LuZening/6x2-Antenna-Switch/manual/relay_cable.jpg

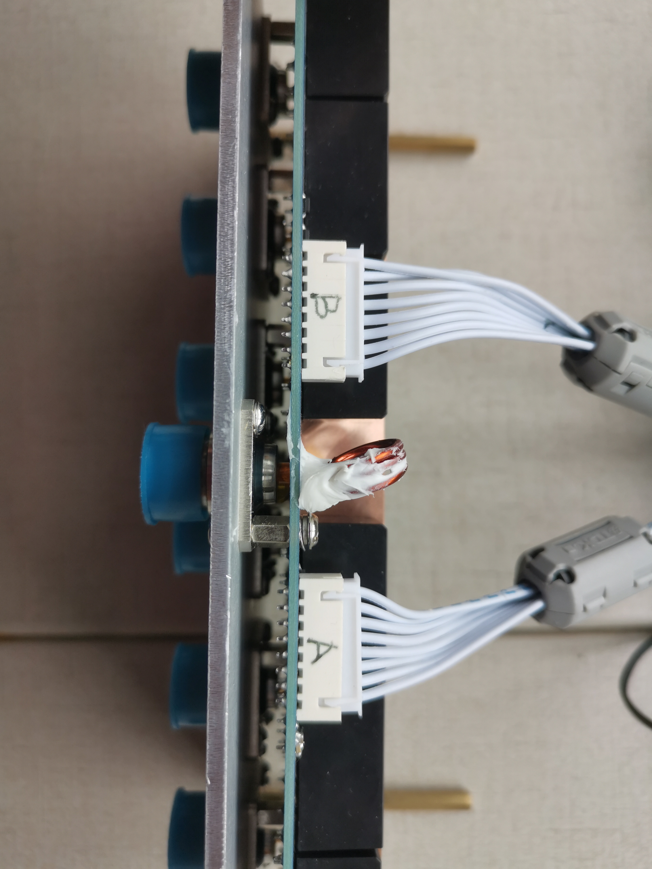
manual/relay_cable.jpg
