LuZening/6x2-Antenna-Switch/manual/changeA.jpg

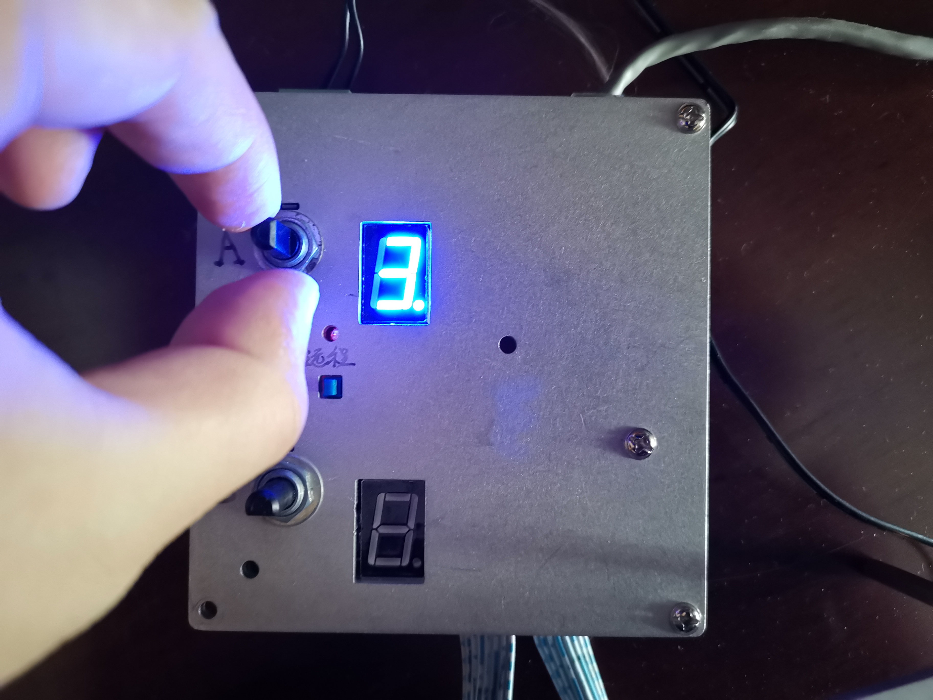
manual/changeA.jpg
