LuZening/6x2-Antenna-Switch/pictures/QUARTUS.PNG

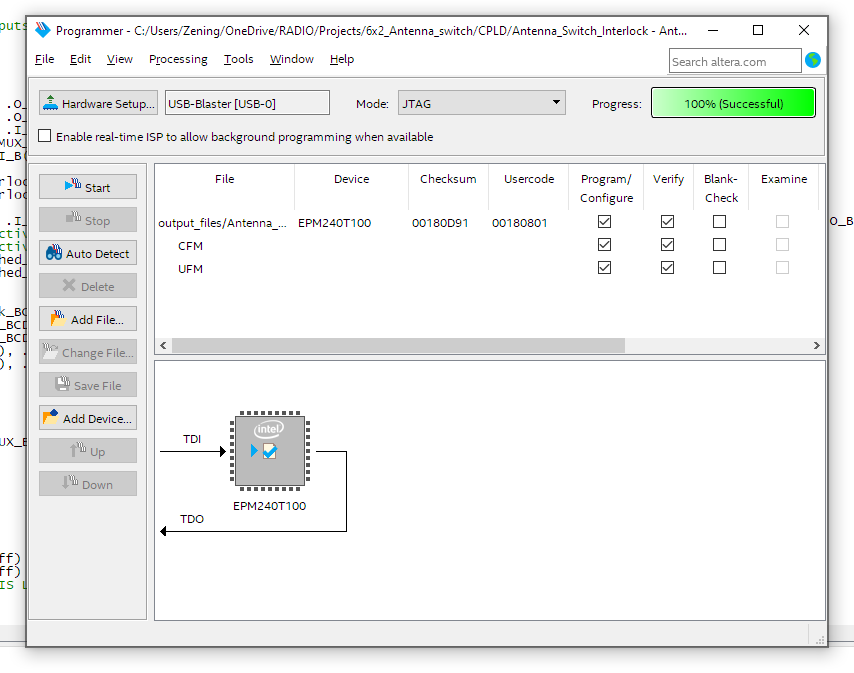
pictures/QUARTUS.PNG
