LuZening/6x2-Antenna-Switch/PCB/history_versions/ControlBoard-2/BOM_190349A_Y10.xls

客户BOM清单 |  |  |  |  |  |  |  |  | 嘉立创用料信息
Comment | Description | Designator | Footprint | LibRef | Pins | Quantity | PartNumber | url | 匹配类型 | 匹配方式 | 匹配来源 | 顶层位号 | 顶层数 | 顶层贴装 | 底层位号 | 底层数 | 底层贴装 | 元件编号 | X-ray检查 | 贴装总数量 | 焊点总数量 | 焊点费小计 | 库类型 | 组装方式 | 元件名称 | 封装规格 | 最小起订数量 | 损耗数量 | 元器件来源 | 使用预订数量 | 工厂提供数量 | 工厂元件单价 | 工厂元件小计 | 收费原因
300 | desc | R57, | 0603_R | libref | 2 | 1 |  |  | 系统识别 | 自动匹配 | 规则匹配 | R57 | 1 | 已贴装 |  | 0 | 未贴装 | C23025 | 不需要 | 2 | 4 | 0.0400 | 基础库 | 贴装 | 300Ω (3000) ±1% | 0603WAF3000T5E | 0603 | 0 | 0 | 嘉立创 | 0 | 2 | 0.0344 | 0.0688 | null
33 | desc | R17,R16,R15,R8,R6,R4,R2,R1,R14,R13,R12,R11,R9,R7,R5,R3, | 0603_R | libref | 2 | 16 |  |  | 系统识别 | 手动匹配 |  | R17, R16, R15, R8, R6, R4, R2, R1, R14, R13, R12, R11, R9, R7, R5, R3 | 16 | 已贴装 |  | 0 | 未贴装 | C23140 | 不需要 | 32 | 64 | 0.6400 | 基础库 | 贴装 | 33Ω (33R0) ±1% | 0603WAF330JT5E | 0603 | 0 | 0 | 嘉立创 | 0 | 32 | 0.0104 | 0.3328 | null
8050 | desc | Q14,Q13,Q12,Q11,Q10,Q9,Q8,Q7,Q6,Q5,Q4,Q3, | SOT-23(SOT-23-3) | libref | 3 | 12 |  |  | 手动调整 | 手动匹配 |  | Q14, Q13, Q12, Q11, Q10, Q9, Q8, Q7, Q6, Q5, Q4, Q3 | 12 | 已贴装 |  | 0 | 未贴装 | C2145 | 不需要 | 24 | 72 | 0.7200 | 基础库 | 贴装 | MMBT5551 | MMBT5551 | SOT-23 | 0 | 0 | 嘉立创 | 0 | 24 | 0.1376 | 3.3024 | null
47pF | desc | C38, | 0603_C | libref | 2 | 1 |  |  | 系统识别 | 手动匹配 |  | C38 | 1 | 已贴装 |  | 0 | 未贴装 | C1671 | 不需要 | 2 | 4 | 0.0400 | 基础库 | 贴装 | 47pF (470) ±5% 50V C0G | CL10C470JB8NNNC | 0603 | 0 | 0 | 嘉立创 | 0 | 2 | 0.1265 | 0.2530 | null
12K | desc | R51, | 0603_R | libref | 2 | 1 |  |  | 系统识别 | 自动匹配 | 规则匹配 | R51 | 1 | 已贴装 |  | 0 | 未贴装 | C22790 | 不需要 | 2 | 4 | 0.0400 | 基础库 | 贴装 | 12KΩ (1202) ±1% | 0603WAF1202T5E | 0603 | 0 | 0 | 嘉立创 | 0 | 2 | 0.0131 | 0.0262 | null
49.9 | desc | R49,R48,R45,R44, | 0603_R | libref | 2 | 4 |  |  | 系统识别 | 手动匹配 |  | R49, R48, R45, R44 | 4 | 已贴装 |  | 0 | 未贴装 | C23185 | 不需要 | 8 | 16 | 0.1600 | 基础库 | 贴装 | 49.9Ω (49R9) ±1% | 0603WAF499JT5E | 0603 | 0 | 0 | 嘉立创 | 0 | 8 | 0.0122 | 0.0976 | null
8550 | desc | Q26,Q25,Q24,Q23,Q22,Q21,Q20,Q19,Q18,Q17,Q16,Q15,Q2,Q1, | SOT-23(SOT-23-3) | libref | 3 | 14 |  |  | 手动调整 | 手动匹配 |  | Q26, Q25, Q24, Q23, Q22, Q21, Q20, Q19, Q18, Q17, Q16, Q15, Q2, Q1 | 14 | 已贴装 |  | 0 | 未贴装 | C8326 | 不需要 | 28 | 84 | 0.8400 | 基础库 | 贴装 | MMBT5401 | MMBT5401 | SOT-23 | 0 | 0 | 嘉立创 | 0 | 28 | 0.1414 | 3.9592 | null
MAX485E | desc | U6, | SOIC-8_W3.9mm | libref | 8 | 1 |  |  | 系统识别 | 手动匹配 |  | U6 | 1 | 已贴装 |  | 0 | 未贴装 | C8963 | 不需要 | 2 | 16 | 0.1600 | 基础库 | 贴装 | SP3485EN-L/TR | SP3485EN-L/TR | SOIC-8 | 0 | 0 | 嘉立创 | 0 | 2 | 2.7328 | 5.4656 | null
0 | desc | R20, | 1206_R | libref | 2 | 1 |  |  | 系统识别 | 自动匹配 | 规则匹配 | R20 | 1 | 已贴装 |  | 0 | 未贴装 | C17888 | 不需要 | 2 | 4 | 0.0400 | 基础库 | 贴装 | 0Ω (0R0) ±1% | 1206W4F0000T5E | 1206 | 0 | 0 | 嘉立创 | 0 | 2 | 0.0282 | 0.0564 | null
10pF | desc | C34,C35, | 0603_C | libref | 2 | 2 |  |  | 系统识别 | 手动匹配 |  | C34, C35 | 2 | 已贴装 |  | 0 | 未贴装 | C1634 | 不需要 | 4 | 8 | 0.0800 | 基础库 | 贴装 | 10pF (100) ±5% 50V C0G | CL10C100JB8NNNC | 0603 | 0 | 0 | 嘉立创 | 0 | 4 | 0.0464 | 0.1856 | null
104 | desc | C43,C8,C6,C39,C36,C33,C32,C31,C30,C29,C28,C26,C25,C24,C23,C22,C21,C20,C19,C18,C17,C16,C15,C14,C13,C12,C9,C7,C5,C4,C3,C2,C1, | 0603_C | libref | 2 | 33 |  |  | 系统识别 | 手动匹配 |  | C43, C8, C6, C39, C36, C33, C32, C31, C30, C29, C28, C26, C25, C24, C23, C22, C21, C20, C19, C18, C17, C16, C15, C14, C13, C12, C9, C7, C5, C4, C3, C2, C1 | 33 | 已贴装 |  | 0 | 未贴装 | C14663 | 不需要 | 66 | 132 | 1.3200 | 基础库 | 贴装 | 100nF (104) ±10% 50V X7R | CC0603KRX7R9BB104 | 0603 | 0 | 0 | 嘉立创 | 0 | 66 | 0.0349 | 2.3034 | null
10nF | desc | C37, | 0603_C | libref | 2 | 1 |  |  | 系统识别 | 手动匹配 |  | C37 | 1 | 已贴装 |  | 0 | 未贴装 | C57112 | 不需要 | 2 | 4 | 0.0400 | 基础库 | 贴装 | 10nF (103) ±10% 50V X7R | 0603B103K500NT | 0603 | 0 | 0 | 嘉立创 | 0 | 2 | 0.0266 | 0.0532 | null
10K | desc | R50, | 0603_R | libref | 2 | 1 |  |  | 系统识别 | 自动匹配 | 规则匹配 | R50 | 1 | 已贴装 |  | 0 | 未贴装 | C25804 | 不需要 | 2 | 4 | 0.0400 | 基础库 | 贴装 | 10KΩ (1002) ±1% | 0603WAF1002T5E | 0603 | 0 | 0 | 嘉立创 | 0 | 2 | 0.0104 | 0.0208 | null
STM32F030C8Tx | desc | U5, | LQFP-48_7X7X05P | libref | 48 | 1 |  |  | 手动调整 | 手动匹配 |  | U5 | 1 | 已贴装 |  | 0 | 未贴装 | C23922 | 不需要 | 2 | 96 | 0.9600 | 基础库 | 贴装 | STM32F030C8T6 | STM32F030C8T6 | LQFP-48(7x7) | 0 | 0 | 嘉立创 | 0 | 2 | 5.7543 | 11.5086 | null
100K | desc | R59*1,R56,R55, | 0603_R | libref | 2 | 3 |  |  | 系统识别 | 手动匹配 |  | R59*1, R56, R55 | 3 | 已贴装 |  | 0 | 未贴装 | C25803 | 不需要 | 6 | 12 | 0.1200 | 基础库 | 贴装 | 100KΩ (1003) ±1% | 0603WAF1003T5E | 0603 | 0 | 0 | 嘉立创 | 0 | 6 | 0.0104 | 0.0624 | null
2.2uF | desc | C11, | 0805_C | libref | 2 | 1 |  |  | 系统识别 | 手动匹配 |  | C11 | 1 | 已贴装 |  | 0 | 未贴装 | C49217 | 不需要 | 4 | 8 | 0.0800 | 基础库 | 贴装 | 2.2uF (225) ±20% 50V Y5V | 0805F225M500NT | 0805 | 0 | 0 | 嘉立创 | 0 | 4 | 0.1624 | 0.6496 | null
4.7uF25V | desc | C40, | 0805_C | libref | 2 | 1 |  |  | 手动调整 | 手动匹配 |  | C40 | 1 | 已贴装 |  | 0 | 未贴装 | C49217 | 不需要
100 | desc | R52, | 0603_R | libref | 2 | 1 |  |  | 系统识别 | 自动匹配 | 规则匹配 | R52 | 1 | 已贴装 |  | 0 | 未贴装 | C22775 | 不需要 | 2 | 4 | 0.0400 | 基础库 | 贴装 | 100Ω (1000) ±1% | 0603WAF1000T5E | 0603 | 0 | 0 | 嘉立创 | 0 | 2 | 0.0104 | 0.0208 | null
4.7K | desc | R37,R36,R35,R34,R33,R32,R31,R30,R29,R28,R27,R26,R25, | 0603_R | libref | 2 | 13 |  |  | 手动调整 | 手动匹配 |  | R37, R36, R35, R34, R33, R32, R31, R30, R29, R28, R27, R26, R25 | 13 | 已贴装 |  | 0 | 未贴装 | C4190 | 不需要 | 26 | 52 | 0.5200 | 基础库 | 贴装 | 2.2KΩ (2201) ±1% | 0603WAF2201T5E | 0603 | 0 | 0 | 嘉立创 | 0 | 26 | 0.0106 | 0.2756 | null
22uF | desc | C42,C10, | 0805_C | libref | 2 | 2 |  |  | 系统识别 | 手动匹配 |  | C42, C10 | 2 | 已贴装 |  | 0 | 未贴装 | C45783 | 不需要 | 4 | 8 | 0.0800 | 基础库 | 贴装 | 22uF (226) ±20% 25V X5R | CL21A226MAQNNNE | 0805 | 0 | 0 | 嘉立创 | 0 | 4 | 0.2299 | 0.9196 | null
51K | desc | R59, | 0603_R | libref | 2 | 1 |  |  | 系统识别 | 自动匹配 | 规则匹配 | R59 | 1 | 已贴装 |  | 0 | 未贴装 | C23196 | 不需要 | 2 | 4 | 0.0400 | 基础库 | 贴装 | 51KΩ (5102) ±1% | 0603WAF5102T5E | 0603 | 0 | 0 | 嘉立创 | 0 | 2 | 0.0142 | 0.0284 | null
1K | desc | R19,R54,R10,R53,R18, | 0603_R | libref | 2 | 5 |  |  | 系统识别 | 手动匹配 |  | R19, R54, R10, R53, R18 | 5 | 已贴装 |  | 0 | 未贴装 | C21190 | 不需要 | 10 | 20 | 0.2000 | 基础库 | 贴装 | 1KΩ (1001) ±1% | 0603WAF1001T5E | 0603 | 0 | 0 | 嘉立创 | 0 | 10 | 0.0104 | 0.1040 | null
10uF | desc | C41, | 0805_C | libref | 2 | 1 |  |  | 系统识别 | 手动匹配 |  | C41 | 1 | 已贴装 |  | 0 | 未贴装 | C15850 | 不需要 | 2 | 4 | 0.0400 | 基础库 | 贴装 | 10uF (106) ±10% 25V X5R | CL21A106KAYNNNE | 0805 | 0 | 0 | 嘉立创 | 0 | 2 | 0.1408 | 0.2816 | null
15K | desc | R58, | 0603_R | libref | 2 | 1 |  |  | 系统识别 | 自动匹配 | 规则匹配 | R58 | 1 | 已贴装 |  | 0 | 未贴装 | C22809 | 不需要 | 2 | 4 | 0.0400 | 基础库 | 贴装 | 15KΩ (1502) ±1% | 0603WAF1502T5E | 0603 | 0 | 0 | 嘉立创 | 0 | 2 | 0.0109 | 0.0218 | null
47K | desc | R61,R60,R43,R42,R41,R40,R39,R38,R24,R23,R22,R21, | 0603_R | libref | 2 | 12 |  |  | 系统识别 | 手动匹配 |  | R61, R60, R43, R42, R41, R40, R39, R38, R24, R23, R22, R21 | 12 | 已贴装 |  | 0 | 未贴装 | C25819 | 不需要 | 24 | 48 | 0.4800 | 基础库 | 贴装 | 47KΩ (4702) ±1% | 0603WAF4702T5E | 0603 | 0 | 0 | 嘉立创 | 0 | 24 | 0.0256 | 0.6144 | null
SS34 | desc | D3, | SMA(DO-214AC)_S3 | libref | 2 | 1 |  |  | 手动调整 | 手动匹配 |  | D3 | 1 | 已贴装 |  | 0 | 未贴装 | C2480 | 不需要 | 2 | 4 | 0.0400 | 基础库 | 贴装 | SS14 | SS14 | SMA(DO-214AC) | 0 | 0 | 嘉立创 | 0 | 2 | 0.1041 | 0.2082 | null
330 | desc | R47,R46, | 0603_R | libref | 2 | 2 |  |  | 系统识别 | 手动匹配 |  | R47, R46 | 2 | 已贴装 |  | 0 | 未贴装 | C23138 | 不需要 | 4 | 8 | 0.0800 | 基础库 | 贴装 | 330Ω (3300) ±1% | 0603WAF3300T5E | 0603 | 0 | 0 | 嘉立创 | 0 | 4 | 0.0122 | 0.0488 | null
<-以下为不贴装的元件->
CH395Q | desc | U4 | LQFP-64_10X10X05P | libref | 64 | 1
ThroughHoleItems
1A | desc | F1 | R_1812_HandSoldering | libref | 2 | 1
BlasterJTAG | desc | J1 | JTAG_10 | libref | 10 | 1
Remote | desc | D1 | LED_D3.0mm | libref | 2 | 1
AZ1117-3.3 | desc | U8 | SOT-223 | libref | 4 | 1
SWD | desc | J6 | Pin_Header_Straight_1x04_Pitch2.54mm | libref | 4 | 1
Conn_01x01 | desc | J2 | PINTST | libref | 1 | 1
RST | desc | J9 | PINTST | libref | 1 | 1
30MHz | desc | Y1 | Crystal_SMD_3225-4pin_3.2x2.5mm | libref | 4 | 1
SY8303 | desc | U7 | TSOT-23-8_HandSoldering | libref | 8 | 1
HR913550A | desc | J5 | HR913550A | libref | 16 | 1
100K | desc | RV1 | 3362P | libref | 3 | 1
REMOTE | desc | SW4 | K8-7071 | libref | 6 | 1
22uH1A | desc | L1 | L_SMD4030_hand | libref | 2 | 1
74HC04 | desc | U9,U2 | TSSOP-14 | libref | 14 | 2
Conn_01x08 | desc | J4,J3 | JST_XH_B08B-XH-A_08x2.50mm_Straight | libref | 8 | 2
AZ1117-1.8 | desc | U3 | SOT-223 | libref | 4 | 1
12VDC | desc | J8 | PhoenixContact_MSTBA-G_02x5.08mm_Angled | libref | 2 | 1
EPM240T100 | desc | U1 | LQFP-100_14X14X05P | libref | 100 | 1
Red | desc | D4 | LED_D3.0mm | libref | 2 | 1
Conn_01x01 | desc | SC4,SC3,SC2,SC1 | M3_Screwhole | libref | 7 | 4
SRBV170501 | desc | SW2,SW1 | SRBV170501 | libref | 12 | 2
0.56''BLUECA | desc | SEG1,SEG2 | 7SegmentLED_LTS6760_LTS6780 | libref | 10 | 2
485 | desc | J7 | PhoenixContact_MSTBA-G_03x5.08mm_Angled | libref | 3 | 1
LOAD | desc | SW3 | K8-7071 | libref | 6 | 1
16V | desc | D2 | LL-34 | libref | 2 | 1
