LuZening/6x2-Antenna-Switch/chasis/N母法兰小.step

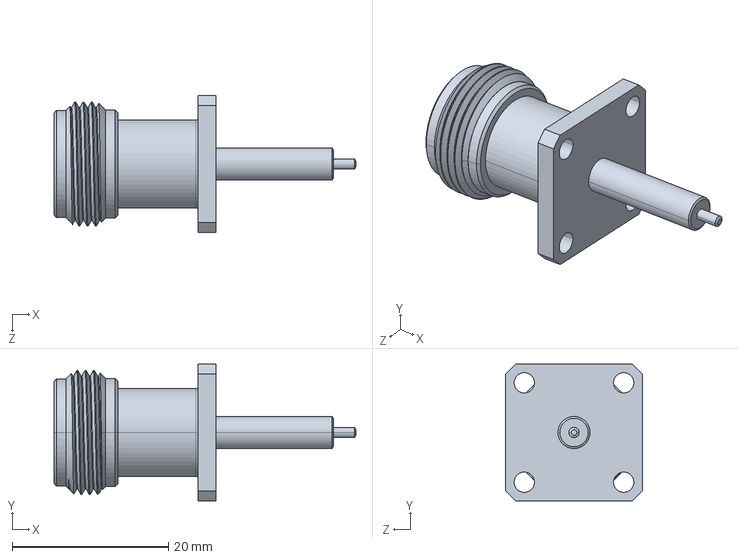
[picture p6: CAD file, 2024-03-04]
chasis/N母法兰小.step
38.6 x 17.5 x 17.5 mm
