LuZening/6x2-Antenna-Switch/chasis/AntennaSwitch_6x2_RelayBoard.step

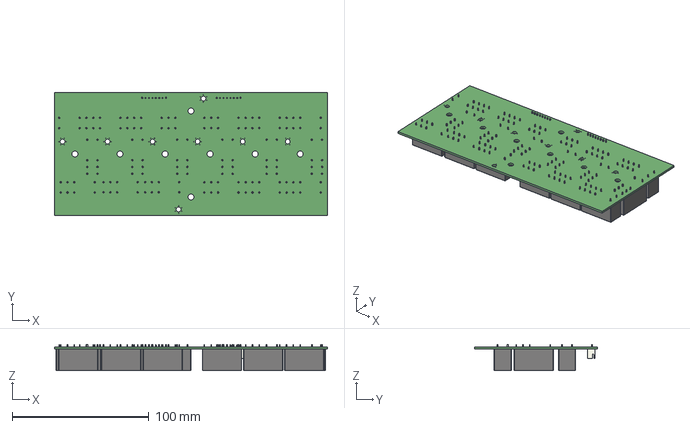
[picture p7: CAD file, 2024-03-04]
chasis/AntennaSwitch_6x2_RelayBoard.step
200.0 x 90.0 x 19.2 mm
