LuZening/6x2-Antenna-Switch/chasis/N母法兰大.step

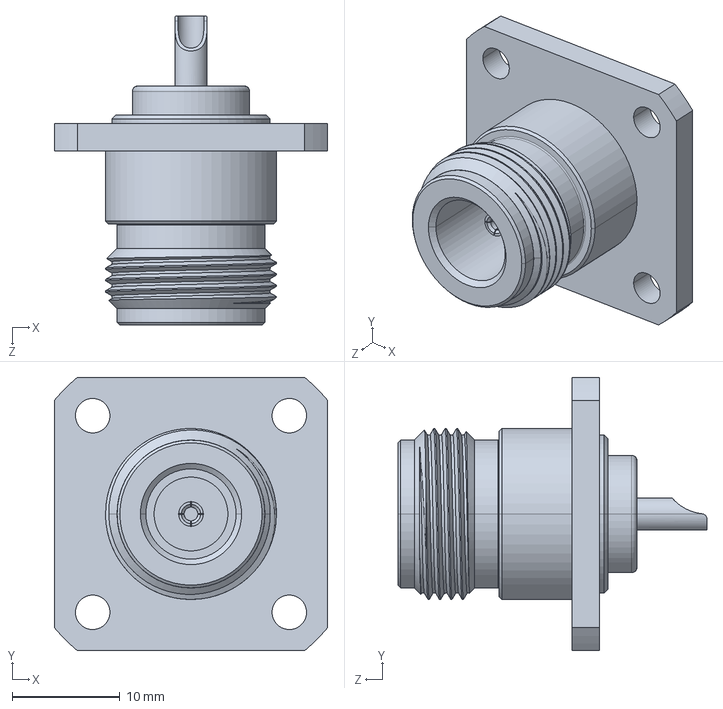
[picture p8: CAD file, 2024-03-04]
chasis/N母法兰大.step
25.4 x 25.4 x 28.7 mm
