LuZening/6x2-Antenna-Switch/chasis/防水盒320_120.SLDPRT

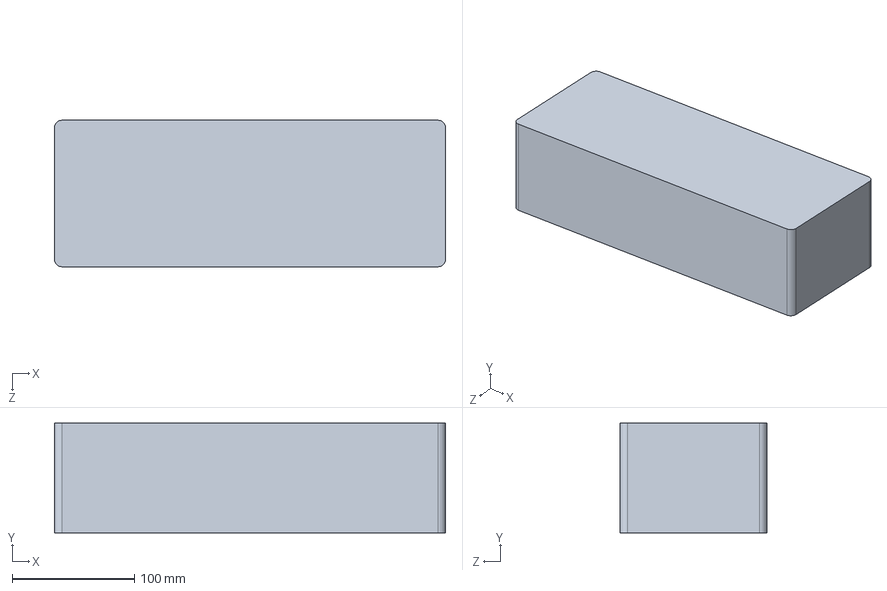
[picture p9: CAD file, 2024-03-04]
chasis/防水盒320_120.SLDPRT
320.0 x 90.0 x 120.0 mm
