LuZening/6x2-Antenna-Switch/(list of files, cad)

Other CAD files:
PCB/history_versions/RelayBoard/RelayBoard_Drill/RelayBoard_Drill.dwg
控制面板.dwg
接口板.dwg
chasis/VT38防水盒_antsw62_示意图.DWG
chasis/aseembled.DWG
chasis/VT38防水盒.dwg
chasis/AntennaSwitch_6x2_RelayBoard.SLDASM
chasis/N母法兰大.SLDPRT
chasis/aseembled.SLDDRW
