LuZening/6x2-Antenna-Switch/manual/all_back.jpg

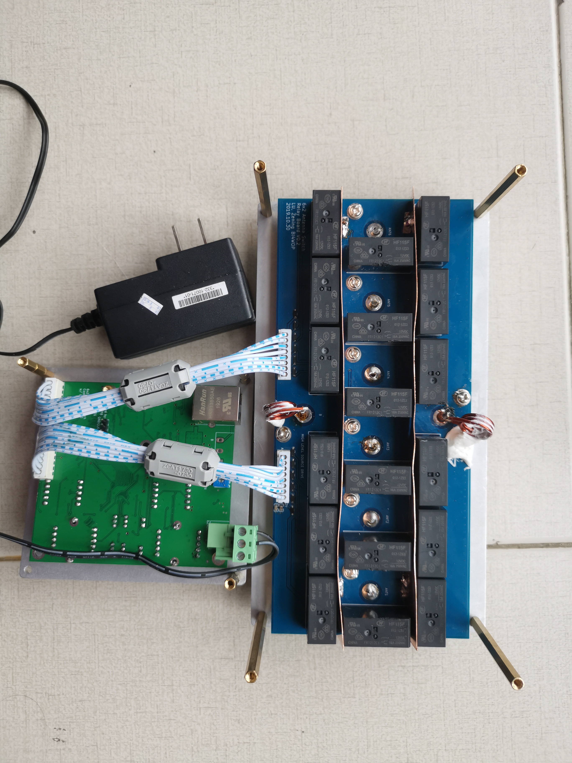
manual/all_back.jpg
