LuZening/6x2-Antenna-Switch/manual/control_cable.jpg

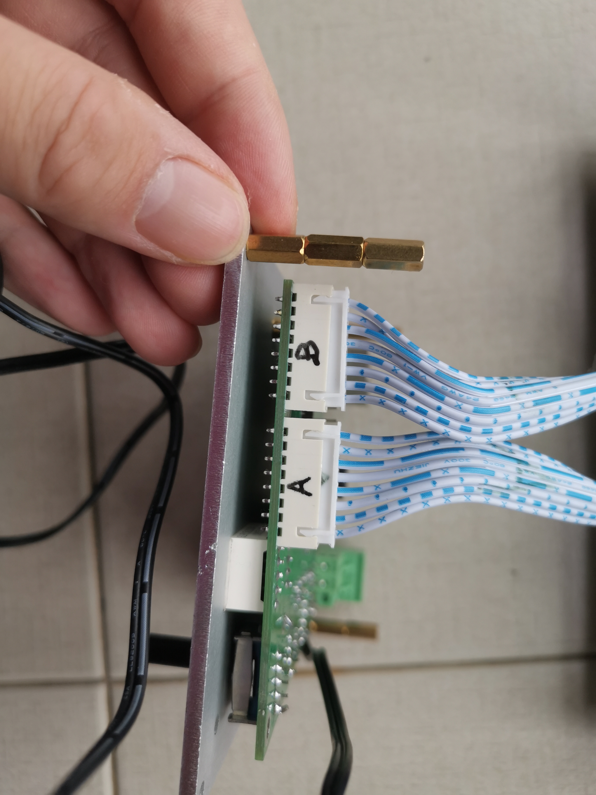
manual/control_cable.jpg
