LuZening/6x2-Antenna-Switch/manual/power.jpg

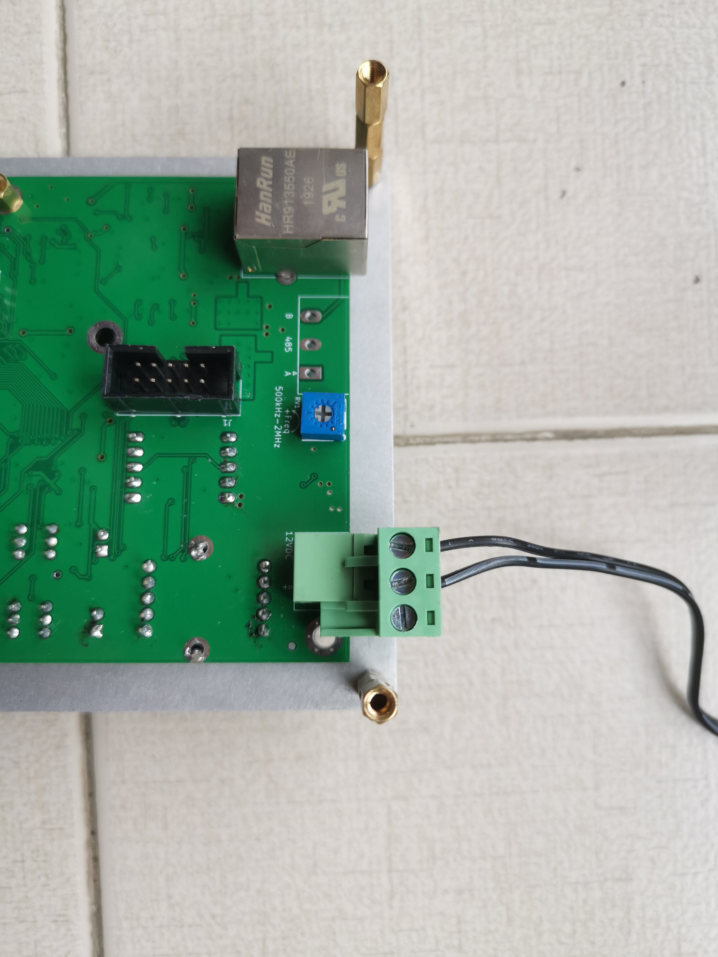
manual/power.jpg
