LuZening/6x2-Antenna-Switch/manual/start.jpg

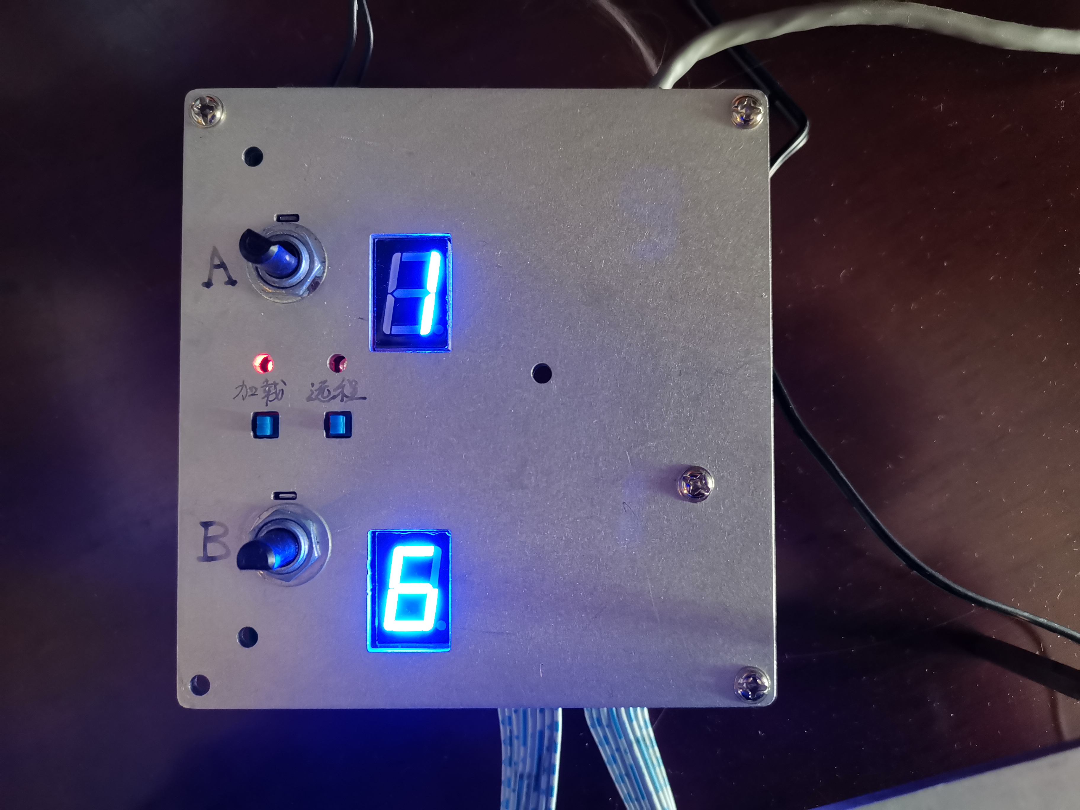
manual/start.jpg
