LuZening/6x2-Antenna-Switch/manual/switch.jpg

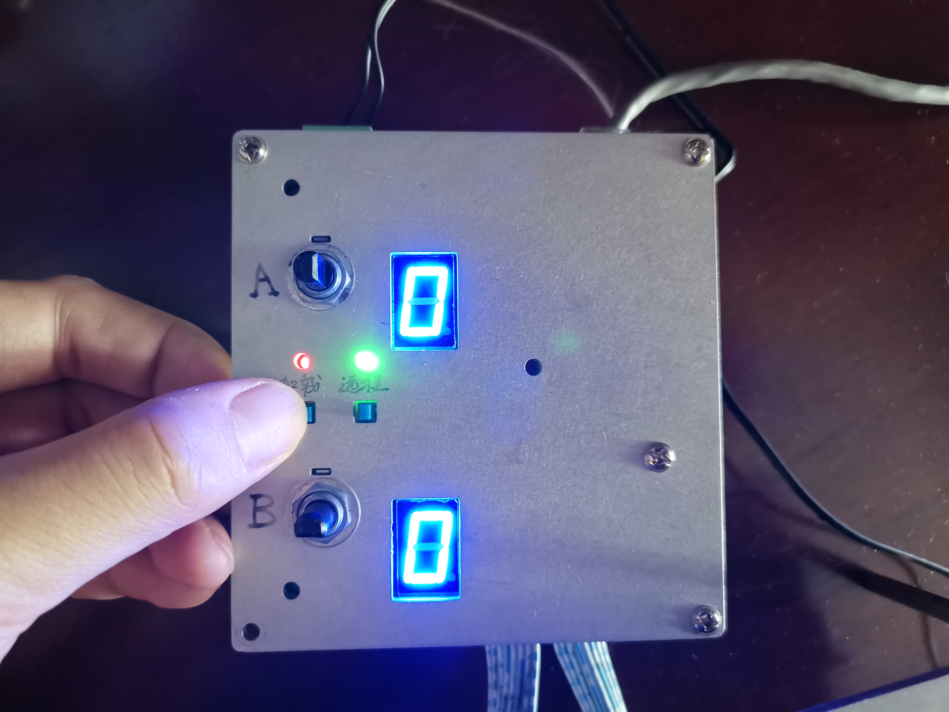
manual/switch.jpg
