LuZening/6x2-Antenna-Switch/manual/switched.jpg

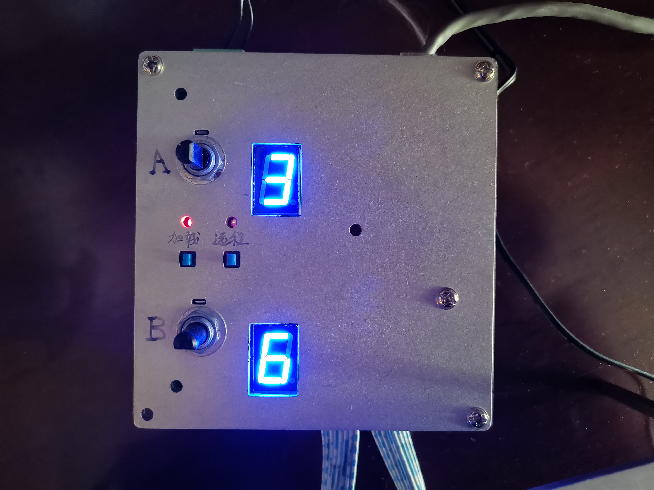
manual/switched.jpg
