LuZening/6x2-Antenna-Switch/PCB/history_versions/AntennaSwitch_6x2/gerber/AntennaSwitch_6x2-B.Cu.pdf

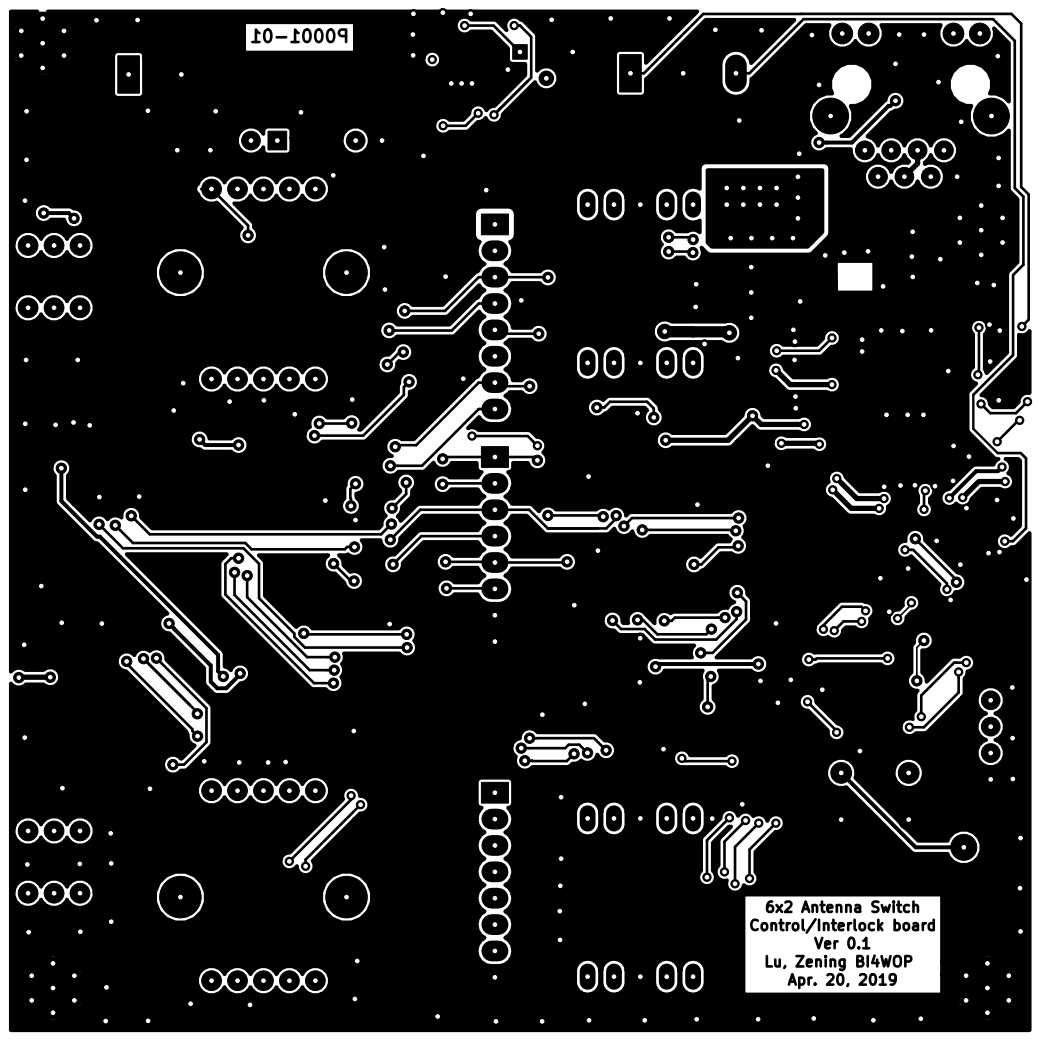
[picture p28: page 1]

6x2 Antenna Switch Control/Interlock board Ver 0.1 Lu, Zening BI4WOP Apr. 20, 2019
