LuZening/6x2-Antenna-Switch/PCB/history_versions/AntennaSwitch_6x2/gerber/AntennaSwitch_6x2-B.SilkS.pdf

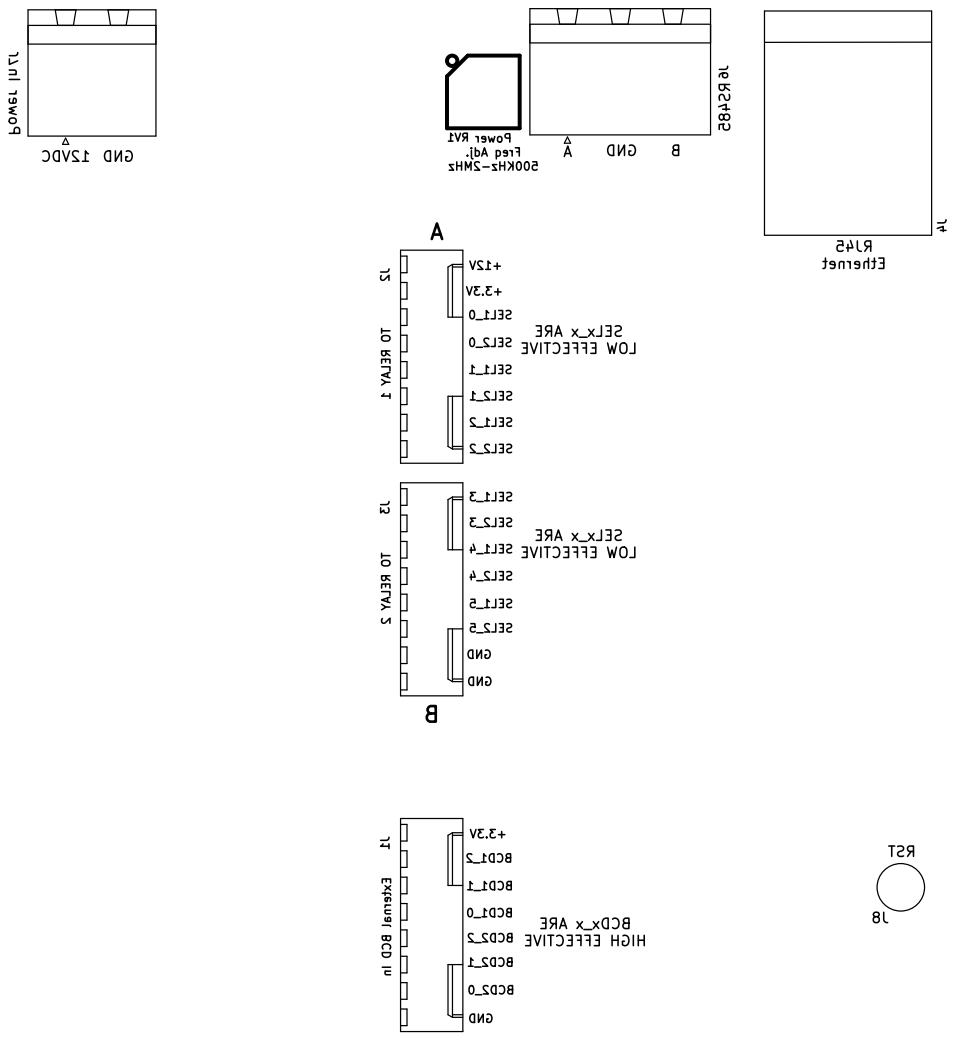
[picture p29: page 1]

+12V External BCD In TO RELAY 2 TO RELAY 1 J8 J4 J6 RV1 J7 J3 J2 J1

Power Freq Adj. 500KHz-2MHz 12VDC GND Power In SELx_x ARE

LOW EFFECTIVE BCDx_x ARE HIGH EFFECTIVE
