LuZening/6x2-Antenna-Switch/PCB/history_versions/AntennaSwitch_6x2/gerber/AntennaSwitch_6x2-B.Mask.pdf

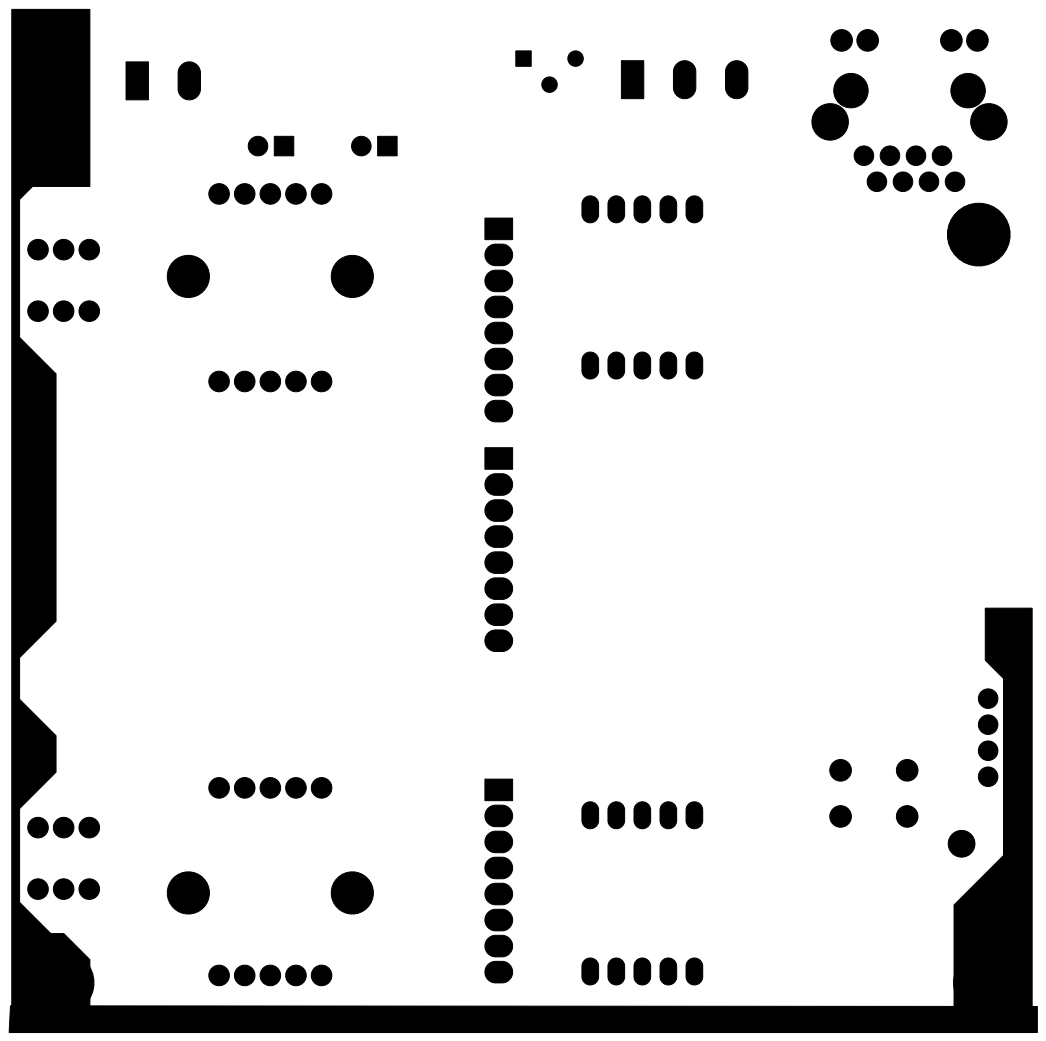
[picture p30: page 1]
