LuZening/6x2-Antenna-Switch/PCB/history_versions/AntennaSwitch_6x2/gerber/AntennaSwitch_6x2-F.Cu.pdf

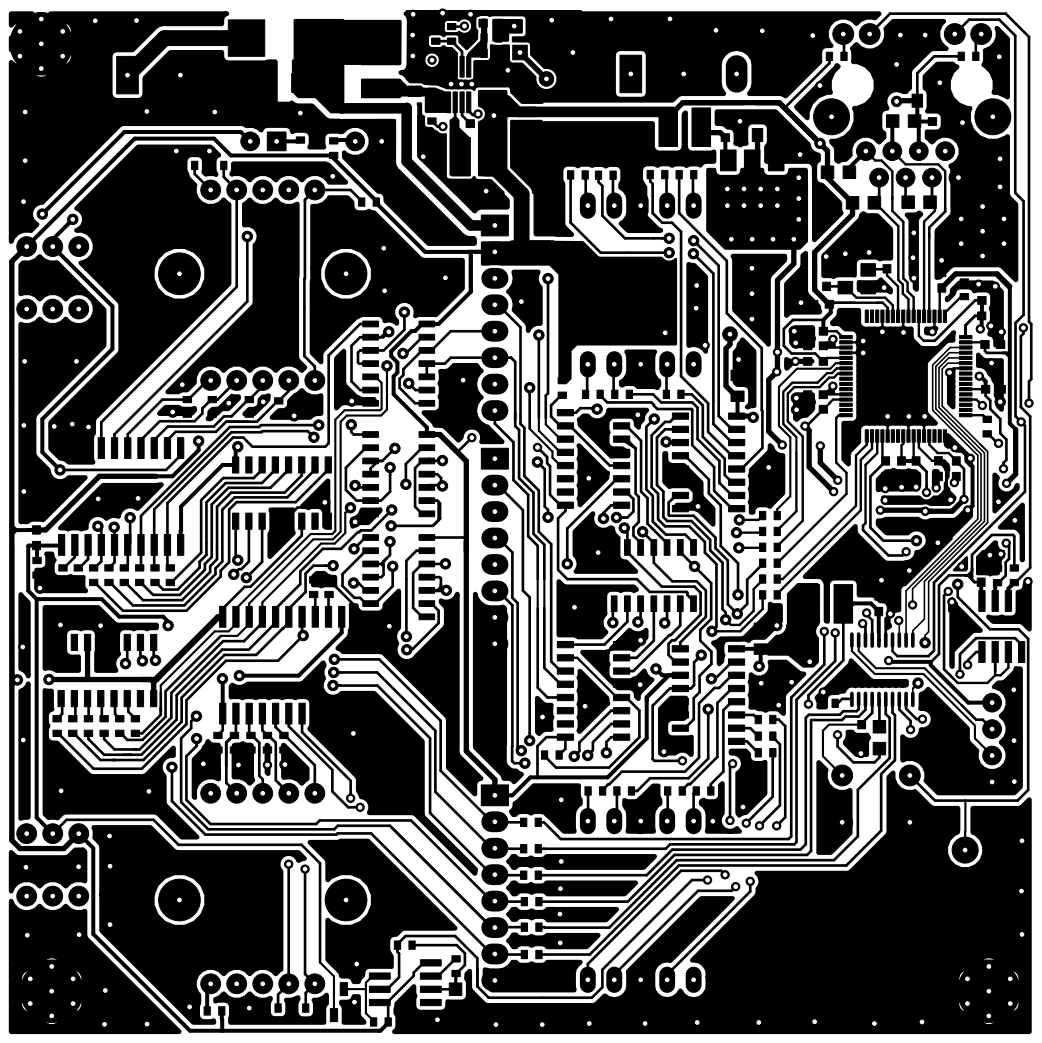
[picture p31: page 1]
