LuZening/6x2-Antenna-Switch/PCB/history_versions/AntennaSwitch_6x2/gerber/AntennaSwitch_6x2-F.Mask.pdf

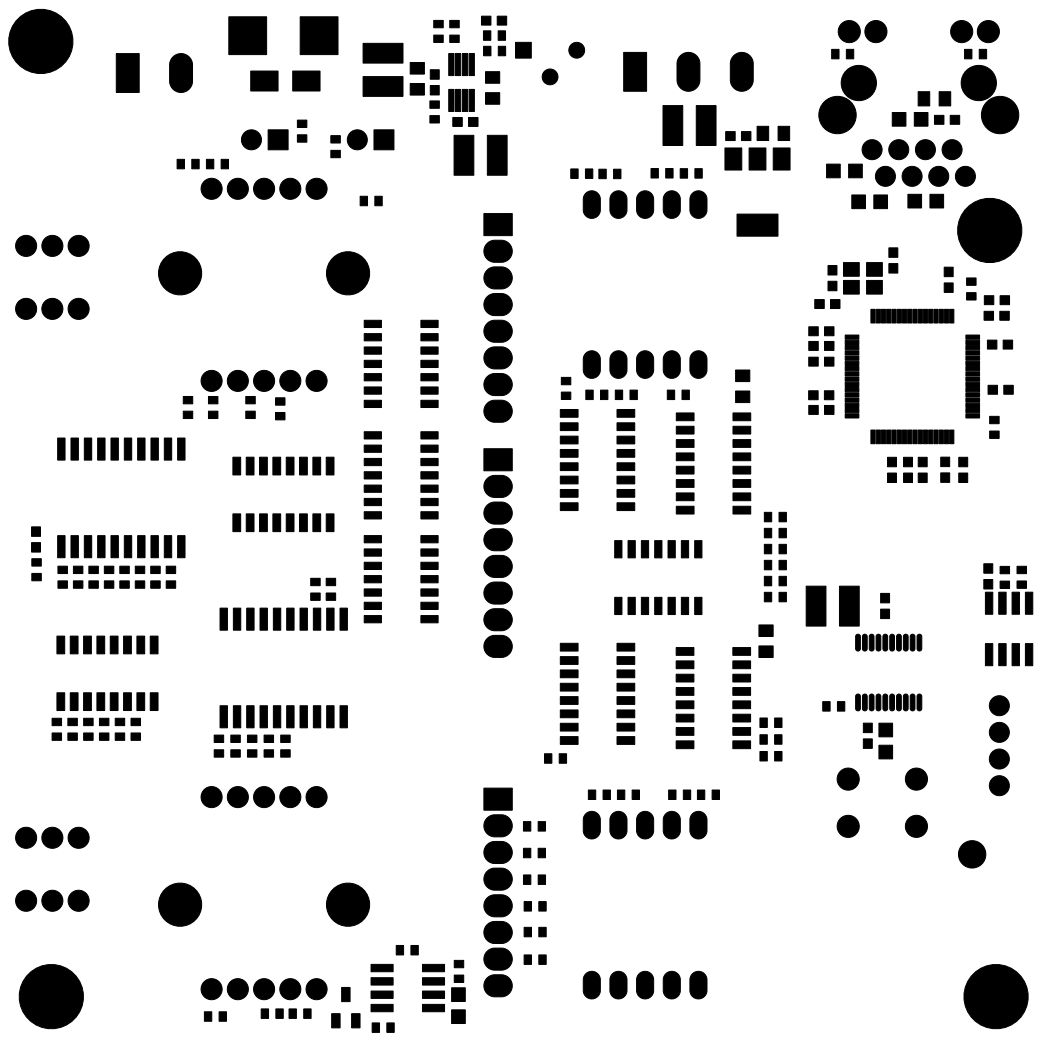
[picture p32: page 1]
