LuZening/6x2-Antenna-Switch/PCB/history_versions/AntennaSwitch_6x2/gerber/AntennaSwitch_6x2-F.SilkS.pdf

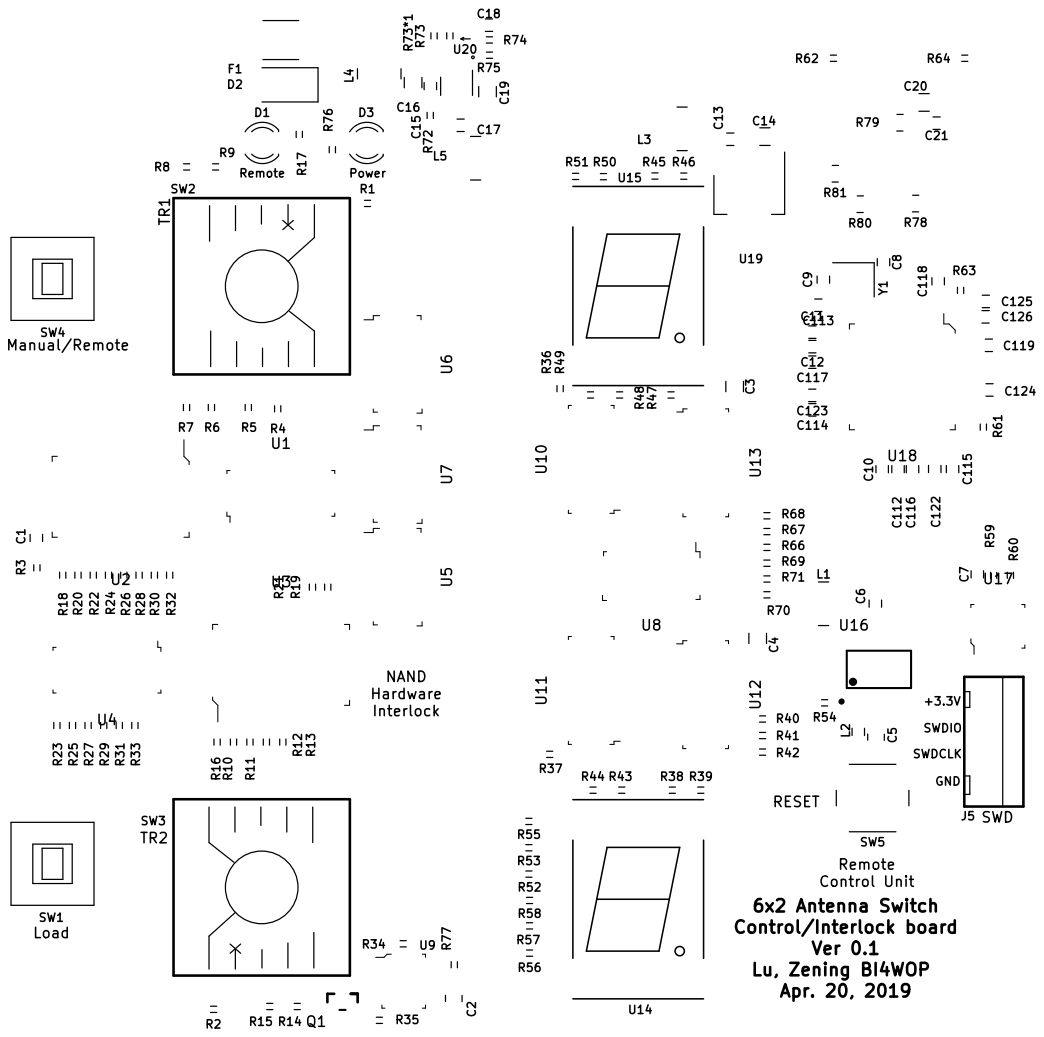
[picture p34: page 1]

Remote Control Unit NAND
Hardware
