LuZening/6x2-Antenna-Switch/PCB/history_versions/RelayBoard/RelayBoard_Drill/board_drill.pdf

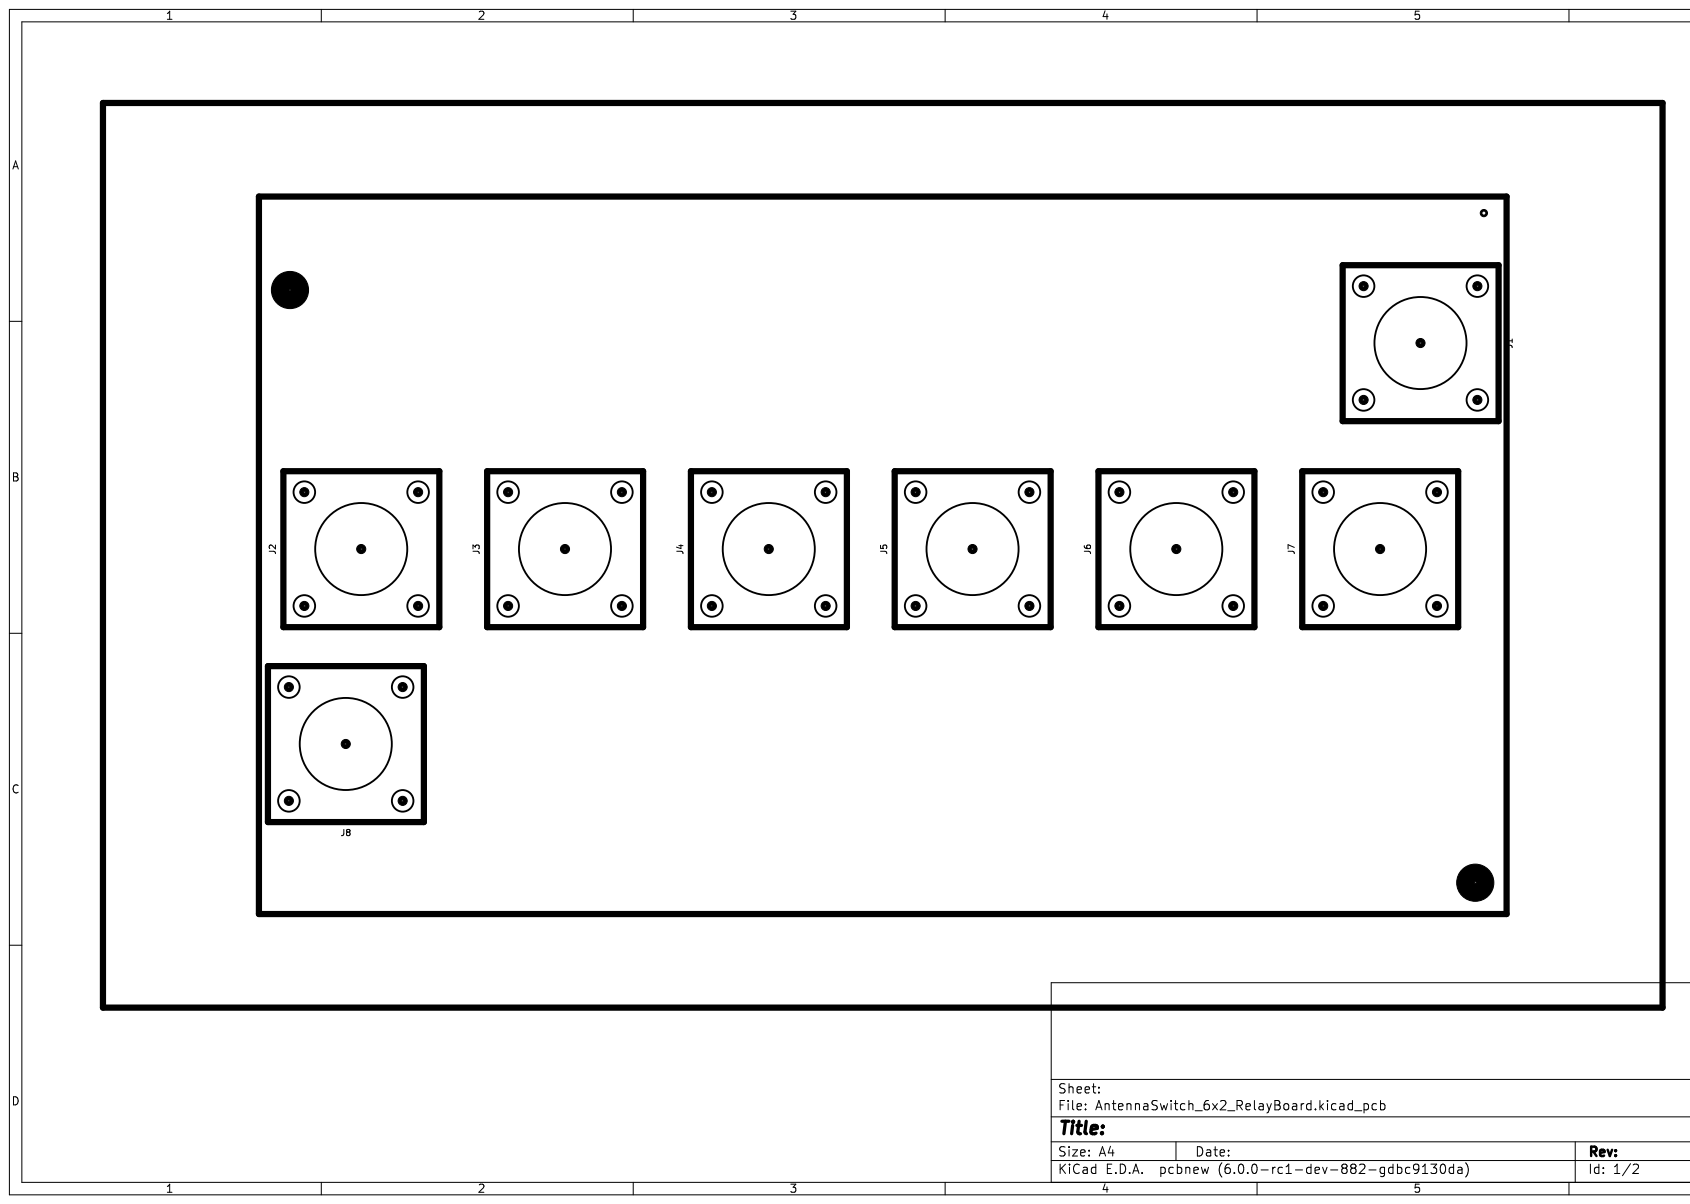
[picture p35: page 1]
