LuZening/6x2-Antenna-Switch/(list of files, drawings)

Other design files:
PCB/ControlBoard-3/AntennaSwitch_6x2.dsn
PCB/history_versions/ControlBoard-2/AntennaSwitch_6x2.dsn
