LuZening/6x2-Antenna-Switch/PCB/history_versions/ControlBoard-2/AntennaSwitch_6x2.kicad_pcb

## KiCad design PCB/history_versions/ControlBoard-2/AntennaSwitch_6x2.kicad_pcb (2024-03-04)

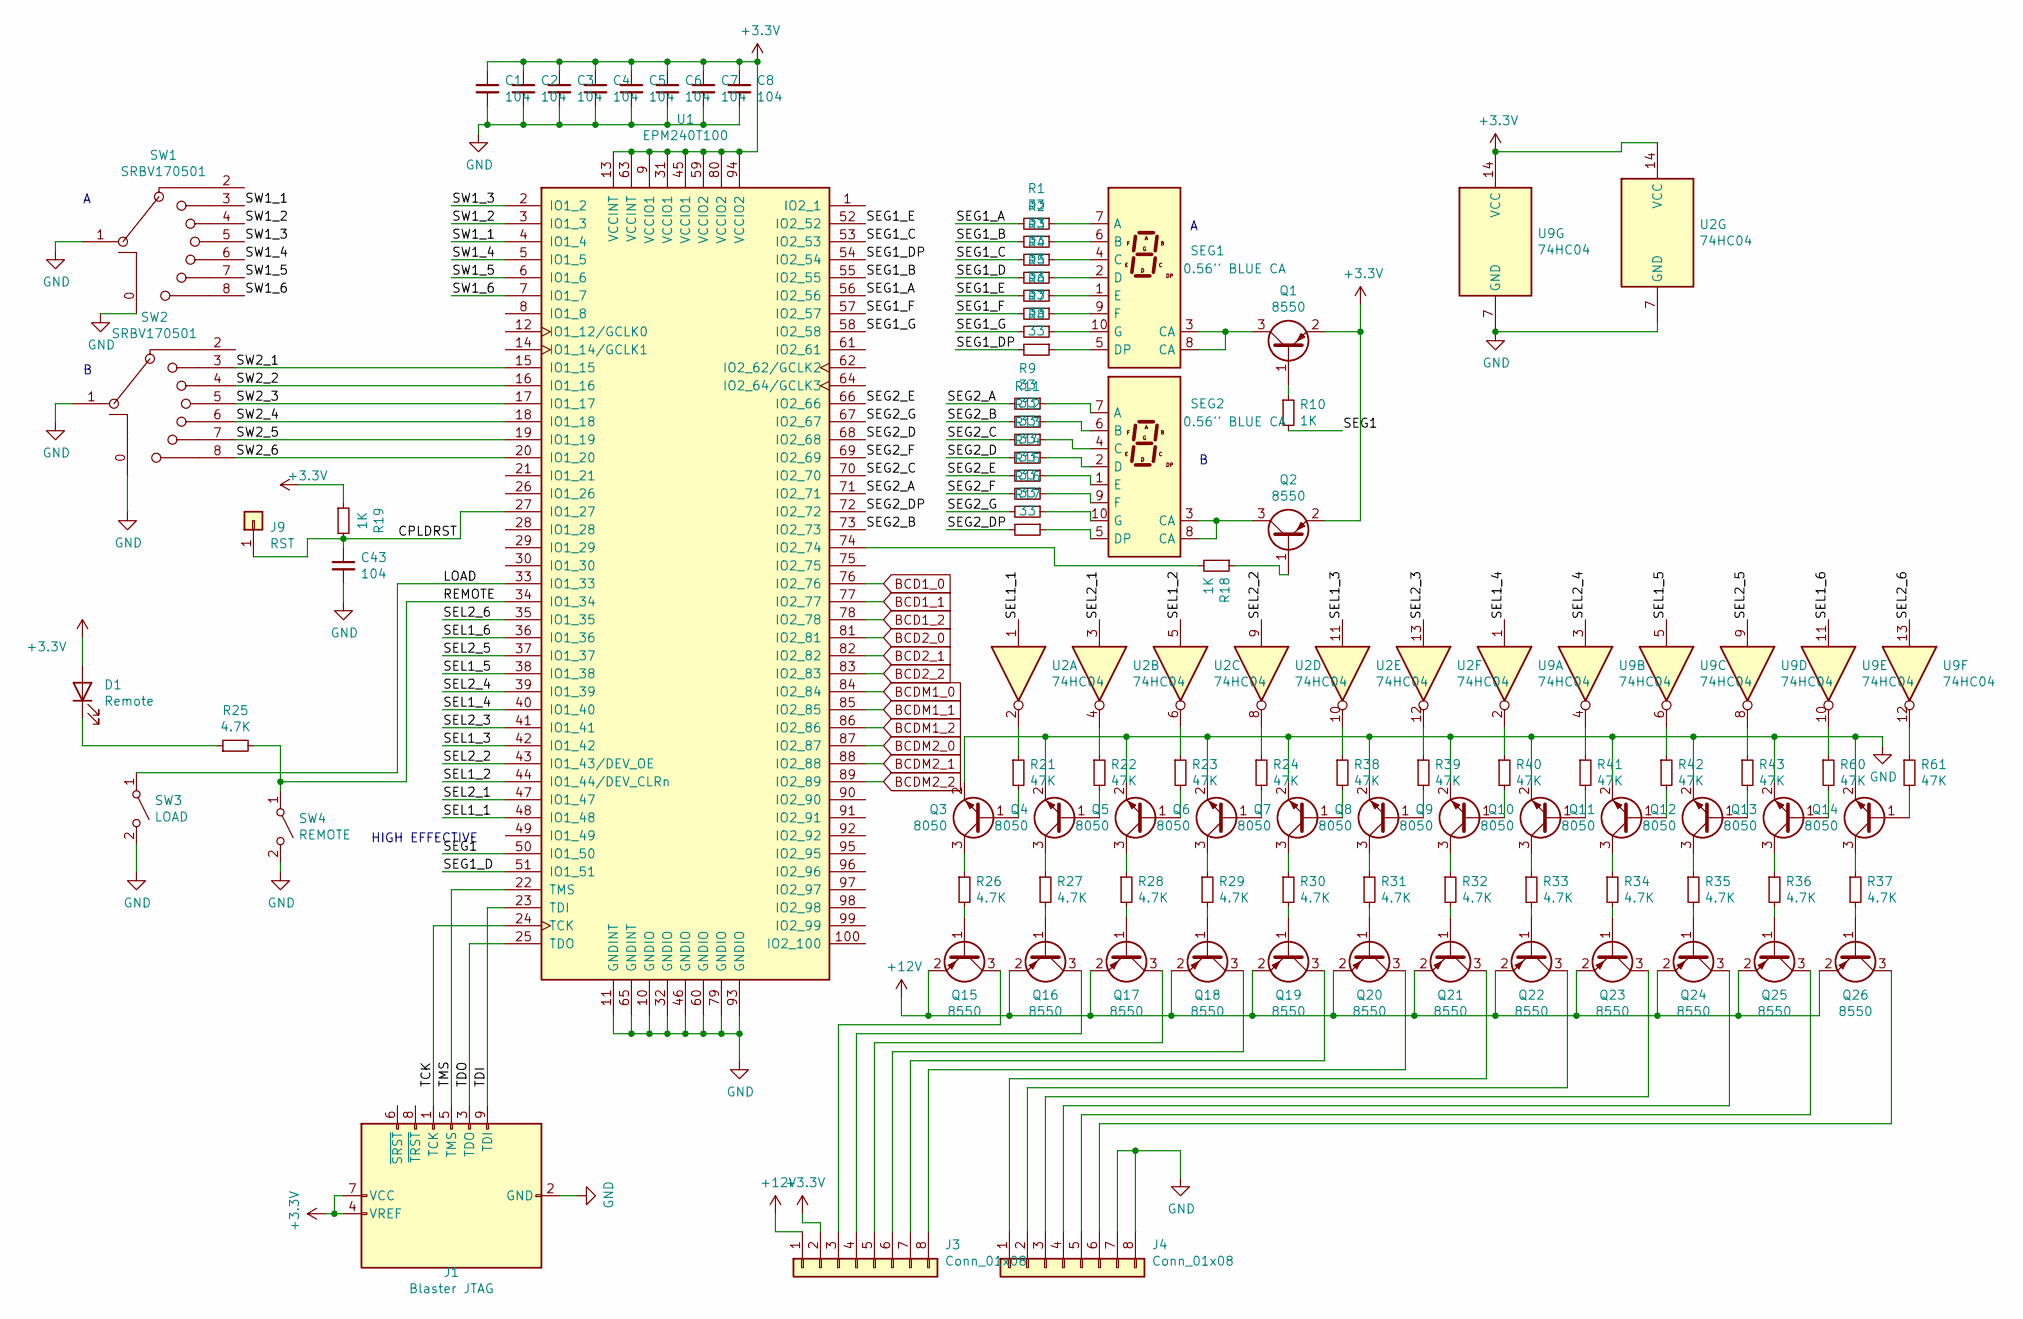
[picture p36: schematic Interlock.sch, 6x2 Antenna Switch Control/Interlock Board - Interlock]

Parts:
C1, C2, C3, C4, C5, C6, C7, C8, C43: 104; 0603_C
D1: Remote; LED_D3.0mm
J1: Blaster JTAG; JTAG_10
J3, J4: Conn_01x08; JST_XH_B08B-XH-A_08x2.50mm_Straight
J9: RST; PINTST
Q1, Q2, Q15, Q16, Q17, Q18, Q19, Q20, Q21, Q22, Q23, Q24, Q25, Q26: 8550; SOT-23(SOT-23-3)
Q3, Q4, Q5, Q6, Q7, Q8, Q9, Q10, Q11, Q12, Q13, Q14: 8050; SOT-23(SOT-23-3)
R1, R2, R3, R4, R5, R6, R7, R8, R9, R11, R12, R13, R14, R15, R16, R17: 33; 0603_R
R10, R18, R19: 1K; 0603_R
R21, R22, R23, R24, R38, R39, R40, R41, R42, R43, R60, R61: 47K; 0603_R
R25, R26, R27, R28, R29, R30, R31, R32, R33, R34, R35, R36, R37: 4.7K; 0603_R
SEG1, SEG2: 0.56'' BLUE CA; 7SegmentLED_LTS6760_LTS6780
SW1, SW2: SRBV170501
SW3: LOAD; K8-7071
SW4: REMOTE; K8-7071
U1: EPM240T100; LQFP-100_14X14X05P
U2, U9: 74HC04; TSSOP-14

Connections:
+3V3: C1.1, C2.1, C3.1, C4.1, C5.1, C6.1, C7.1, C8.1, D1.2 (A), J1.4 (VREF), J1.7 (VCC), J3.2, Q1.2 (E), Q2.2 (E), R19.1, U1.9 (VCCIO1), U1.13 (VCCINT), U1.31 (VCCIO1), U1.45 (VCCIO1), U1.59 (VCCIO2), U1.63 (VCCINT), U1.80 (VCCIO2), U1.94 (VCCIO2), U2.14 (VCC), U9.14 (VCC); also elsewhere on the board
+12V: J3.1, Q15.2 (E), Q16.2 (E), Q17.2 (E), Q18.2 (E), Q19.2 (E), Q20.2 (E), Q21.2 (E), Q22.2 (E), Q23.2 (E), Q24.2 (E), Q25.2 (E), Q26.2 (E); also elsewhere on the board
/Interlock/CPLDRST: C43.1, J9.1, R19.2, U1.27 (IO1_27)
/Interlock/LOAD: SW3.1 (A), U1.33 (IO1_33)
/Interlock/REMOTE: R25.2, SW4.1 (A), U1.34 (IO1_34)
/Interlock/SEG1: R10.2, U1.50 (IO1_50)
/Interlock/SEG1_A: R1.2, U1.56 (IO2_56)
/Interlock/SEG1_B: R2.2, U1.55 (IO2_55)
/Interlock/SEG1_C: R3.2, U1.53 (IO2_53)
/Interlock/SEG1_D: R4.2, U1.51 (IO1_51)
/Interlock/SEG1_DP: R8.2, U1.54 (IO2_54)
/Interlock/SEG1_E: R5.2, U1.52 (IO2_52)
/Interlock/SEG1_F: R6.2, U1.57 (IO2_57)
/Interlock/SEG1_G: R7.2, U1.58 (IO2_58)
/Interlock/SEG2_A: R9.2, U1.71 (IO2_71)
/Interlock/SEG2_B: R11.2, U1.73 (IO2_73)
/Interlock/SEG2_C: R12.2, U1.70 (IO2_70)
/Interlock/SEG2_D: R13.2, U1.68 (IO2_68)
/Interlock/SEG2_DP: R17.2, U1.72 (IO2_72)
/Interlock/SEG2_E: R14.2, U1.66 (IO2_66)
/Interlock/SEG2_F: R15.2, U1.69 (IO2_69)
/Interlock/SEG2_G: R16.2, U1.67 (IO2_67)
/Interlock/SEL1_1: U1.48 (IO1_48), U2.1
/Interlock/SEL1_2: U1.44 (IO1_44/DEV_CLRn), U2.5
/Interlock/SEL1_3: U1.42 (IO1_42), U2.11
/Interlock/SEL1_4: U1.40 (IO1_40), U9.1
/Interlock/SEL1_5: U1.38 (IO1_38), U9.5
/Interlock/SEL1_6: U1.36 (IO1_36), U9.11
/Interlock/SEL2_1: U1.47 (IO1_47), U2.3
/Interlock/SEL2_2: U1.43 (IO1_43/DEV_OE), U2.9
/Interlock/SEL2_3: U1.41 (IO1_41), U2.13
/Interlock/SEL2_4: U1.39 (IO1_39), U9.3
/Interlock/SEL2_5: U1.37 (IO1_37), U9.9
/Interlock/SEL2_6: U1.35 (IO1_35), U9.13
/Interlock/SW1_1: SW1.3, U1.4 (IO1_4)
/Interlock/SW1_2: SW1.4, U1.3 (IO1_3)
/Interlock/SW1_3: SW1.5, U1.2 (IO1_2)
/Interlock/SW1_4: SW1.6, U1.5 (IO1_5)
/Interlock/SW1_5: SW1.7, U1.6 (IO1_6)
/Interlock/SW1_6: SW1.8, U1.7 (IO1_7)
/Interlock/SW2_1: SW2.3, U1.15 (IO1_15)
/Interlock/SW2_2: SW2.4, U1.16 (IO1_16)
/Interlock/SW2_3: SW2.5, U1.17 (IO1_17)
/Interlock/SW2_4: SW2.6, U1.18 (IO1_18)
/Interlock/SW2_5: SW2.7, U1.19 (IO1_19)
/Interlock/SW2_6: SW2.8, U1.20 (IO1_20)
/Interlock/TCK: J1.1 (TCK), U1.24 (TCK)
/Interlock/TDI: J1.9 (TDI), U1.23 (TDI)
/Interlock/TDO: J1.3 (TDO), U1.25 (TDO)
/Interlock/TMS: J1.5 (TMS), U1.22 (TMS)
BCD1_0: U1.76 (IO2_76); also elsewhere on the board
BCD1_1: U1.77 (IO2_77); also elsewhere on the board
BCD1_2: U1.78 (IO2_78); also elsewhere on the board
BCD2_0: U1.81 (IO2_81); also elsewhere on the board
BCD2_1: U1.82 (IO2_82); also elsewhere on the board
BCD2_2: U1.83 (IO2_83); also elsewhere on the board
BCDM1_0: U1.84 (IO2_84); also elsewhere on the board
BCDM1_1: U1.85 (IO2_85); also elsewhere on the board
BCDM1_2: U1.86 (IO2_86); also elsewhere on the board
BCDM2_0: U1.87 (IO2_87); also elsewhere on the board
BCDM2_1: U1.88 (IO2_88); also elsewhere on the board
BCDM2_2: U1.89 (IO2_89); also elsewhere on the board
unnamed: D1.1 (K), R25.1
unnamed: J3.3, Q15.3 (C)
unnamed: J3.4, Q16.3 (C)
unnamed: J3.5, Q17.3 (C)
unnamed: J3.6, Q18.3 (C)
unnamed: J3.7, Q19.3 (C)
unnamed: J3.8, Q20.3 (C)
unnamed: J4.1, Q21.3 (C)
unnamed: J4.2, Q22.3 (C)
unnamed: J4.3, Q23.3 (C)
unnamed: J4.4, Q24.3 (C)
unnamed: J4.5, Q25.3 (C)
unnamed: J4.6, Q26.3 (C)
unnamed: Q1.1 (B), R10.1
unnamed: Q1.3 (C), SEG1.3 (CA), SEG1.8 (CA)
unnamed: Q2.1 (B), R18.1
unnamed: Q2.3 (C), SEG2.3 (CA), SEG2.8 (CA)
unnamed: Q3.1 (B), R21.2
unnamed: Q3.3 (C), R26.1
unnamed: Q4.1 (B), R22.2
unnamed: Q4.3 (C), R27.1
unnamed: Q5.1 (B), R23.2
unnamed: Q5.3 (C), R28.1
unnamed: Q6.1 (B), R24.2
unnamed: Q6.3 (C), R29.1
unnamed: Q7.1 (B), R38.2
unnamed: Q7.3 (C), R30.1
unnamed: Q8.1 (B), R39.2
unnamed: Q8.3 (C), R31.1
unnamed: Q9.1 (B), R40.2
unnamed: Q9.3 (C), R32.1
unnamed: Q10.1 (B), R41.2
unnamed: Q10.3 (C), R33.1
unnamed: Q11.1 (B), R42.2
unnamed: Q11.3 (C), R34.1
unnamed: Q12.1 (B), R43.2
unnamed: Q12.3 (C), R35.1
unnamed: Q13.1 (B), R60.2
unnamed: Q13.3 (C), R36.1
unnamed: Q14.1 (B), R61.2
unnamed: Q14.3 (C), R37.1
unnamed: Q15.1 (B), R26.2
unnamed: Q16.1 (B), R27.2
unnamed: Q17.1 (B), R28.2
unnamed: Q18.1 (B), R29.2
unnamed: Q19.1 (B), R30.2
unnamed: Q20.1 (B), R31.2
unnamed: Q21.1 (B), R32.2
unnamed: Q22.1 (B), R33.2
unnamed: Q23.1 (B), R34.2
unnamed: Q24.1 (B), R35.2
unnamed: Q25.1 (B), R36.2
unnamed: Q26.1 (B), R37.2
unnamed: R1.1, SEG1.7 (A)
unnamed: R2.1, SEG1.6 (B)
unnamed: R3.1, SEG1.4 (C)
unnamed: R4.1, SEG1.2 (D)
unnamed: R5.1, SEG1.1 (E)
unnamed: R6.1, SEG1.9 (F)
unnamed: R7.1, SEG1.10 (G)
unnamed: R8.1, SEG1.5 (DP)
unnamed: R9.1, SEG2.7 (A)
unnamed: R11.1, SEG2.6 (B)
unnamed: R12.1, SEG2.4 (C)
unnamed: R13.1, SEG2.2 (D)
unnamed: R14.1, SEG2.1 (E)
unnamed: R15.1, SEG2.9 (F)
unnamed: R16.1, SEG2.10 (G)
unnamed: R17.1, SEG2.5 (DP)
unnamed: R18.2, U1.74 (IO2_74)
unnamed: R21.1, U2.2
unnamed: R22.1, U2.4
unnamed: R23.1, U2.6
unnamed: R24.1, U2.8
unnamed: R38.1, U2.10
unnamed: R39.1, U2.12
unnamed: R40.1, U9.2
unnamed: R41.1, U9.4
unnamed: R42.1, U9.6
unnamed: R43.1, U9.8
unnamed: R60.1, U9.10
unnamed: R61.1, U9.12
chasis: C1.2, C2.2, C3.2, C4.2, C5.2, C6.2, C7.2, C8.2, C43.2, J1.2 (GND), J1.10 (GND), J4.7, J4.8, Q3.2 (E), Q4.2 (E), Q5.2 (E), Q6.2 (E), Q7.2 (E), Q8.2 (E), Q9.2 (E), Q10.2 (E), Q11.2 (E), Q12.2 (E), Q13.2 (E), Q14.2 (E), SW1.0 (Chasis), SW1.1, SW1.10, SW2.0 (Chasis), SW2.1, SW2.10, SW3.2 (B), SW4.2 (B), U1.10 (GNDIO), U1.11 (GNDINT), U1.32 (GNDIO), U1.46 (GNDIO), U1.60 (GNDIO), U1.65 (GNDINT), U1.79 (GNDIO), U1.93 (GNDIO), U2.7 (GND), U9.7 (GND); also elsewhere on the board

Notes on the sheet:
HIGH EFFECTIVE

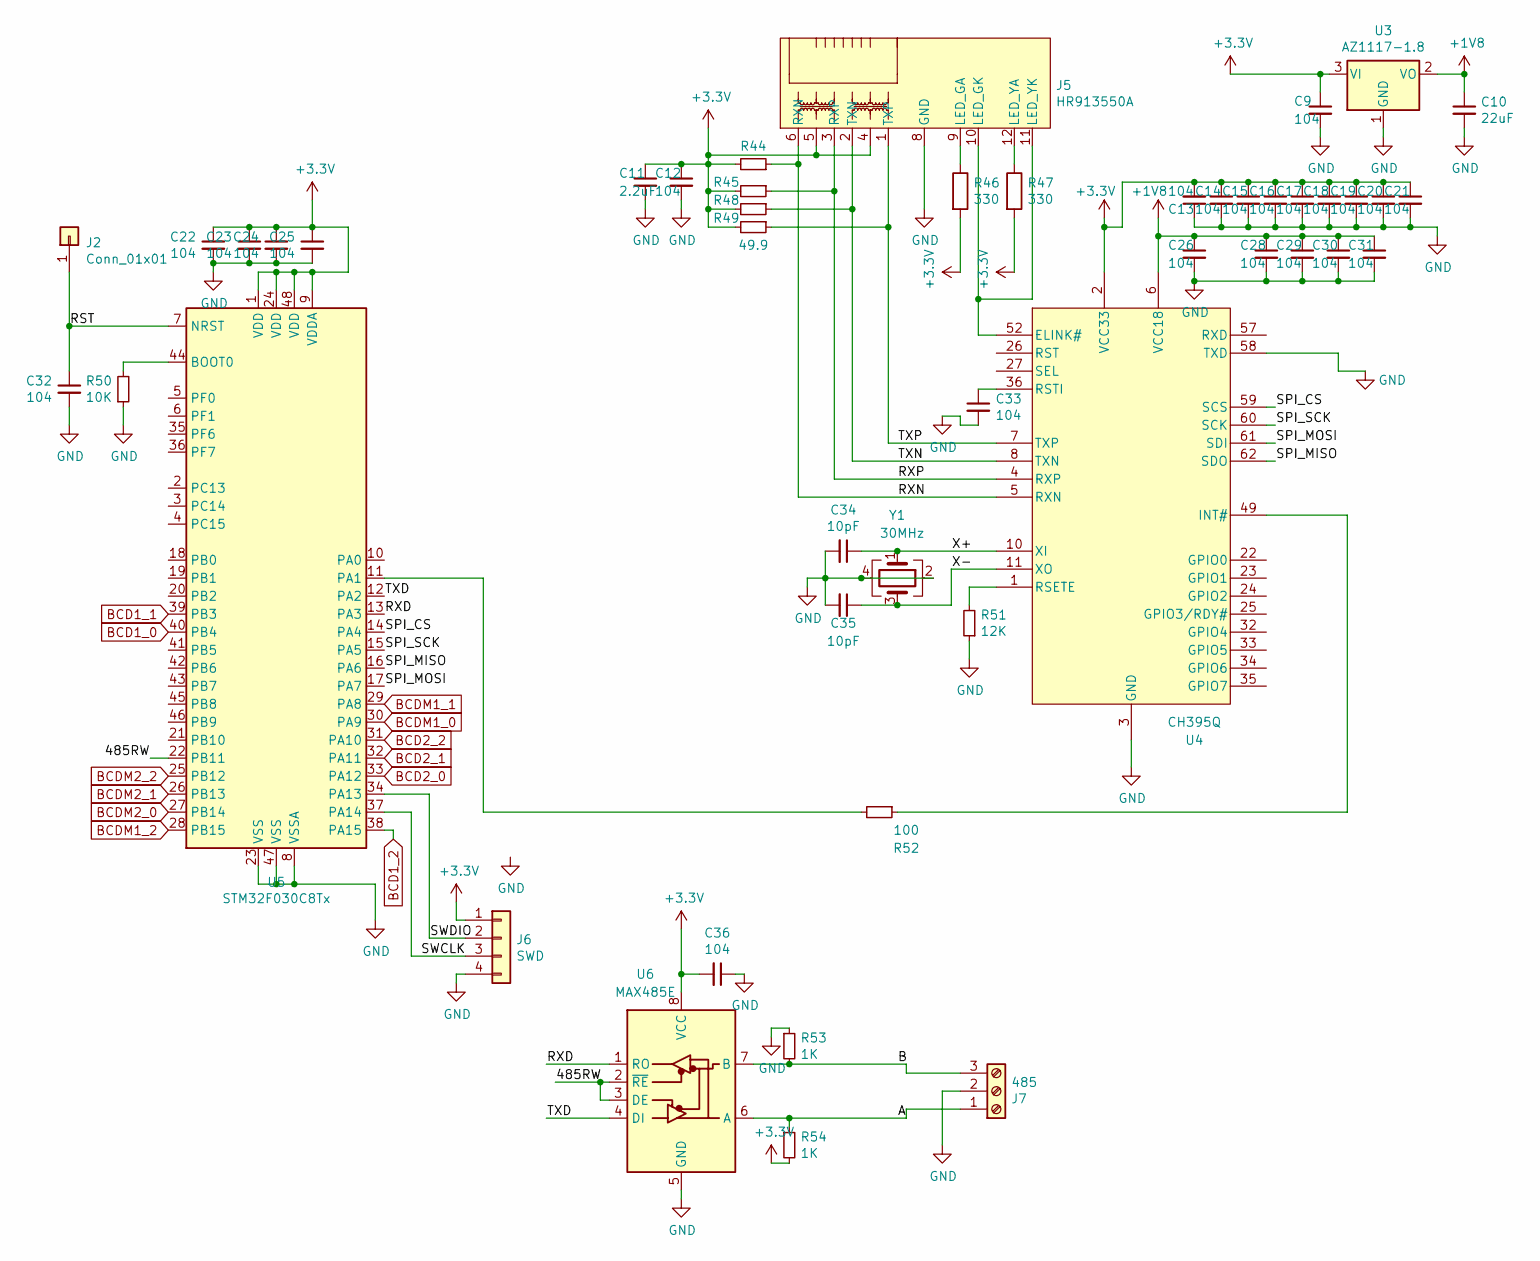
[picture p37: schematic Remote.sch, 6x2 Antenna Switch Control/Interlock Board - Remote Control]

Parts:
C9, C12, C13, C14, C15, C16, C17, C18, C19, C20, C21, C22, C23, C24, C25, C26, C28, C29, C30, C31, C32, C33, C36: 104; 0603_C
C10: 22uF; 0805_C
C11: 2.2uF; 0805_C
C34, C35: 10pF; 0603_C
J2: Conn_01x01; PINTST
J5: HR913550A
J6: SWD; Pin_Header_Straight_1x04_Pitch2.54mm
J7: 485; PhoenixContact_MSTBA-G_03x5.08mm_Angled
R44, R45, R48, R49: 49.9; 0603_R
R46, R47: 330; 0603_R
R50: 10K; 0603_R
R51: 12K; 0603_R
R52: 100; 0603_R
R53, R54: 1K; 0603_R
U3: AZ1117-1.8; SOT-223
U4: CH395Q; LQFP-64_10X10X05P
U5: STM32F030C8Tx; LQFP-48_7X7X05P
U6: MAX485E; SOIC-8_W3.9mm
Y1: 30MHz; Crystal_SMD_3225-4pin_3.2x2.5mm

Connections:
+1V8: C10.1, C26.1, C28.1, C29.1, C30.1, C31.1, U3.2 (VO), U4.6 (VCC18), U4.19 (VCC18), U4.28 (VCC18), U4.43 (VCC18), U4.54 (VCC18), U4.64 (VCC18)
+3V3: C9.1, C11.1, C12.1, C13.2, C14.1, C15.1, C16.1, C17.1, C18.1, C19.1, C20.1, C21.1, C22.1, C23.1, C24.1, C25.1, C36.2, J5.4, J5.5, J6.1, R44.2, R45.2, R46.2, R47.2, R48.2, R49.2, R54.2, U3.3 (VI), U4.2 (VCC33), U4.12 (VCC33), U4.17 (VCC33), U4.21 (VCC33), U4.29 (VCC33), U4.40 (VCC33), U4.42 (VCC33), U4.45 (VCC33), U4.63 (VCC33), U5.1 (VDD), U5.9 (VDDA), U5.24 (VDD), U5.48 (VDD), U6.8 (VCC); also elsewhere on the board
/Remote/485RW: U5.22 (PB11), U6.2 (~RE), U6.3 (DE)
/Remote/A: J7.1, R54.1, U6.6 (A)
/Remote/B: J7.3, R53.2, U6.7 (B)
/Remote/RST: C32.1, J2.1, U5.7 (NRST)
/Remote/RXD: U5.13 (PA3), U6.1 (RO)
/Remote/RXN: J5.6 (RXN), R44.1, U4.5 (RXN)
/Remote/RXP: J5.3 (RXP), R45.1, U4.4 (RXP)
/Remote/SPI_CS: U4.59 (SCS), U5.14 (PA4)
/Remote/SPI_MISO: U4.62 (SDO), U5.16 (PA6)
/Remote/SPI_MOSI: U4.61 (SDI), U5.17 (PA7)
/Remote/SPI_SCK: U4.60 (SCK), U5.15 (PA5)
/Remote/SWCLK: J6.3, U5.37 (PA14)
/Remote/SWDIO: J6.2, U5.34 (PA13)
/Remote/TXD: U5.12 (PA2), U6.4 (DI)
/Remote/TXN: J5.2 (TXN), R48.1, U4.8 (TXN)
/Remote/TXP: J5.1 (TXP), R49.1, U4.7 (TXP)
/Remote/X+: C34.1, U4.10 (XI), Y1.1
/Remote/X-: C35.1, U4.11 (XO), Y1.3
BCD1_0: U5.40 (PB4); also elsewhere on the board
BCD1_1: U5.39 (PB3); also elsewhere on the board
BCD1_2: U5.38 (PA15); also elsewhere on the board
BCD2_0: U5.33 (PA12); also elsewhere on the board
BCD2_1: U5.32 (PA11); also elsewhere on the board
BCD2_2: U5.31 (PA10); also elsewhere on the board
BCDM1_0: U5.30 (PA9); also elsewhere on the board
BCDM1_1: U5.29 (PA8); also elsewhere on the board
BCDM1_2: U5.28 (PB15); also elsewhere on the board
BCDM2_0: U5.27 (PB14); also elsewhere on the board
BCDM2_1: U5.26 (PB13); also elsewhere on the board
BCDM2_2: U5.25 (PB12); also elsewhere on the board
unnamed: C33.1, U4.36 (RSTI)
unnamed: J5.9 (LED_GA), R46.1
unnamed: J5.10 (LED_GK), J5.11 (LED_YK), U4.52 (ELINK#)
unnamed: J5.12 (LED_YA), R47.1
unnamed: R50.2, U5.44 (BOOT0)
unnamed: R51.2, U4.1 (RSETE)
unnamed: R52.1, U4.49 (INT#)
unnamed: R52.2, U5.11 (PA1)
chasis: C9.2, C10.2, C11.2, C12.2, C13.1, C14.2, C15.2, C16.2, C17.2, C18.2, C19.2, C20.2, C21.2, C22.2, C23.2, C24.2, C25.2, C26.2, C28.2, C29.2, C30.2, C31.2, C32.2, C33.2, C34.2, C35.2, C36.1, J5.8 (GND), J6.4, J7.2, R50.1, R51.1, R53.1, U3.1 (GND), U4.3 (GND), U4.9 (GND), U4.13 (GND), U4.18 (GND), U4.20 (GND), U4.37 (GND), U4.41 (GND), U4.44 (GND), U4.48 (GND), U4.58 (TXD), U5.8 (VSSA), U5.23 (VSS), U5.47 (VSS), U6.5 (GND), Y1.2, Y1.4; also elsewhere on the board

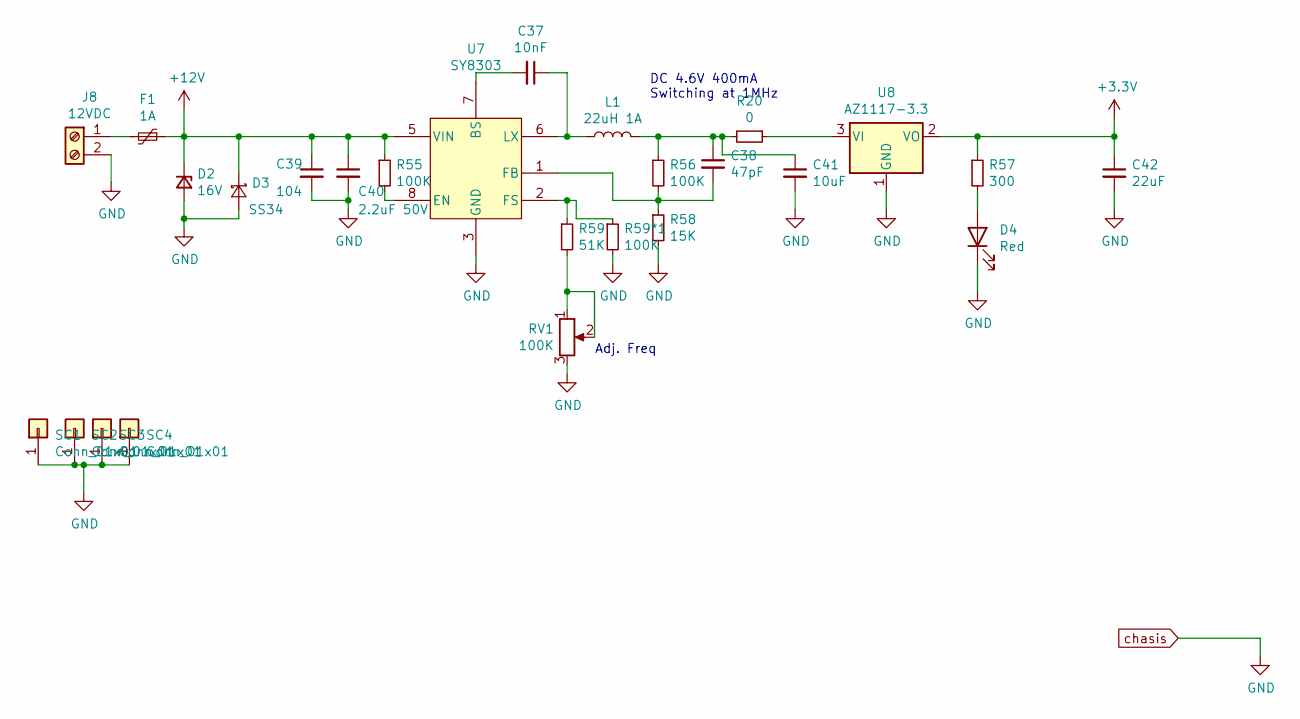
[picture p38: schematic Power.sch, 6x2 Antenna Switch Control/Interlock Board - Power]

Parts:
C37: 10nF; 0603_C
C38: 47pF; 0603_C
C39: 104; 0603_C
C40: 2.2uF 50V; 0805_C
C41: 10uF; 0805_C
C42: 22uF; 0805_C
D2: 16V; LL-34
D3: SS34; SMA(DO-214AC)_S3
D4: Red; LED_D3.0mm
F1: 1A; R_1812_HandSoldering
J8: 12VDC; PhoenixContact_MSTBA-G_02x5.08mm_Angled
L1: 22uH 1A; L_SMD4030_hand
R20: 0; 1206_R
R55, R56, R59*1: 100K; 0603_R
R57: 300; 0603_R
R58: 15K; 0603_R
R59: 51K; 0603_R
RV1: 100K; 3362P
SC1, SC2, SC3, SC4: Conn_01x01; M3_Screwhole
U7: SY8303; TSOT-23-8_HandSoldering
U8: AZ1117-3.3; SOT-223

Connections:
+3V3: C42.1, R57.1, U8.2 (VO); also elsewhere on the board
+12V: C39.1, C40.1, D2.1 (K), D3.2 (K), F1.1, R55.1, U7.5 (VIN); also elsewhere on the board
unnamed: C37.1, L1.1, U7.6 (LX)
unnamed: C37.2, U7.7 (BS)
unnamed: C38.1, C41.1, L1.2, R20.2, R56.1
unnamed: C38.2, R56.2, R58.1, U7.1 (FB)
unnamed: D4.2 (A), R57.2
unnamed: F1.2, J8.1
unnamed: R20.1, U8.3 (VI)
unnamed: R55.2, U7.8 (EN)
unnamed: R59.1, R59*1.1, U7.2 (FS)
unnamed: R59.2, RV1.1, RV1.2
chasis: C39.2, C40.2, C41.2, C42.2, D2.2 (A), D3.1 (A), D4.1 (K), J8.2, R58.2, R59*1.2, RV1.3, SC1.1, SC2.1, SC3.1, SC4.1, U7.3 (GND), U7.4 (GND), U8.1 (GND); also elsewhere on the board

Notes on the sheet:
DC 4.6V 400mA Switching at 1MHz
Adj. Freq

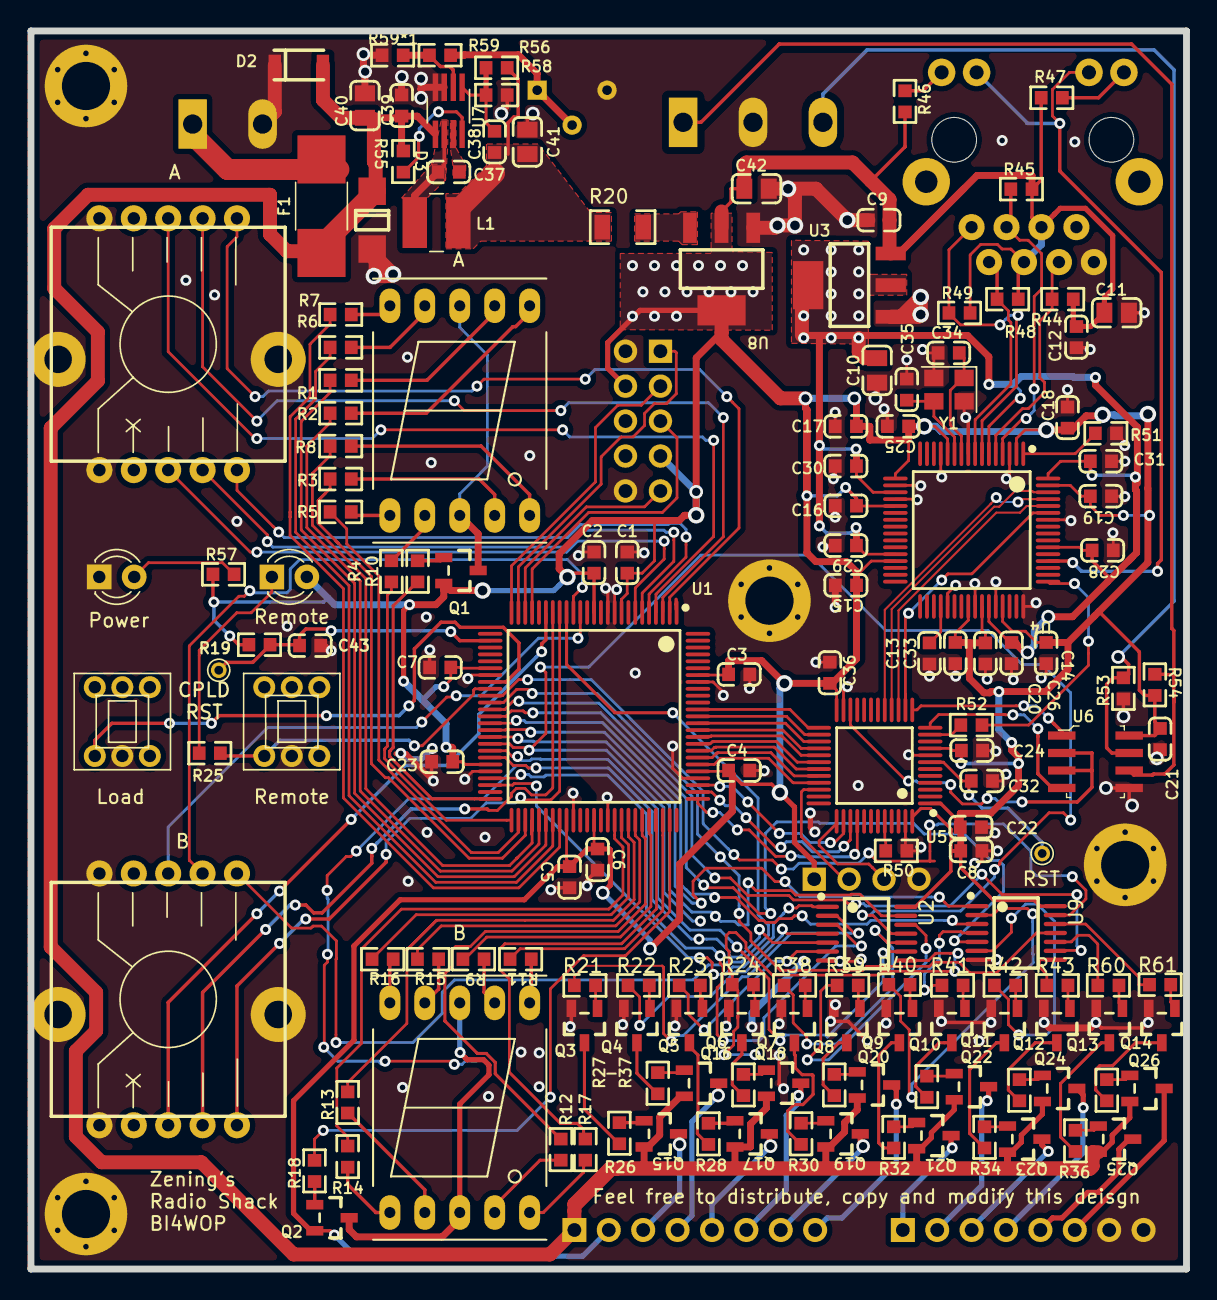
[picture p39: board PCB/history_versions/ControlBoard-2/AntennaSwitch_6x2.kicad_pcb from above]

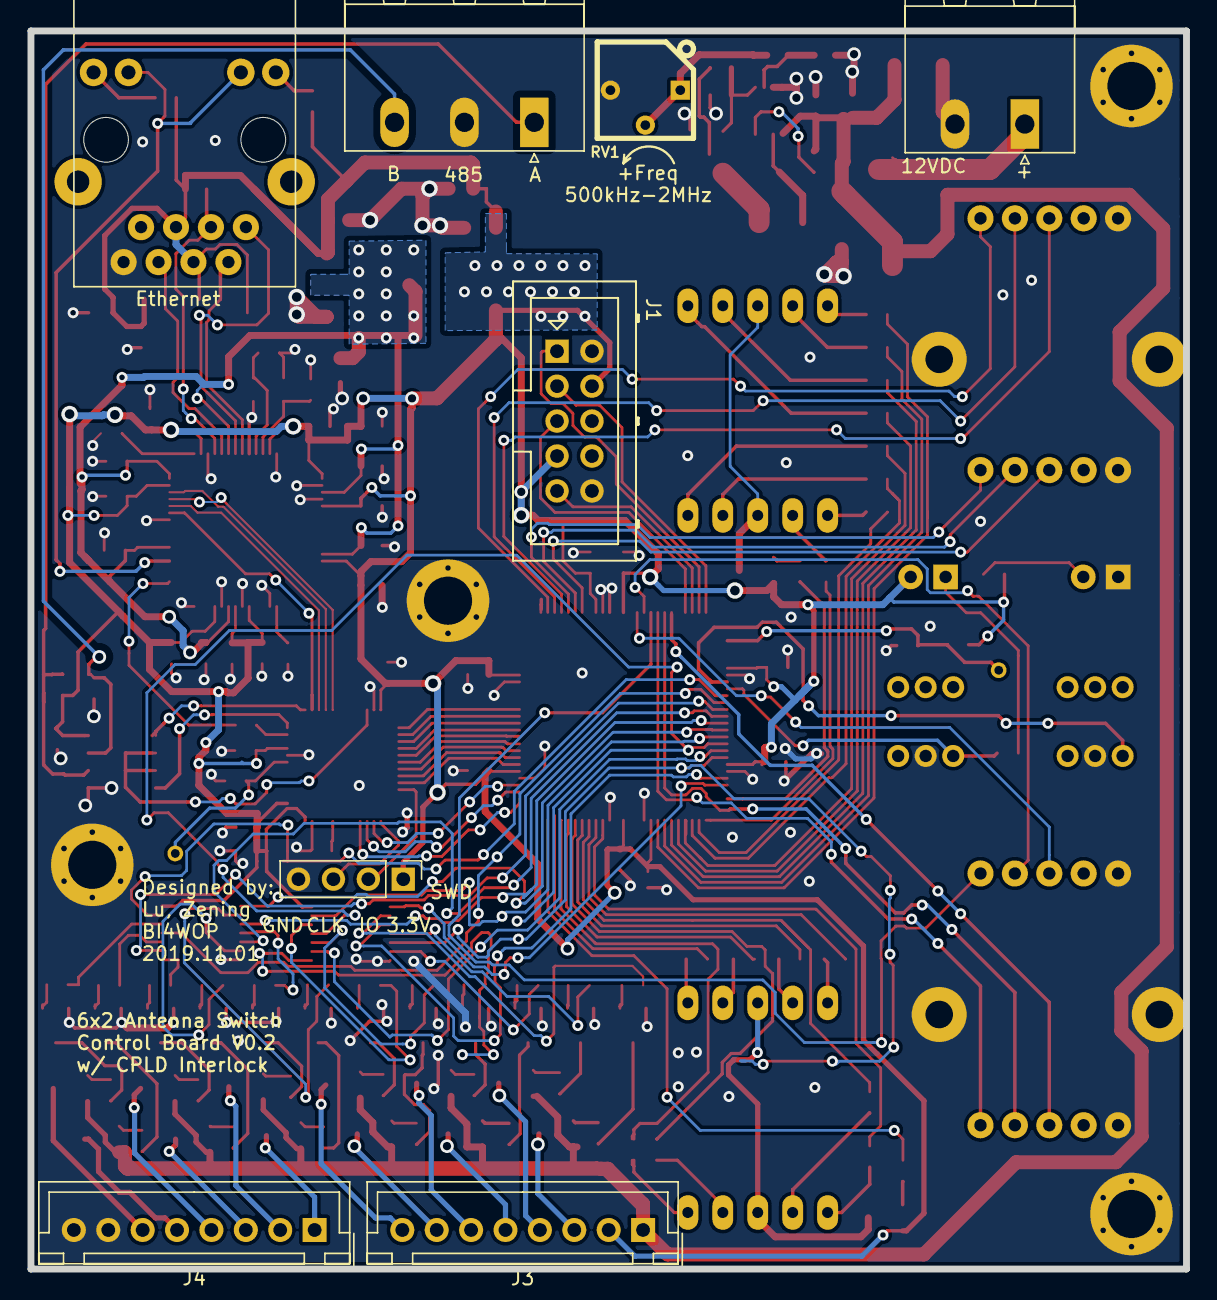
[picture p40: board PCB/history_versions/ControlBoard-2/AntennaSwitch_6x2.kicad_pcb from below]

Board: 2 copper layers, 84.0 x 90.0 mm, 166 parts (8 on the bottom side), 182 nets.
