LuZening/6x2-Antenna-Switch/PCB/history_versions/RelayBoard-2/AntennaSwitch_6x2_RelayBoard/AntennaSwitch_6x2_RelayBoard.kicad_pcb

## KiCad design PCB/history_versions/RelayBoard-2/AntennaSwitch_6x2_RelayBoard/AntennaSwitch_6x2_RelayBoard.kicad_pcb (2024-03-04)

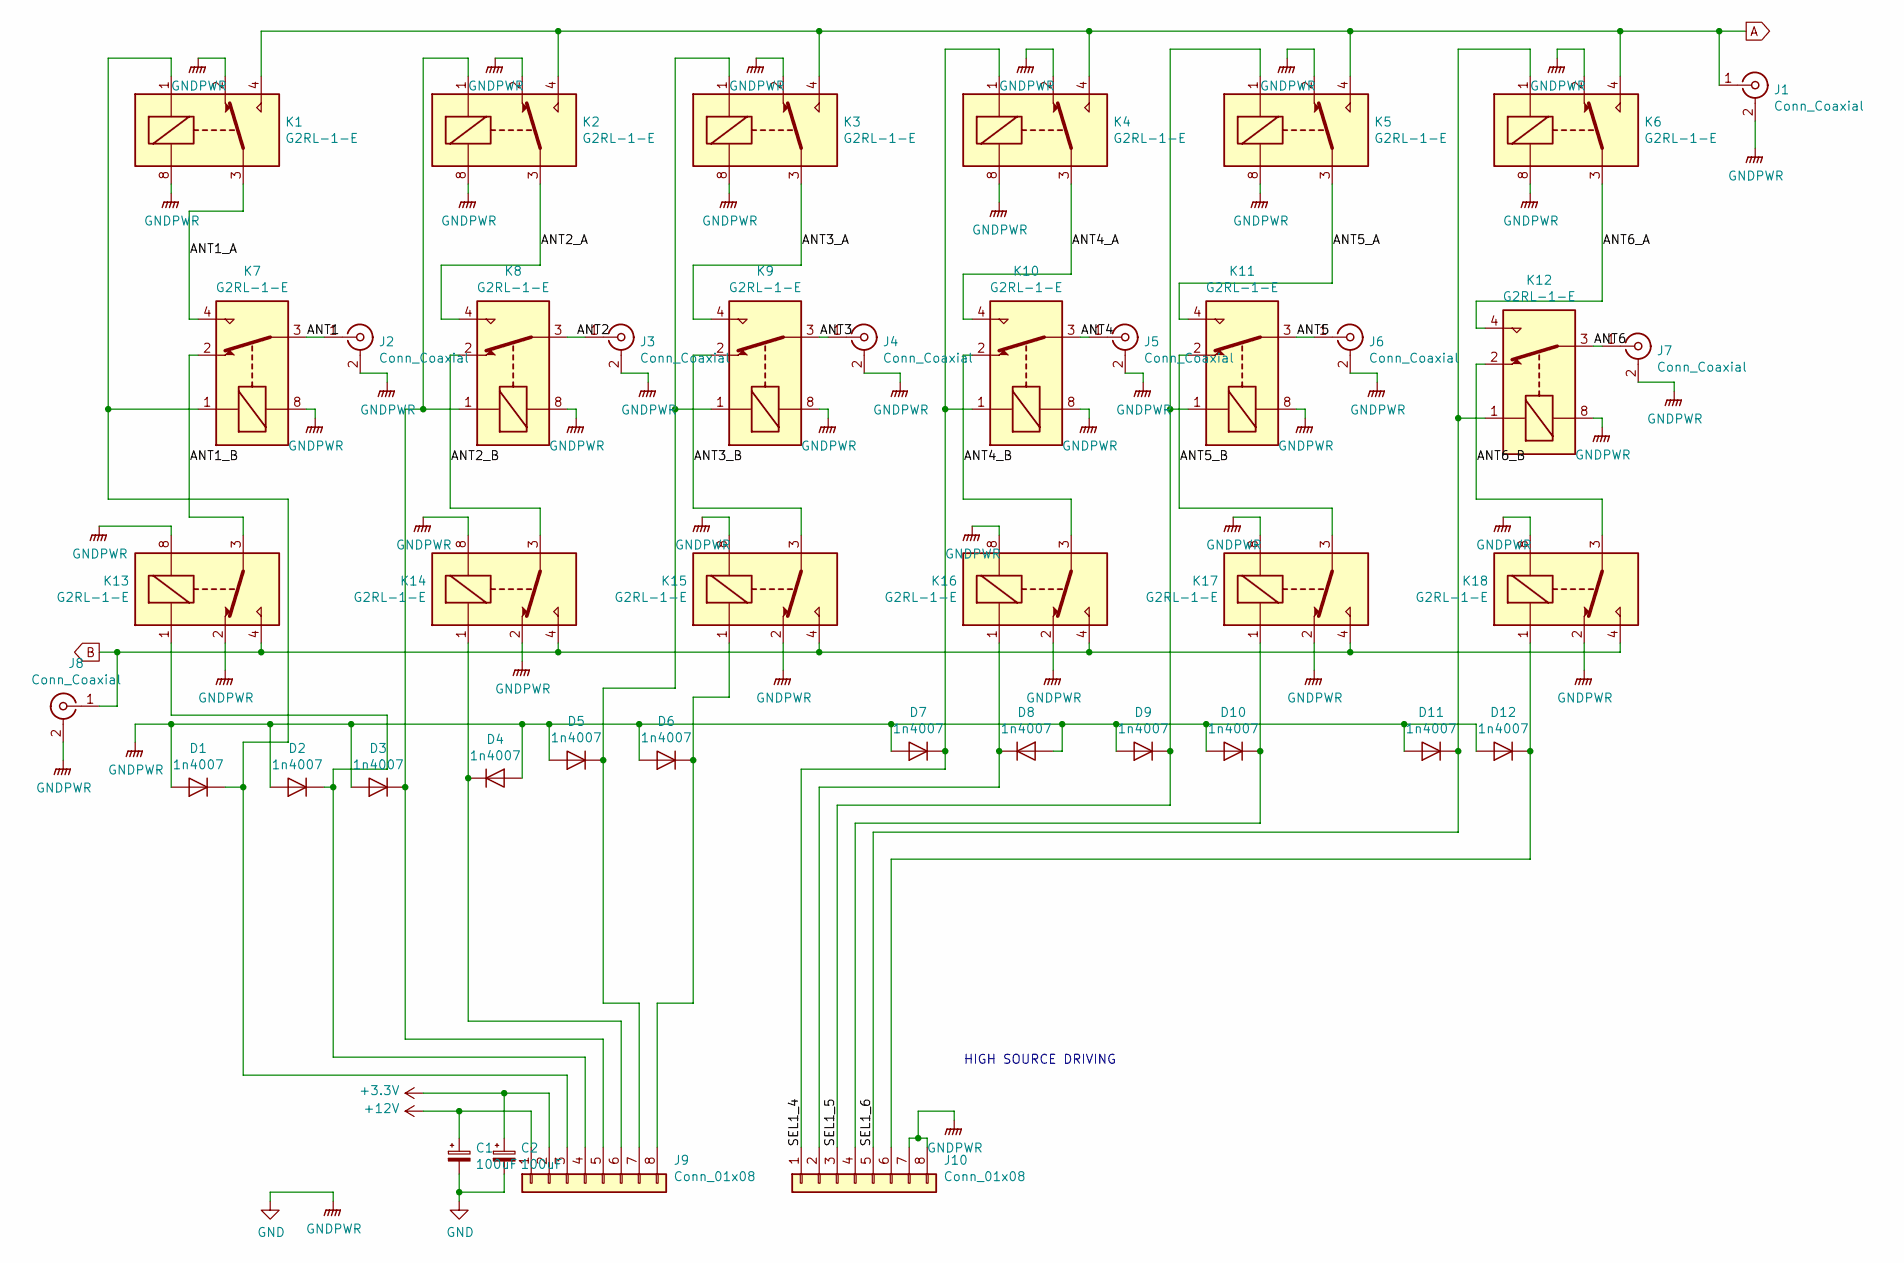
[picture p41: schematic AntennaSwitch_6x2_RelayBoard.sch]

Parts:
C1, C2: 100uF; 0805_C
D1, D2, D3, D4, D5, D6, D7, D8, D9, D10, D11, D12: 1n4007; SOD-123
J1, J2, J3, J4, J5, J6, J7, J8: Conn_Coaxial; SL16_Screw_PCB
J9, J10: Conn_01x08; Molex_KK-6410-08_08x2.54mm_Straight
K1, K2, K3, K4, K5, K6, K7, K8, K9, K10, K11, K12, K13, K14, K15, K16, K17, K18: G2RL-1-E

Connections:
+3V3: C2.1, J9.2
+12V: C1.1, J9.1
/ANT1: J2.1 (In), K7.3, K7.6
/ANT1_A: K1.3, K1.6, K7.4, K7.5
/ANT1_B: K7.2, K7.7, K13.3, K13.6
/ANT2: J3.1 (In), K8.3, K8.6
/ANT2_A: K2.3, K2.6, K8.4, K8.5
/ANT2_B: K8.2, K8.7, K14.3, K14.6
/ANT3: J4.1 (In), K9.3, K9.6
/ANT3_A: K3.3, K3.6, K9.4, K9.5
/ANT3_B: K9.2, K9.7, K15.3, K15.6
/ANT4: J5.1 (In), K10.3, K10.6
/ANT4_A: K4.3, K4.6, K10.4, K10.5
/ANT4_B: K10.2, K10.7, K16.3, K16.6
/ANT5: J6.1 (In), K11.3, K11.6
/ANT5_A: K5.3, K5.6, K11.4, K11.5
/ANT5_B: K11.2, K11.7, K17.3, K17.6
/ANT6: J7.1 (In), K12.3, K12.6
/ANT6_A: K6.3, K6.6, K12.4, K12.5
/ANT6_B: K12.2, K12.7, K18.3, K18.6
/SEL1_4: D7.2 (K), J10.1, K4.1, K10.1
/SEL1_5: D9.2 (K), J10.3, K5.1, K11.1
/SEL1_6: D11.2 (K), J10.5, K6.1, K12.1
A: J1.1 (In), K1.4, K1.5, K2.4, K2.5, K3.4, K3.5, K4.4, K4.5, K5.4, K5.5, K6.4, K6.5
B: J8.1 (In), K13.4, K13.5, K14.4, K14.5, K15.4, K15.5, K16.4, K16.5, K17.4, K17.5, K18.4, K18.5
GND: C1.2, C2.2, D1.1 (A), D2.1 (A), D3.1 (A), D4.1 (A), D5.1 (A), D6.1 (A), D7.1 (A), D8.1 (A), D9.1 (A), D10.1 (A), D11.1 (A), D12.1 (A), J1.2 (Ext), J2.2 (Ext), J3.2 (Ext), J4.2 (Ext), J5.2 (Ext), J6.2 (Ext), J7.2 (Ext), J8.2 (Ext), J10.7, J10.8, K1.2, K1.7, K1.8, K2.2, K2.7, K2.8, K3.2, K3.7, K3.8, K4.2, K4.7, K4.8, K5.2, K5.7, K5.8, K6.2, K6.7, K6.8, K7.8, K8.8, K9.8, K10.8, K11.8, K12.8, K13.2, K13.7, K13.8, K14.2, K14.7, K14.8, K15.2, K15.7, K15.8, K16.2, K16.7, K16.8, K17.2, K17.7, K17.8, K18.2, K18.7, K18.8
unnamed: D1.2 (K), J9.3, K1.1, K7.1
unnamed: D2.2 (K), J9.4, K13.1
unnamed: D3.2 (K), J9.5, K2.1, K8.1
unnamed: D4.2 (K), J9.6, K14.1
unnamed: D5.2 (K), J9.7, K3.1, K9.1
unnamed: D6.2 (K), J9.8, K15.1
unnamed: D8.2 (K), J10.2, K16.1
unnamed: D10.2 (K), J10.4, K17.1
unnamed: D12.2 (K), J10.6, K18.1

Notes on the sheet:
HIGH SOURCE DRIVING

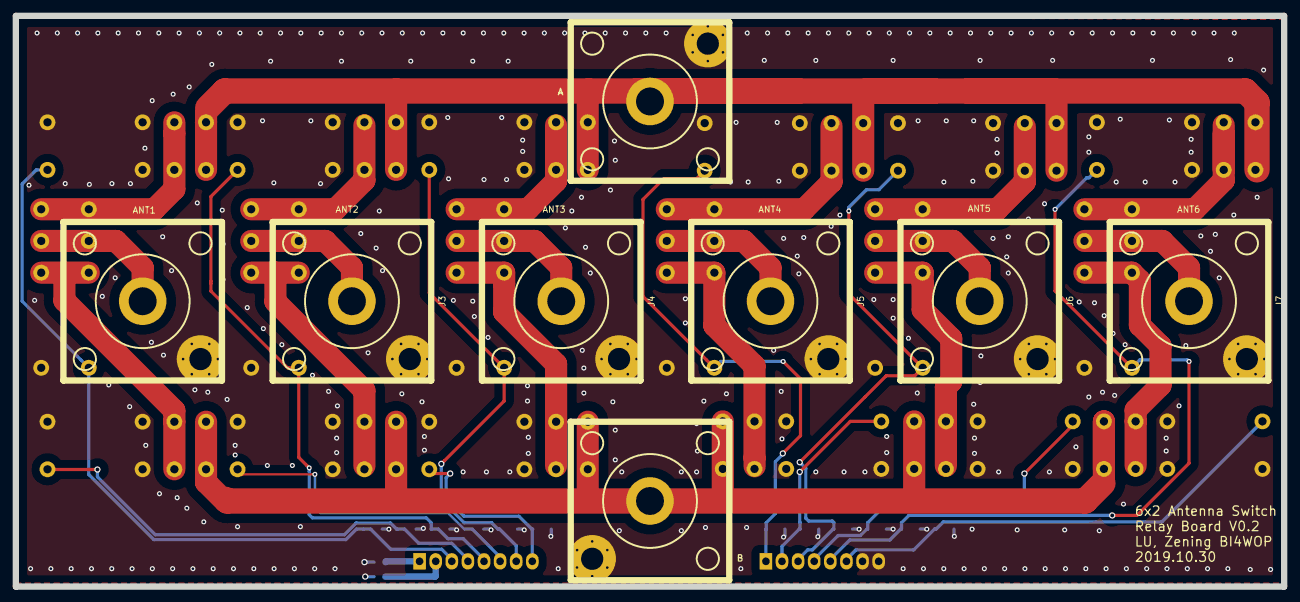
[picture p42: board AntennaSwitch_6x2_RelayBoard.kicad_pcb from above]

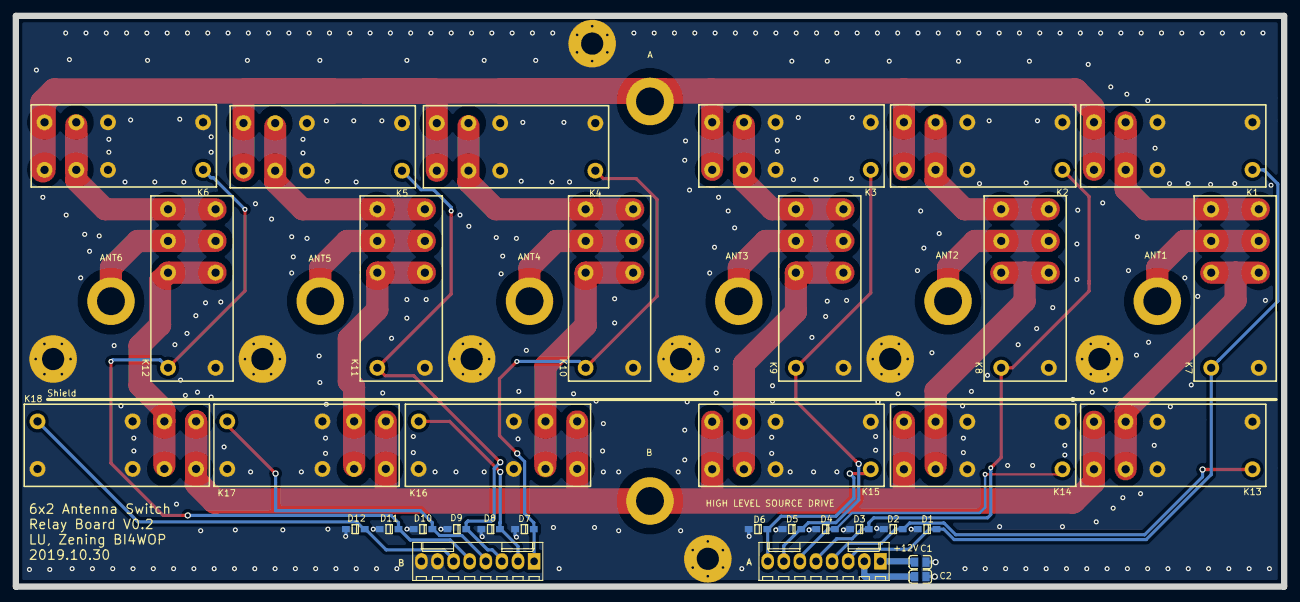
[picture p43: board AntennaSwitch_6x2_RelayBoard.kicad_pcb from below]

Board: 2 copper layers, 200.0 x 90.0 mm, 42 parts (34 on the bottom side), 35 nets.
