LuZening/6x2-Antenna-Switch/PCB/history_versions/AntennaSwitch_6x2/AntennaSwitch_6x2.kicad_pcb

## KiCad design PCB/history_versions/AntennaSwitch_6x2/AntennaSwitch_6x2.kicad_pcb (2019-09-17)

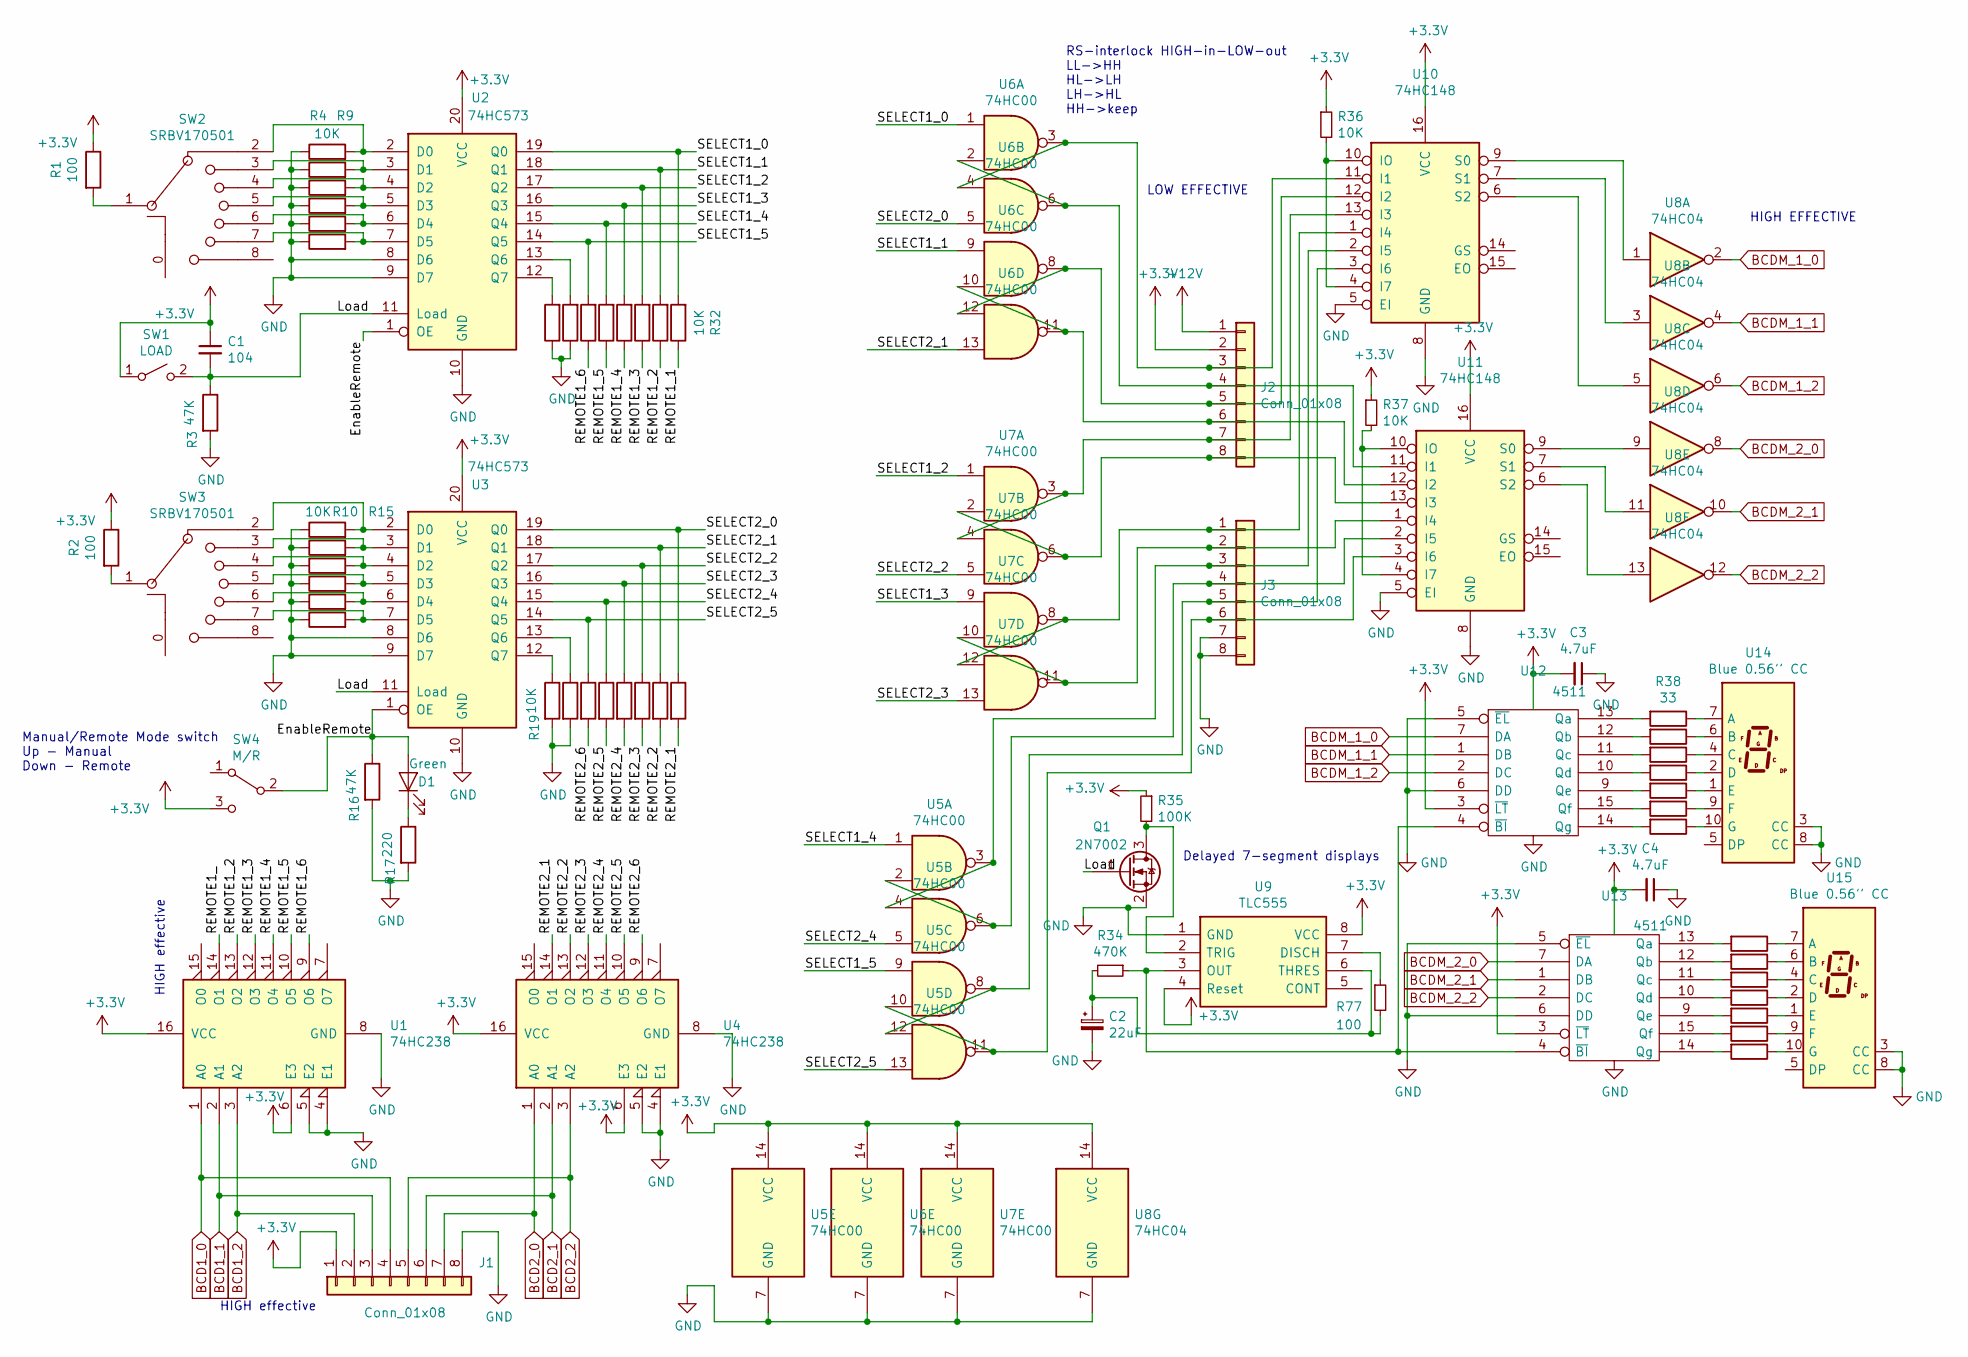
[picture p44: schematic Interlock.sch, 6x2 Antenna Switch Control/Interlock Board - Interlock]

Parts:
C1: 104; C_0603
C2: 22uF; 0805
C3, C4: 4.7uF; C_0805
D1: Green; LED_D3.0mm
J1, J2, J3: Conn_01x08; Molex_KK-6410-08_08x2.54mm_Straight
Q1: 2N7002; SOT-23(SOT-23-3)
R1, R2, R77: 100; 0603
R3, R16: 47K; 0603
R4, R5, R6, R7, R8, R9, R10, R11, R12, R13, R14, R15, R18, R19, R20, R21, R22, R23, R24, R25, R26, R27, R28, R29, R30, R31, R32, R33, R36, R37: 10K; 0603
R17: 220; 0603
R34: 470K; 0603
R35: 100K; 0603
R38, R39, R40, R41, R42, R43, R44, R45, R46, R47, R48, R49, R50, R51: 33; 0603
SW1: LOAD; K8-7071
SW2, SW3: SRBV170501
SW4: M/R; K8-7071
U1, U4: 74HC238; SOIC-16_W3.90mm
U2, U3: 74HC573; SOIC-20_W7.5mm
U5, U6, U7: 74HC00; SOIC-14_W3.9mm
U8: 74HC04; SOIC-14_W3.9mm
U9: TLC555; SOIC-8_W3.9mm; Manufacturer_Part_Number NE555D
U10, U11: 74HC148; SOIC-16_W3.90mm
U12, U13: 4511; SOIC-16_W3.90mm
U14, U15: Blue 0.56'' CC; 7SegmentLED_LTS6760_LTS6780

Connections:
+3V3: C1.1, C3.2, C4.2, J1.1, J2.2, R1.1, R2.1, R35.1, R36.1, R37.1, SW1.1 (A), SW4.3 (C), U1.6 (E3), U1.16 (VCC), U2.20 (VCC), U3.20 (VCC), U4.6 (E3), U4.16 (VCC), U5.14 (VCC), U6.14 (VCC), U7.14 (VCC), U8.14 (VCC), U9.4 (Reset), U9.8 (VCC), U10.16 (VCC), U11.16 (VCC), U12.3 (~LT), U12.16 (Vdd), U13.3 (~LT), U13.16 (Vdd); also elsewhere on the board
+12V: J2.1; also elsewhere on the board
/Interlock/EnableRemote: D1.2 (A), R16.1, SW4.2 (B), U2.1 (OE), U3.1 (OE)
/Interlock/Load: C1.2, Q1.1 (G), R3.1, SW1.2 (B), U2.11 (Load), U3.11 (Load)
/Interlock/REMOTE1_1: R30.1, U1.13 (O2)
/Interlock/REMOTE1_2: R28.1, U1.12 (O3)
/Interlock/REMOTE1_3: R26.1, U1.11 (O4)
/Interlock/REMOTE1_4: R24.1, U1.10 (O5)
/Interlock/REMOTE1_5: R22.1, U1.9 (O6)
/Interlock/REMOTE2_0: R33.2, U4.14 (O1)
/Interlock/REMOTE2_1: R31.2, U4.13 (O2)
/Interlock/REMOTE2_2: R29.2, U4.12 (O3)
/Interlock/REMOTE2_3: R27.2, U4.11 (O4)
/Interlock/REMOTE2_4: R25.2, U4.10 (O5)
/Interlock/REMOTE2_5: R23.2, U4.9 (O6)
/Interlock/SELECT1_0: R32.2, U2.19 (Q0), U6.1
/Interlock/SELECT1_1: R30.2, U2.18 (Q1), U6.9
/Interlock/SELECT1_2: R28.2, U2.17 (Q2), U7.1
/Interlock/SELECT1_3: R26.2, U2.16 (Q3), U7.9
/Interlock/SELECT1_4: R24.2, U2.15 (Q4), U5.1
/Interlock/SELECT1_5: R22.2, U2.14 (Q5), U5.9
/Interlock/SELECT2_0: R33.1, U3.19 (Q0), U6.5
/Interlock/SELECT2_1: R31.1, U3.18 (Q1), U6.13
/Interlock/SELECT2_2: R29.1, U3.17 (Q2), U7.5
/Interlock/SELECT2_3: R27.1, U3.16 (Q3), U7.13
/Interlock/SELECT2_4: R25.1, U3.15 (Q4), U5.5
/Interlock/SELECT2_5: R23.1, U3.14 (Q5), U5.13
BCD1_0: J1.4, U1.1 (A0); also elsewhere on the board
BCD1_1: J1.3, U1.2 (A1); also elsewhere on the board
BCD1_2: J1.2, U1.3 (A2); also elsewhere on the board
BCD2_0: J1.7, U4.1 (A0); also elsewhere on the board
BCD2_1: J1.6, U4.2 (A1); also elsewhere on the board
BCD2_2: J1.5, U4.3 (A2); also elsewhere on the board
BCDM_1_0: U8.2, U12.7 (DA); also elsewhere on the board
BCDM_1_1: U8.4, U12.1 (DB); also elsewhere on the board
BCDM_1_2: U8.6, U12.2 (DC); also elsewhere on the board
BCDM_2_0: U8.8, U13.7 (DA); also elsewhere on the board
BCDM_2_1: U8.10, U13.1 (DB); also elsewhere on the board
BCDM_2_2: U8.12, U13.2 (DC); also elsewhere on the board
unnamed: C2.1, R34.2, R77.2, U9.6 (THRES)
unnamed: D1.1 (K), R17.1
unnamed: J2.3, U6.3, U6.4, U10.11 (I1)
unnamed: J2.4, U6.2, U6.6, U11.11 (I1)
unnamed: J2.5, U6.8, U6.12, U10.12 (I2)
unnamed: J2.6, U6.10, U6.11, U11.12 (I2)
unnamed: J2.7, U7.3, U7.4, U10.13 (I3)
unnamed: J2.8, U7.2, U7.6, U11.13 (I3)
unnamed: J3.1, U7.8, U7.12, U10.1 (I4)
unnamed: J3.2, U7.10, U7.11, U11.1 (I4)
unnamed: J3.3, U5.3, U5.4, U10.2 (I5)
unnamed: J3.4, U5.2, U5.6, U11.2 (I5)
unnamed: J3.5, U5.8, U5.12, U10.3 (I6)
unnamed: J3.6, U5.10, U5.11, U11.3 (I6)
unnamed: Q1.3 (D), R35.2, U9.2 (TRIG)
unnamed: R1.2, SW2.1, SW2.10
unnamed: R2.2, SW3.1, SW3.10
unnamed: R4.2, SW2.2, U2.2 (D0)
unnamed: R5.2, SW2.3, U2.3 (D1)
unnamed: R6.2, SW2.4, U2.4 (D2)
unnamed: R7.2, SW2.5, U2.5 (D3)
unnamed: R8.2, SW2.6, U2.6 (D4)
unnamed: R9.2, SW2.7, U2.7 (D5)
unnamed: R10.2, SW3.2, U3.2 (D0)
unnamed: R11.2, SW3.3, U3.3 (D1)
unnamed: R12.2, SW3.4, U3.4 (D2)
unnamed: R13.2, SW3.5, U3.5 (D3)
unnamed: R14.2, SW3.6, U3.6 (D4)
unnamed: R15.2, SW3.7, U3.7 (D5)
unnamed: R18.2, U2.12 (Q7)
unnamed: R19.1, U3.12 (Q7)
unnamed: R20.2, U2.13 (Q6)
unnamed: R21.1, U3.13 (Q6)
unnamed: R34.1, U9.3 (OUT), U12.4 (~BI), U13.4 (~BI)
unnamed: R36.2, U10.4 (I7), U10.10 (IO)
unnamed: R37.2, U11.4 (I7), U11.10 (IO)
unnamed: R38.1, U14.7 (A)
unnamed: R38.2, U12.13 (Qa)
unnamed: R39.1, U14.6 (B)
unnamed: R39.2, U12.12 (Qb)
unnamed: R40.1, U14.4 (C)
unnamed: R40.2, U12.11 (Qc)
unnamed: R41.1, U14.2 (D)
unnamed: R41.2, U12.10 (Qd)
unnamed: R42.1, U14.1 (E)
unnamed: R42.2, U12.9 (Qe)
unnamed: R43.1, U14.9 (F)
unnamed: R43.2, U12.15 (Qf)
unnamed: R44.1, U14.10 (G)
unnamed: R44.2, U12.14 (Qg)
unnamed: R45.1, U15.7 (A)
unnamed: R45.2, U13.13 (Qa)
unnamed: R46.1, U15.6 (B)
unnamed: R46.2, U13.12 (Qb)
unnamed: R47.1, U15.4 (C)
unnamed: R47.2, U13.11 (Qc)
unnamed: R48.1, U15.2 (D)
unnamed: R48.2, U13.10 (Qd)
unnamed: R49.1, U15.1 (E)
unnamed: R49.2, U13.9 (Qe)
unnamed: R50.1, U15.9 (F)
unnamed: R50.2, U13.15 (Qf)
unnamed: R51.1, U15.10 (G)
unnamed: R51.2, U13.14 (Qg)
unnamed: R77.1, U9.7 (DISCH)
unnamed: U8.5, U10.6 (S2)
unnamed: U8.3, U10.7 (S1)
unnamed: U8.1, U10.9 (S0)
unnamed: U8.13, U11.6 (S2)
unnamed: U8.11, U11.7 (S1)
unnamed: U8.9, U11.9 (S0)
chasis: C2.2, C3.1, C4.1, J1.8, J3.7, J3.8, Q1.2 (S), R3.2, R4.1, R5.1, R6.1, R7.1, R8.1, R9.1, R10.1, R11.1, R12.1, R13.1, R14.1, R15.1, R16.2, R17.2, R18.1, R19.2, R20.1, R21.2, U1.4 (E1), U1.5 (E2), U1.8 (GND), U2.8 (D6), U2.9 (D7), U2.10 (GND), U3.8 (D6), U3.9 (D7), U3.10 (GND), U4.4 (E1), U4.5 (E2), U4.8 (GND), U5.7 (GND), U6.7 (GND), U7.7 (GND), U8.7 (GND), U9.1 (GND), U10.5 (EI), U10.8 (GND), U11.5 (EI), U11.8 (GND), U12.5 (~EL), U12.6 (DD), U12.8 (Vss), U13.5 (~EL), U13.6 (DD), U13.8 (Vss), U14.3 (CC), U14.8 (CC), U15.3 (CC), U15.8 (CC); also elsewhere on the board

Notes on the sheet:
HIGH effective
Manual/Remote Mode switch Up - Manual Down - Remote
HIGH EFFECTIVE
LOW EFFECTIVE
Delayed 7-segment displays
RS-interlock HIGH-in-LOW-out LL->HH HL->LH LH->HL HH->keep

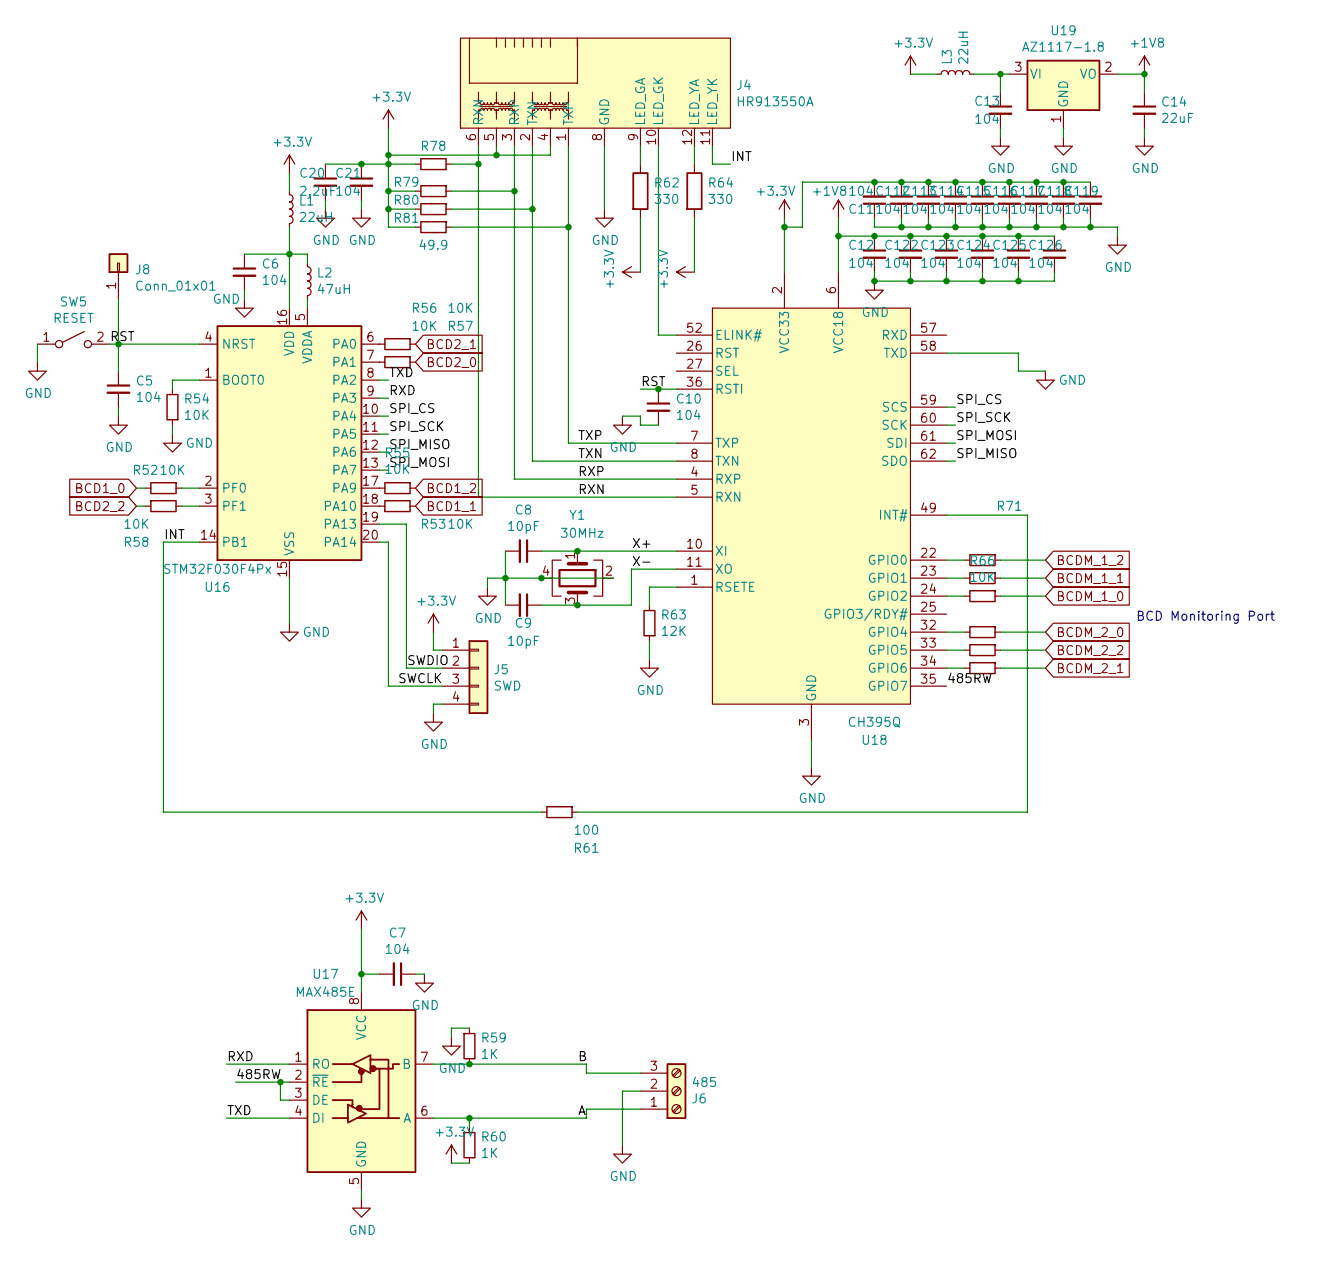
[picture p45: schematic Remote.sch, 6x2 Antenna Switch Control/Interlock Board - Remote Control]

Parts:
C5, C6, C7, C10, C11, C12, C13, C21, C112, C113, C114, C115, C116, C117, C118, C119, C122, C123, C124, C125, C126: 104; C_0603
C8, C9: 10pF; C_0603
C14: 22uF; C_0805
C20: 2.2uF; C_0805
J4: HR913550A
J5: SWD; XH2.54-4
J6: 485; PhoenixContact_MSTBA-G_03x5.08mm_Angled
J8: Conn_01x01; 1pin
L1, L3: 22uH; L_SMD4030_hand
L2: 47uH; 0805
R52, R53, R54, R55, R56, R57, R58, R66, R67, R68, R69, R70, R71: 10K; 0603
R59, R60: 1K; 0603
R61: 100; 0603
R62, R64: 330; 0603
R63: 12K; 0603
R78, R79, R80, R81: 49.9; 0805
SW5: RESET; SW_PUSH_6mm
U16: STM32F030F4Px; TSSOP-20
U17: MAX485E; SOIC-8_W3.9mm
U18: CH395Q; LQFP-64_10x10mm
U19: AZ1117-1.8; SOT-223-3_TabPin2
Y1: 30MHz; Crystal_SMD_3225-4pin_3.2x2.5mm

Connections:
+1V8: C12.1, C14.1, C122.1, C123.1, C124.1, C125.1, C126.1, U18.6 (VCC18), U18.19 (VCC18), U18.28 (VCC18), U18.43 (VCC18), U18.54 (VCC18), U18.64 (VCC18), U19.2 (VO)
+3V3: C7.2, C11.2, C20.1, C21.1, C112.1, C113.1, C114.1, C115.1, C116.1, C117.1, C118.1, C119.1, J4.4, J4.5, J5.1, L1.1, L3.1, R60.2, R62.2, R64.2, R78.2, R79.2, R80.2, R81.2, U17.8 (VCC), U18.2 (VCC33), U18.12 (VCC33), U18.17 (VCC33), U18.21 (VCC33), U18.29 (VCC33), U18.40 (VCC33), U18.42 (VCC33), U18.45 (VCC33), U18.63 (VCC33); also elsewhere on the board
/Remote/485RW: U17.2 (~RE), U17.3 (DE), U18.35 (GPIO7)
/Remote/A: J6.1, R60.1, U17.6 (A)
/Remote/B: J6.3, R59.2, U17.7 (B)
/Remote/INT: J4.11 (LED_YK), R61.2, U16.14 (PB1)
/Remote/RST: C5.1, C10.1, J8.1, SW5.2 (B), U16.4 (NRST), U18.36 (RSTI)
/Remote/RXD: U16.9 (PA3), U17.1 (RO)
/Remote/RXN: J4.6 (RXN), R78.1, U18.5 (RXN)
/Remote/RXP: J4.3 (RXP), R79.1, U18.4 (RXP)
/Remote/SPI_CS: U16.10 (PA4), U18.59 (SCS)
/Remote/SPI_MISO: U16.12 (PA6), U18.62 (SDO)
/Remote/SPI_MOSI: U16.13 (PA7), U18.61 (SDI)
/Remote/SPI_SCK: U16.11 (PA5), U18.60 (SCK)
/Remote/SWCLK: J5.3, U16.20 (PA14)
/Remote/SWDIO: J5.2, U16.19 (PA13)
/Remote/TXD: U16.8 (PA2), U17.4 (DI)
/Remote/TXN: J4.2 (TXN), R80.1, U18.8 (TXN)
/Remote/TXP: J4.1 (TXP), R81.1, U18.7 (TXP)
/Remote/X+: C8.1, U18.10 (XI), Y1.1
/Remote/X-: C9.1, U18.11 (XO), Y1.3
BCD1_0: R52.2; also elsewhere on the board
BCD1_1: R53.2; also elsewhere on the board
BCD1_2: R55.1; also elsewhere on the board
BCD2_0: R56.1; also elsewhere on the board
BCD2_1: R57.1; also elsewhere on the board
BCD2_2: R58.1; also elsewhere on the board
BCDM_1_0: R66.1; also elsewhere on the board
BCDM_1_1: R67.1; also elsewhere on the board
BCDM_1_2: R68.1; also elsewhere on the board
BCDM_2_0: R69.1; also elsewhere on the board
BCDM_2_1: R70.1; also elsewhere on the board
BCDM_2_2: R71.1; also elsewhere on the board
unnamed: C6.1, L1.2, L2.1, U16.16 (VDD)
unnamed: C13.1, L3.2, U19.3 (VI)
unnamed: J4.9 (LED_GA), R62.1
unnamed: J4.10 (LED_GK), U18.52 (ELINK#)
unnamed: J4.12 (LED_YA), R64.1
unnamed: L2.2, U16.5 (VDDA)
unnamed: R52.1, U16.2 (PF0)
unnamed: R53.1, U16.18 (PA10)
unnamed: R54.2, U16.1 (BOOT0)
unnamed: R55.2, U16.17 (PA9)
unnamed: R56.2, U16.7 (PA1)
unnamed: R57.2, U16.6 (PA0)
unnamed: R58.2, U16.3 (PF1)
unnamed: R61.1, U18.49 (INT#)
unnamed: R63.2, U18.1 (RSETE)
unnamed: R66.2, U18.24 (GPIO2)
unnamed: R67.2, U18.23 (GPIO1)
unnamed: R68.2, U18.22 (GPIO0)
unnamed: R69.2, U18.32 (GPIO4)
unnamed: R70.2, U18.34 (GPIO6)
unnamed: R71.2, U18.33 (GPIO5)
chasis: C5.2, C6.2, C7.1, C8.2, C9.2, C10.2, C11.1, C12.2, C13.2, C14.2, C20.2, C21.2, C112.2, C113.2, C114.2, C115.2, C116.2, C117.2, C118.2, C119.2, C122.2, C123.2, C124.2, C125.2, C126.2, J4.8 (GND), J5.4, J6.2, R54.1, R59.1, R63.1, SW5.1 (A), U16.15 (VSS), U17.5 (GND), U18.3 (GND), U18.9 (GND), U18.13 (GND), U18.18 (GND), U18.20 (GND), U18.37 (GND), U18.41 (GND), U18.44 (GND), U18.48 (GND), U18.58 (TXD), U19.1 (GND), Y1.2, Y1.4; also elsewhere on the board

Notes on the sheet:
BCD Monitoring Port

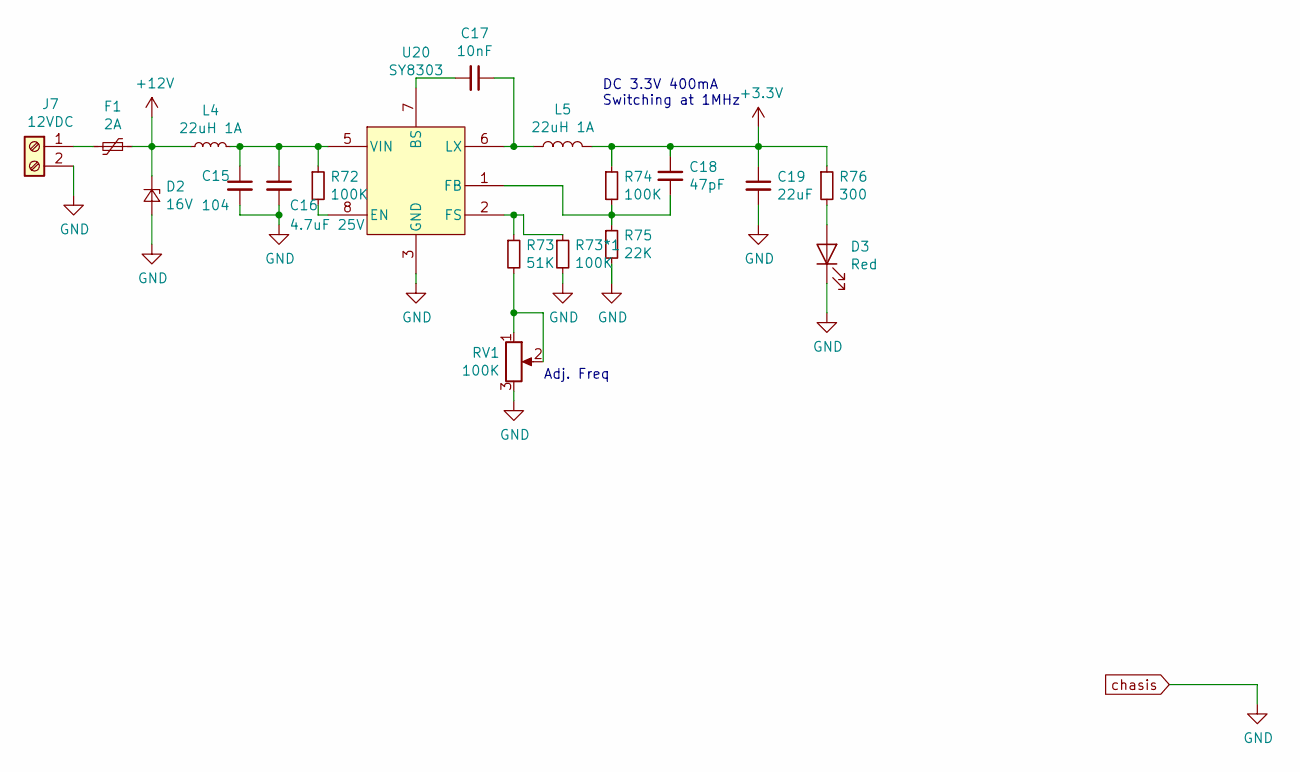
[picture p46: schematic Power.sch, 6x2 Antenna Switch Control/Interlock Board - Power]

Parts:
C15: 104; C_0603
C16: 4.7uF 25V; C_0805
C17: 10nF; C_0603
C18: 47pF; C_0603
C19: 22uF; C_0805
D2: 16V; D_SMA
D3: Red; LED_D3.0mm
F1: 2A; R_1812_HandSoldering
J7: 12VDC; PhoenixContact_MSTBA-G_02x5.08mm_Angled
L4, L5: 22uH 1A; L_SMD4030_hand
R72, R73*1, R74: 100K; 0603
R73: 51K; 0603
R75: 22K; 0603
R76: 300; 0603
RV1: 100K; 3362P
U20: SY8303; TSOT-23-8_HandSoldering

Connections:
+3V3: C18.1, C19.1, L5.2, R74.1, R76.1; also elsewhere on the board
+12V: D2.1 (K), F1.1, L4.1; also elsewhere on the board
unnamed: C15.1, C16.1, L4.2, R72.1, U20.5 (VIN)
unnamed: C17.1, L5.1, U20.6 (LX)
unnamed: C17.2, U20.7 (BS)
unnamed: C18.2, R74.2, R75.1, U20.1 (FB)
unnamed: D3.2 (A), R76.2
unnamed: F1.2, J7.1
unnamed: R72.2, U20.8 (EN)
unnamed: R73.1, R73*1.1, U20.2 (FS)
unnamed: R73.2, RV1.1, RV1.2
chasis: C15.2, C16.2, C19.2, D2.2 (A), D3.1 (K), J7.2, R73*1.2, R75.2, RV1.3, U20.3 (GND), U20.4 (GND); also elsewhere on the board

Notes on the sheet:
DC 3.3V 400mA Switching at 1MHz
Adj. Freq

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
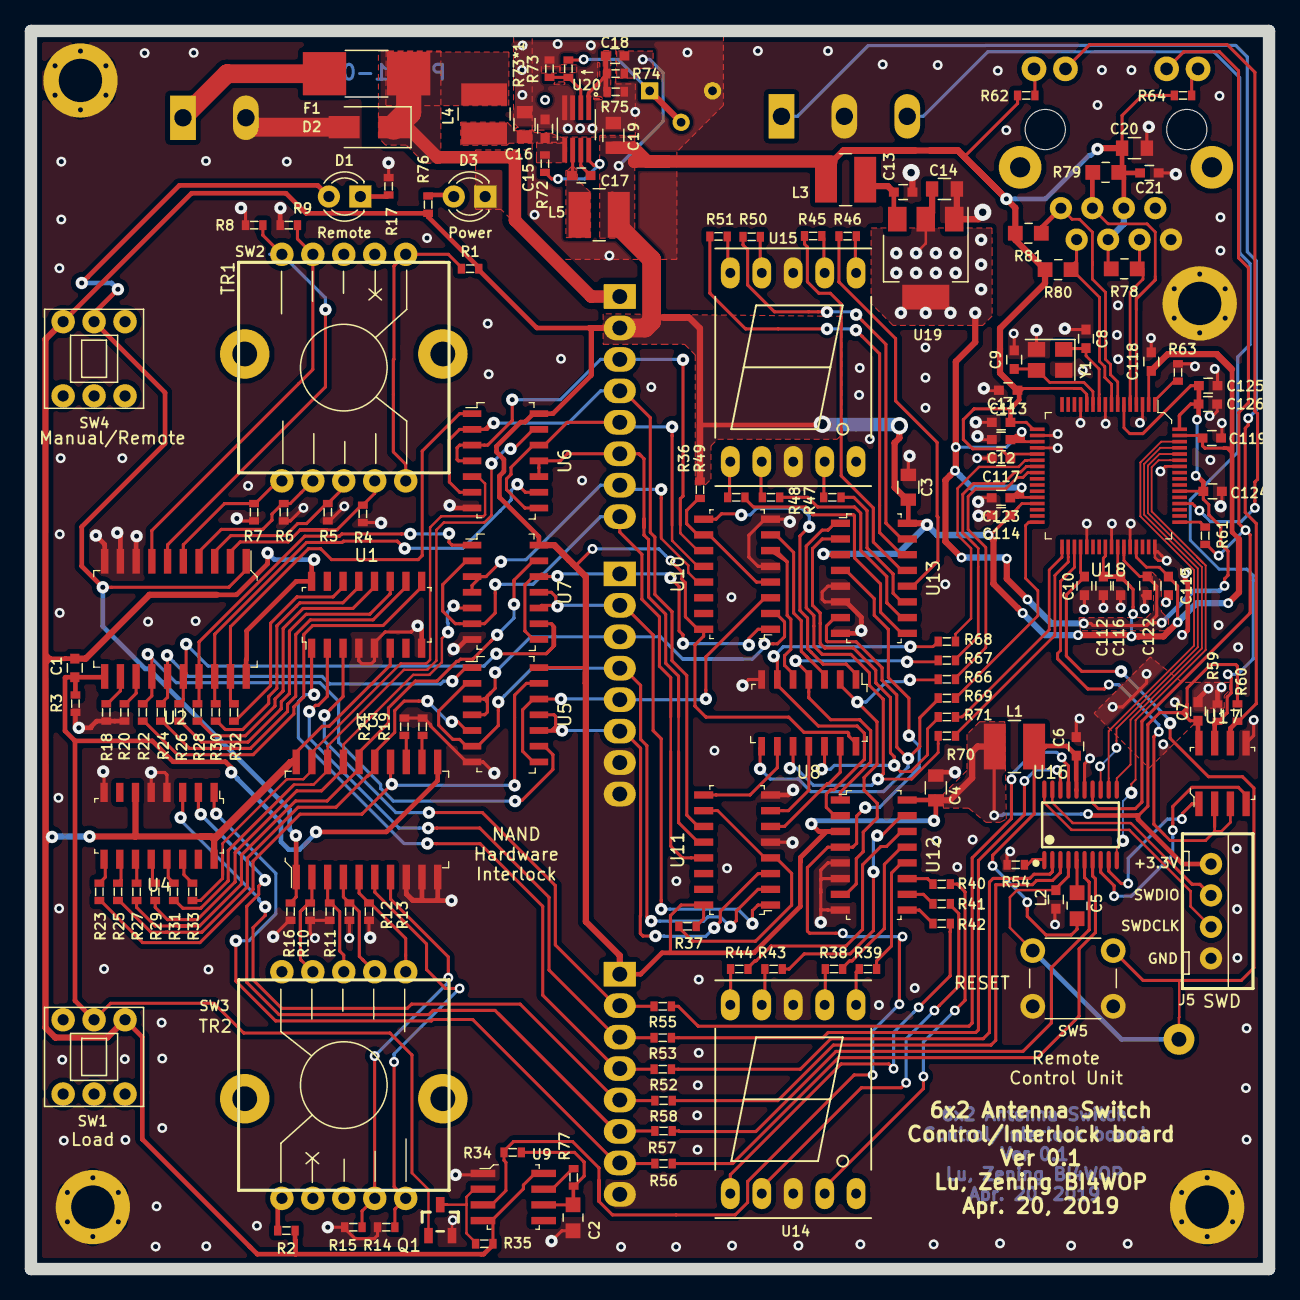
[picture p47: board PCB/history_versions/AntennaSwitch_6x2/AntennaSwitch_6x2.kicad_pcb from above]

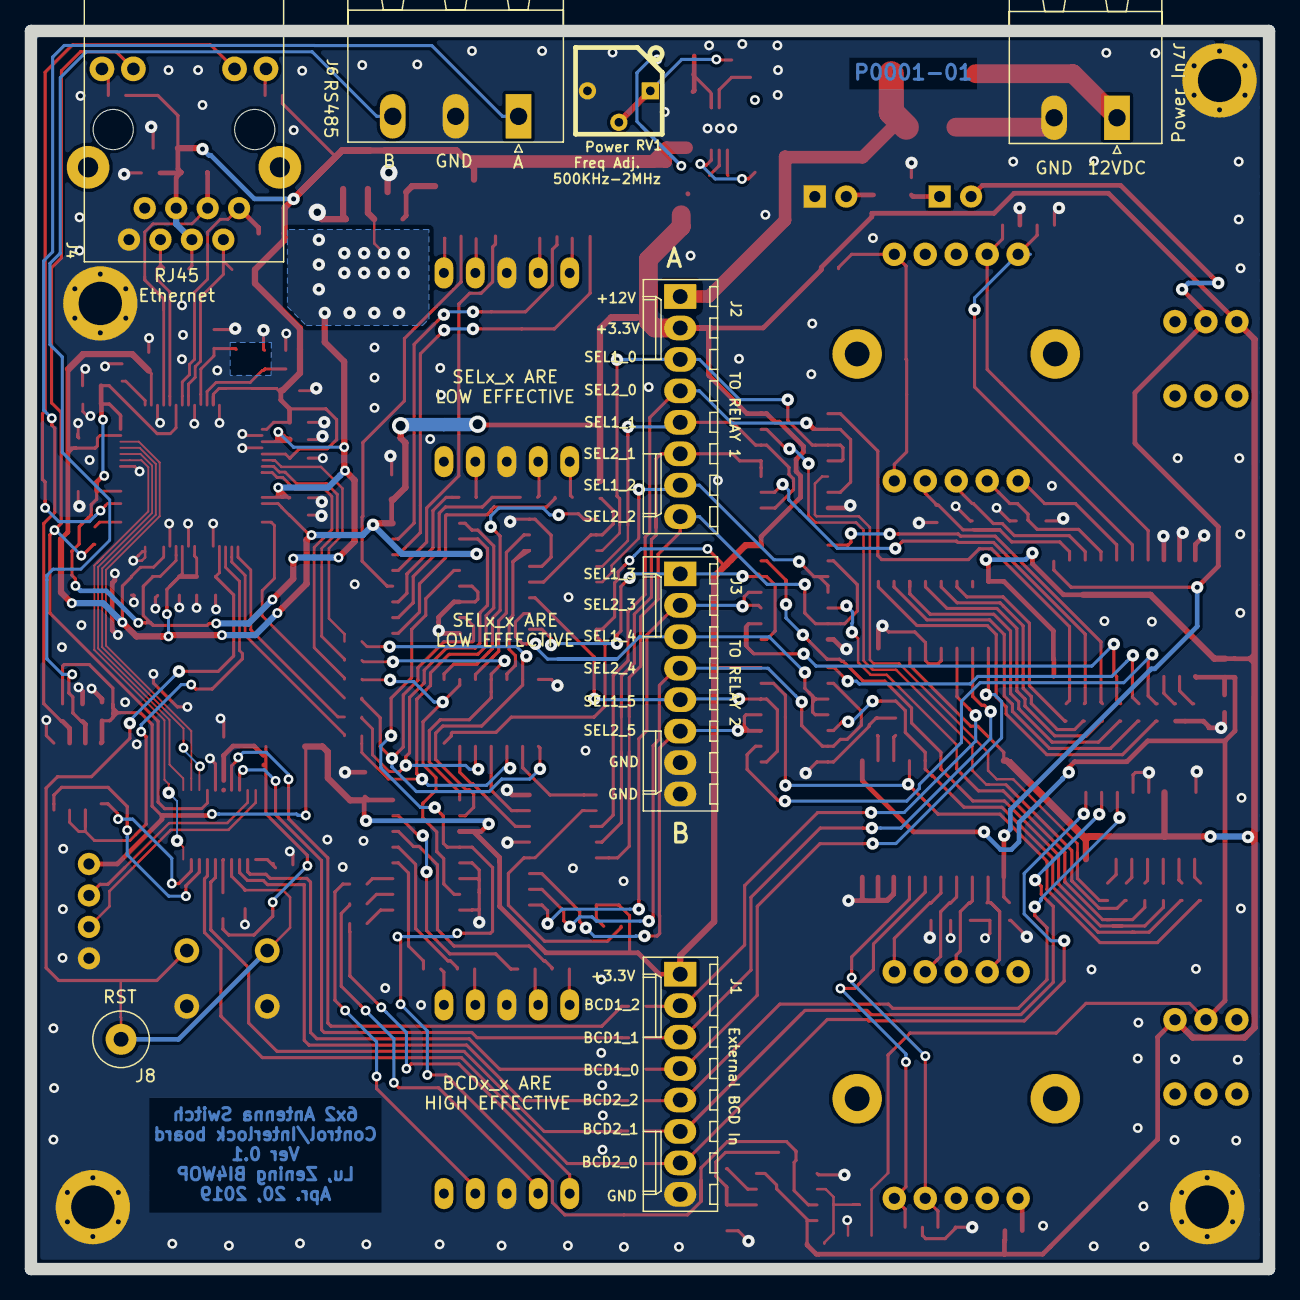
[picture p48: board PCB/history_versions/AntennaSwitch_6x2/AntennaSwitch_6x2.kicad_pcb from below]

Board: 2 copper layers, 100.0 x 100.0 mm, 161 parts (8 on the bottom side), 162 nets.

Other parts of the board:
e: M3_Screwhole

Their connections:
chasis: e.1; also elsewhere on the board
