LuZening/6x2-Antenna-Switch/MCU2/Src/main.c

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
/* Includes ------------------------------------------------------------------*/
#include "main.h"

/* USER CODE BEGIN Includes */
#include <string.h>
#include <stdbool.h>
#include "Config/Config.h"
#include "CH395.h"
#include "Lib485.h"
#include "Delay.h"
#include "Flash_EEPROM/Flash_EEPROM.h"
#include "FS.h"
#include "commands.h"
#include "SerialOverTCP.h"
/* USER CODE END Includes */

/* USER CODE BEGIN PD */
#define MIN(x,y) ((x < y)?(x):(y))
#define RX_FIFO_SIZE_485 512U
static uint8_t rx_fifo_buf_485[RX_FIFO_SIZE_485];
/* USER CODE END PD */

IWDG_HandleTypeDef hiwdg;

SPI_HandleTypeDef hspi1;

TIM_HandleTypeDef htim6;

UART_HandleTypeDef huart2;
DMA_HandleTypeDef hdma_usart2_rx;
DMA_HandleTypeDef hdma_usart2_tx;

/* USER CODE BEGIN PV */
// PINS
const PIN_typedef BCD1_0 =
{ BCD1_0_GPIO_Port, BCD1_0_Pin };
const PIN_typedef BCD1_1 =
{ BCD1_1_GPIO_Port, BCD1_1_Pin };
const PIN_typedef BCD1_2 =
{ BCD1_2_GPIO_Port, BCD1_2_Pin };
const PIN_typedef BCD2_0 =
{ BCD2_0_GPIO_Port, BCD2_0_Pin };
const PIN_typedef BCD2_1 =
{ BCD2_1_GPIO_Port, BCD2_1_Pin };
const PIN_typedef BCD2_2 =
{ BCD2_2_GPIO_Port, BCD2_2_Pin };
const PIN_typedef BCDM1_0 =
{ BCDM1_0_GPIO_Port, BCDM1_0_Pin };
const PIN_typedef BCDM1_1 =
{ BCDM1_1_GPIO_Port, BCDM1_1_Pin };
const PIN_typedef BCDM1_2 =
{ BCDM1_2_GPIO_Port, BCDM1_2_Pin };
const PIN_typedef BCDM2_0 =
{ BCDM2_0_GPIO_Port, BCDM2_0_Pin };
const PIN_typedef BCDM2_1 =
{ BCDM2_1_GPIO_Port, BCDM2_1_Pin };
const PIN_typedef BCDM2_2 =
{ BCDM2_2_GPIO_Port, BCDM2_2_Pin };
const PIN_typedef RW485 =
{ RW485_GPIO_Port, RW485_Pin };

// for remote switching
AntennaSelector_typedef Selector[N_SELECTORS];
// for monitoring
AntennaSelector_typedef SelectorM[N_SELECTORS];
// Saved data on EEPROM

uint8_t IP[4] =
{ 0, 0, 0, 0 };
char sIP_dec[16] =
{ 0 };

uint8_t IP_gateway[4] = {0,0,0,0};
uint8_t IP_mask[4] = {255,255,255,0};
uint8_t MAC[6] = {0,0,0,0,0,0};


// flags
volatile BOOL flag_PHY_reconn = false;
volatile BOOL flag_IP_conflict = false;
volatile BOOL flag_CH395_ready = false;
volatile BOOL flag_CH395_DHCP_ready = false;
const char HTTP_STR_HELLO[] = "Hello\r\n";
// web config
char ant_labels[MAX_LEN_ANT_LABELS] =
{ 0 }; // antenna labels
//extern const uint8_t FS_test_buffer[];
bool isShowingIP = false;
static int8_t idxDisplayIP = -1;
static uint8_t lenDisplayIP = 0;
// broad case updates to all clients when antenna switched
bool needUpdate = false;
// updatedFlag for each socket
uint16_t needUpdateFlagForEachSocket = 0;

/* USER CODE END PV */

void SystemClock_Config(void);
static void MX_GPIO_Init(void);
static void MX_DMA_Init(void);
static void MX_SPI1_Init(void);
static void MX_USART2_UART_Init(void);
static void MX_IWDG_Init(void);
static void MX_TIM6_Init(void);
/* USER CODE BEGIN PFP */
BOOL parse_tcp_uart_command(char *s, size_t len);
/* USER CODE END PFP */

/* USER CODE BEGIN 0 */
const Serial485_cfg_t cfg485 ={
		.pSerial = &huart2,
		.pin_RW = { RW485_GPIO_Port, RW485_Pin },
		.fifo_size = RX_FIFO_SIZE_485,
		.rx_fifo_buf = rx_fifo_buf_485,
};
/* USER CODE END 0 */

/**
  * @brief  The application entry point.
  * @retval int
  */
int main(void)
{

  /* USER CODE BEGIN 1 */
	uint8_t i;
	Selector[0].PIN_BCDs[0] = BCD1_0;
	Selector[0].PIN_BCDs[1] = BCD1_1;
	Selector[0].PIN_BCDs[2] = BCD1_2;
	Selector[0].sel = 0;
	Selector[1].PIN_BCDs[0] = BCD2_0;
	Selector[1].PIN_BCDs[1] = BCD2_1;
	Selector[1].PIN_BCDs[2] = BCD2_2;
	Selector[1].sel = 0;

	SelectorM[0].PIN_BCDs[0] = BCDM1_0;
	SelectorM[0].PIN_BCDs[1] = BCDM1_1;
	SelectorM[0].PIN_BCDs[2] = BCDM1_2;
	SelectorM[0].sel = 0;
	SelectorM[1].PIN_BCDs[0] = BCDM2_0;
	SelectorM[1].PIN_BCDs[1] = BCDM2_1;
	SelectorM[1].PIN_BCDs[2] = BCDM2_2;
	SelectorM[1].sel = 0;
  /* USER CODE END 1 */

  /* MCU Configuration--------------------------------------------------------*/

  /* Reset of all peripherals, Initializes the Flash interface and the Systick. */
  HAL_Init();

  /* Configure the system clock */
  SystemClock_Config();

  /* Initialize all configured peripherals */
  MX_GPIO_Init();
  MX_DMA_Init();
  MX_SPI1_Init();
  MX_USART2_UART_Init();
  MX_IWDG_Init();
  MX_TIM6_Init();
  /* USER CODE BEGIN 2 */

	// Check EEPROM
	 EEPROM.base_addr = (uint32_t*)EEPROM_BASE_ADDR;
	 EEPROM.size = 400;

	/* init: config */
	load_config(&cfg);
	if (!config_check_valid(&cfg))
	{
		// invalid config data, erase the flash page
		uint32_t PageError = 0;
		__disable_irq();
		HAL_FLASH_Unlock();
		FLASH_EraseInitTypeDef fe = {.TypeErase=FLASH_TYPEERASE_PAGES, .PageAddress=(uint32_t)EEPROM.base_addr, .NbPages=1};
		HAL_FLASHEx_Erase(&fe, &PageError);
		HAL_FLASH_Lock();
		__enable_irq();
		init_config(&cfg);
	}


	/* init: antenna selections */
	uint8_t antnums[N_SELECTORS];
	for (i = 0; i < N_SELECTORS; ++i)
	{
		antnums[i] = cfg.nRadioToAntNums[i];
	}
	switch_Antenna(antnums, N_SELECTORS);



	// init 485
	begin_serial485(p485, &cfg485);
	#ifdef DEBUG
//	  test_485_blockmode(p485);
	#endif
    start_receive_DMA(p485);

	/* init: File System for webpages*/
	FS_begin(&FS, (uint32_t*) FS_BASE_ADDR);
//	i = FS_exists(&FS, "/index.html");
//	i = FS_exists(&FS, "/b.f");

#ifndef DEBUG
	HAL_IWDG_Refresh(&hiwdg); // feed dog
#endif

	/* init: Ethernet chip */
	HAL_Delay(200); // wait for CH395 being ready from power on
	for (i = 5; i < 0xff; ++i)
	{
		if (CH395CMDCheckExist(i) != (uint8_t) ~i)
		{
			DEBUG_LOG("CH395 self check error!\n");
			HAL_Delay(50);
		}
		else
			break;
	}

	RESET_CH395: reset_CH395();
  /* USER CODE END 2 */

  /* Infinite loop */
  /* USER CODE BEGIN WHILE */
	static uint32_t lastWakeupTime;
	static uint32_t lastCH395Process = 0;  // Rate limiting for CH395 interrupts
	// WebSocket frame buffers - moved here for proper scope
	static uint8_t websocket_frame_shared_buffer[128];
	static uint8_t websocket_frame_shared_buffer_2[128];
	lastWakeupTime = HAL_GetTick();
	while (1)
	{

#ifndef DEBUG
		HAL_IWDG_Refresh(&hiwdg); // feed dog
#endif
		/* TASK0: handle CH395 interrupt flags */
		{
			// CASE1: PHY disconnected, need to reconnect, use up the reconn flag to avoid reentrance
			if (flag_PHY_reconn && !flag_CH395_ready)
			{
				flag_PHY_reconn = false;
				goto RESET_CH395;
			}
			/*** polling task: execute command and transmit response to the client in HTTPHandle ***/
			if (flag_CH395_ready && ch395.RX_received)
			{
				// Rate limiting: process CH395 at most every 10ms to avoid starving RS485
				uint32_t nowTick = HAL_GetTick();
				if(nowTick - lastCH395Process >= 10)
				{
					// prepare respond to stocking requests
					HTTPHandle(&ch395);
					lastCH395Process = nowTick;
				}
			}
			/*** polling task: close timed out (long time no received data) connections to avoid deadlock ***/
			uint32_t nowTick = HAL_GetTick();
			for (int i = 0; i < NUM_SOCKETS - 1; ++i) // exculding sock 0
			{
				HTTPRequestParseState *pS = &parseStates[i];
				if ((nowTick - pS->last_active_tick >= MAX_HTTP_TICK_IDLE))
				{
					// timeout, close the connection
					if (pS->connection != CLOSED)
					{
						HTTPclose(i+1);
						resetHTTPParseState(pS);
						CH395TCPDisconnect(i+1); // disconnnect the connection
					}
				}
			}
			/*** polling task: close Websocket connections from which a CLOSE frame and been received  ***/
			for(i = 1; i < NUM_SOCKETS; ++i)
			{
				HTTPRequestParseState *pS = &parseStates[i-1];
				// close the connection if websocket received a CLOSE frame
				// and the response has been transmitted
				if((pS->ws_handshaked == WS_CLOSED) && ((ch395.TX_available & (1 << i)) != 0 ))
				{
					CH395TCPDisconnect(i);
					HTTPclose(i);
					resetHTTPParseState(pS);
				}
			}

			/*** polling task: broadcast updates to the clients proactively ***/
			if(needUpdate || (needUpdateFlagForEachSocket != 0))
			{
				// set all flags for all the sockets
				if(needUpdate)
				{
					for(i = 1; i < NUM_SOCKETS; ++i)
					{
						HTTPRequestParseState *pS = parseStates +i - 1;
						if((ch395.socket_connected & (1U << i)) == 0)
							needUpdateFlagForEachSocket &= ~(1U << i); // clear flag if socket not connected
						else if(
							(pS->connection == UPGRADED_WS)
							||
							(ch395.cfg.protocols[i] == CH395_PROTOCOL_TCP)
						)
							needUpdateFlagForEachSocket |= (1U << i); // set the flag if the protocol is TCP or WebSocket
					}
					needUpdate = false;
				}
				/* try to transmit updates proactively */
				for(i = 1; i < NUM_SOCKETS; ++i)
				{
					if((needUpdateFlagForEachSocket & (1U << i)) == 0)
						continue;
					uint8_t* buf_to_transmit = NULL;
					uint16_t len_to_transmit = 0;
					// transmit only if the CH395 chip is not busy
					if((ch395.TX_available & (1U << i)) != 0)
					{
						HTTPRequestParseState *pS = parseStates +i - 1;
						// make payload
						if(pS->connection == UPGRADED_WS)
						{
							// make content
							int len_content = make_ant_alloc_str((char*)websocket_frame_shared_buffer);
							size_t lenOrig = WSMakeStrOriginal(websocket_frame_shared_buffer_2, sizeof(websocket_frame_shared_buffer_2), "/getalloc", (char*)websocket_frame_shared_buffer);
							len_to_transmit = ws_make_text_frame(websocket_frame_shared_buffer, sizeof(websocket_frame_shared_buffer), websocket_frame_shared_buffer_2, lenOrig);
							buf_to_transmit = (uint8_t*)websocket_frame_shared_buffer;
						}
						else if(ch395.cfg.protocols[i] == CH395_PROTOCOL_TCP)
						{
							// TODO: prepare content for TCP

						}
						// transmit
						if(len_to_transmit)
						{
							CH395StartSendingData(i, len_to_transmit);
							CH395ContinueSendingData(buf_to_transmit, len_to_transmit);
							CH395Complete();
						}
						// update flags
						ch395.TX_available &= ~(1<<i); // invalidate TX flag, will be validated again when TX DONE interrupt
						needUpdateFlagForEachSocket &= ~(1 << i);
					}
				}
			}

			/*** polling task: broadcast socket status to all WebSocket/TCP clients periodically ***/
			{
				static uint32_t lastSocketBroadcastTime = 0;
				uint32_t currentTime = HAL_GetTick();

				// Broadcast socket status every 5000ms (5 seconds)
				if((currentTime - lastSocketBroadcastTime) >= 5000)
				{
					lastSocketBroadcastTime = currentTime;

					// Send to all connected WebSocket and TCP sockets
					for(i = 1; i < NUM_SOCKETS; ++i)
					{
						// Only broadcast if socket is connected and ready for TX
						if((ch395.socket_connected & (1U << i)) && (ch395.TX_available & (1U << i)))
						{
							HTTPRequestParseState *pS = parseStates + i - 1;

							// Only broadcast to WebSocket and TCP connections
							if((pS->connection == UPGRADED_WS) || (ch395.cfg.protocols[i] == CH395_PROTOCOL_TCP))
							{
								// Create socket status string
								int len_content = make_socket_status_str((char*)websocket_frame_shared_buffer);

								if(pS->connection == UPGRADED_WS)
								{
									// For WebSocket: wrap in WebSocket frame
									size_t lenOrig = WSMakeStrOriginal(websocket_frame_shared_buffer_2, sizeof(websocket_frame_shared_buffer_2), "/socket", (char*)websocket_frame_shared_buffer);
									uint16_t len_to_transmit = ws_make_text_frame(websocket_frame_shared_buffer, sizeof(websocket_frame_shared_buffer), websocket_frame_shared_buffer_2, lenOrig);

									// Transmit WebSocket frame
									CH395StartSendingData(i, len_to_transmit);
									CH395ContinueSendingData(websocket_frame_shared_buffer, len_to_transmit);
									CH395Complete();
								}
								else // TCP
								{
									// For TCP: send raw data with URI prefix
									size_t lenOrig = WSMakeStrOriginal(websocket_frame_shared_buffer_2, sizeof(websocket_frame_shared_buffer_2), "/socket", (char*)websocket_frame_shared_buffer);

									// Transmit TCP data
									CH395StartSendingData(i, lenOrig);
									CH395ContinueSendingData(websocket_frame_shared_buffer_2, lenOrig);
									CH395Complete();
								}

								// Update TX flag
								ch395.TX_available &= ~(1 << i);
							}
						}
					}
				}
			}

			/*** polling task: monitoring the interrupt Pin and trigger the interrupt ***/
			// Rate limiting: don't process interrupts too frequently
			if(HAL_GPIO_ReadPin(CH395_INT_GPIO_Port, CH395_INT_Pin) == GPIO_PIN_RESET)
			{
				/* parse incoming packet, extract arguments and URI */
				interrupt_CH395();
			}
		}


		// TASK0.5: handle 485
		// parse received content
		{
			static uint8_t cmd_buf_485[LIB485_COMM_BUFFER_SIZE];
			int sizeCmd = read_command_from_serial485(p485, cmd_buf_485, sizeof(cmd_buf_485));
			if ((sizeCmd > 0) && (execute_command_string(&CommandParser, cmd_buf_485, sizeCmd) >= 0))
			{
				// if the command has response to the client, the send
				// hasResponse stores the length of the response content
				if (CommandParser.hasResponse > 0)
				{
					send_serial485(p485,  CommandParser.bufRet, CommandParser.hasResponse);
				}
			}
		}
		// TASK1: handle EEPROM save
		uint32_t nowTick = HAL_GetTick();
		{
			// save each 5 seconds
			if (nowTick - lastWakeupTime >= 3000)
			{
				if (isModified)
				{
					save_config(&cfg);
					isModified = false;
					lastWakeupTime = nowTick;
				}
			}
		}

		/* TASK2: check if CPLD sends IP request */
		{
			// when SelectorM1&2 all pins are activated(LOW), means requesting IP display
			bool activated = true;
			for (uint8_t iSel = 0; iSel < N_SELECTORS; ++iSel)
			{

				for (uint8_t iBCD = 0; iBCD < N_BCD_PINS; ++iBCD)
				{
					uint8_t d = HAL_GPIO_ReadPin(
							SelectorM[iSel].PIN_BCDs[iBCD].group,
							SelectorM[iSel].PIN_BCDs[iBCD].pin);
					if (d != GPIO_PIN_RESET)
					{
						activated = false;
						break;
					}
				}
				if (!activated)
					break;
			}
			if (idxDisplayIP < 0 && activated)
				display_IP(true);
			else if (idxDisplayIP >= 0 && !activated)
				display_IP(false);
		}
    /* USER CODE END WHILE */

    /* USER CODE BEGIN 3 */
	}
  /* USER CODE END 3 */
}

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
/* USER CODE BEGIN 4 */
//void HAL_UART_RxCpltCallback(UART_HandleTypeDef *huart)
//{
//	onReceived_serial485(p485);
//}
void reset_CH395()
{
	uint8_t i ;
	flag_CH395_ready = false;
	ch395.RX_received = 0;
	ch395.SOCK_responding = -1;
	ch395.TX_available = 0xff;
	ch395.socket_connected = 0;

	// setting HTTP sockets, 0, 1,2,3,4,5,6
	for ( i = 0; i < CH395_UDP_LISTEN_SOCK; i++)
	{
		ch395.cfg.protocols[i] = CH395_PROTOCOL_HTTP;
		ch395.cfg.ports[i] = cfg.portHTTP;
	}
	// setting primitive TCP sockets, 5,6
//	for ( i = CH395_TCP_LISTEN_SOCK; i < 7; i++)
//	{
//		ch395.cfg.protocols[i] = CH395_PROTOCOL_TCP;
//		ch395.cfg.ports[i] = cfg.portTCP;
//	}
	// setting primitive UDP socket 7
	i = CH395_UDP_LISTEN_SOCK;
	ch395.cfg.protocols[i] = CH395_PROTOCOL_UDP;
	ch395.cfg.ports[i] = cfg.portUDP;
	CH395CMDReset();
//	Delay_ms(100); // wait for CH395 being ready from power on
	HAL_Delay(100);
	// get CH395 chip MAC address
	CH395CMDGetMACAddr(MAC);
	// initialize CH395 GPIO settings to INPUT/PULL DOWN
//	CH395WriteGPIOAddr(GPIO_DIR_REG, 0);
//	CH395WriteGPIOAddr(GPIO_PU_REG, 0);
//	CH395WriteGPIOAddr(GPIO_PD_REG, 0xff);
	CH395SetBuffer();
	// initialize TCP server
	flag_CH395_ready = CH395TCPServerStart(*(uint32_t*) IP, cfg.portHTTP, cfg.portTCP);
	//CH395SetBuffer();
	flag_PHY_reconn = false;
	flag_IP_conflict = false;
	flag_CH395_DHCP_ready = false;
}


/*************************************************************
 * ************************************************************
 * Very Important: The main funcion for Ethernet activities
 * ************************************************************
 * */
void interrupt_CH395()
{
	char* line, *tok_arg, *line_tok_saveptr, *arg_tok_saveptr;
	// process interrupt requests from CH395
	uint8_t sock_int_status, i;
	uint16_t glob_int_status;
	//BEGIN_INT_CH395:
	// read global int status
	glob_int_status = CH395CMDGetGlobIntStatus_ALL();

	// CASE: TCP unreach error
	if (glob_int_status & GINT_STAT_UNREACH)
	{
		uint8_t unreach[8];
		CH395CMDGetUnreachIPPT(unreach);
		// invalidate all Parsers
		// unreach byte 3, byte 2 combine to be port number
		uint16_t port = ((uint16_t)unreach[3] << 8) | unreach[2];
		for(uint8_t i = 1; i < NUM_SOCKETS; ++i)
		{
			HTTPRequestParseState *pS = parseStates + i - 1;
			if(pS->port == port) resetHTTPParseState(pS);
		}
	}

	// CASE: DHCP
	if (glob_int_status & GINT_STAT_DHCP)
	{
		if(CH395GetDHCPStatus() == 0)
		{
			flag_CH395_DHCP_ready = true;
			// get IP info from CH395
			uint8_t IPv4_Gateway_info[20];
			if(flag_CH395_DHCP_ready)
			{
				CH395GetIPInf(IPv4_Gateway_info); // BIG endian
				memcpy(IP, IPv4_Gateway_info, 4); // in CH395, the byte order of IPs and MACs are reversed (IP and MAC are Big-endian, others are little-endian)
				memcpy(IP_gateway, IPv4_Gateway_info + 4, 4); //
				memcpy(IP_mask, IPv4_Gateway_info + 8, 4); //
			}
		}
		else
		{
			flag_CH395_DHCP_ready = false;
		}
	}
	// CASE: Phy change
	if (glob_int_status & GINT_STAT_PHY_CHANGE)
	{
		uint8_t phy_status = (CH395CMDGetPHYStatus());
		switch (phy_status)
		{
		case PHY_DISCONN:
			flag_CH395_ready = false;
			flag_PHY_reconn = true;
			break;
		default:
			flag_CH395_ready = true;
			flag_PHY_reconn = false;
			break;
		}
	}

	// get socket interrupt status
	glob_int_status >>= 4;
	// exit if no socket event occured
	if (!glob_int_status)
		goto END_INT_CH395;
	// handle SOCKET events
	for (i = 1; (i < NUM_SOCKETS) && (glob_int_status > 0); ++i)
	{
		glob_int_status >>= 1;
		if (glob_int_status & 1) // the LSB of glob_int_status indicates SOCK#i interrupt status
		{
			sock_int_status = CH395GetSocketInt(i);
			// CASE 1: Send buffer free
			if (sock_int_status & SINT_STAT_SENBUF_FREE)
			{
				ch395.TX_available |= (1 << i);
			}
			// CASE 2: data received on SOCK i
			if (sock_int_status & SINT_STAT_RECV)
			{
				/*
				 * This section of code reads at most CH395_SIZE_BUFFER-1 bytes from PHY buffer
				 * and discards the rest of the received data
				 */
				flag_CH395_ready = true; // force the chip to be active if anything is received
				HTTPRequestParseState *pS = parseStates + i - 1;
				activateHTTPParseState(pS); // renew the timeout counter when data received
				// get length of received data
				uint16_t len = CH395GetRecvLength(i);
				// WARNING: avoid multiple access to the CH395 buffer, not thread safe
				CH395GetRecvData(
						i,
						(len < CH395_SIZE_BUFFER - 1) ? (len) : (len = CH395_SIZE_BUFFER - 1),
						(uint8_t*) ch395.buffer
							);
				ch395.buffer[len] = 0; // terminate the recved text stream
				/* Distinguish between different protocols
				 * Either HTTP,
				 * or TCP (for UART over IP gateway )
				 */
 				switch (ch395.cfg.protocols[i])
				{
				/* extract arguments and URI from the incoming packet */
				/* in the meantime, WS for realtime data exchange which is upgraded from HTTP */
				case CH395_PROTOCOL_HTTP:
					if(pS->connection == CLOSED)
						resetHTTPParseState(pS);
					else // for long connections, preserve some necessary information from previous requests, especially for connection type
						resetHTTPParseState_for_long_connection(pS);
					pS->sock_index = i;
					/* classify request types: */
#define REQUEST_TYPE_HTTP 0
#define REQUEST_TYPE_TCP 1
					uint8_t sReqType = REQUEST_TYPE_HTTP;
					if(strnstr(ch395.buffer, "HTTP", len))
					{
						sReqType = REQUEST_TYPE_HTTP;
					}
					else if(len > 0)
					{
						sReqType = REQUEST_TYPE_TCP;
					}

					/* CASE 1: Websocket or Plain TCP */
					if(((pS->connection == UPGRADED_WS) && (pS->ws_handshaked == WS_HANDSHAKED)) || (sReqType == REQUEST_TYPE_TCP))
					{
						// can be parsed as WebSocket protocol
						if(ws_parse_frame(ch395.buffer, (size_t)len, &pS->ws) > 0)
						{
							// sometimes the client skips the upgrade request, sending a WebSocket payload directly
							if((pS->connection != UPGRADED_WS) || (pS->ws_handshaked != WS_HANDSHAKED))
							{
								pS->connection = UPGRADED_WS;
								pS->ws_handshaked = WS_HANDSHAKED;
							}
							pS->ready_for_making_response = true;
							switch(pS->ws.opcode)
							{
							case WS_OPCODE_TEXT:
								/* parse TEXT, but Too Long Don't Read, execute command later
								 * example:
								 * uri=/switch&sel1=4&sel2=5
								 * example:
								 * uri=/getalloc
								 * response:
								 * sel1=1&sel2=3
								 * */
								if(pS->ws.payload_len < MAX_LEN_RESPONSE_HEADER - 1)
								{
									// copy payload to the shared buffer, so futher processes will be easier
									memcpy(pS->response_header, pS->ws.payload, pS->ws.payload_len);
									pS->response_header[pS->ws.payload_len] = 0; // terminate the payload
									// unmask the payload
									ws_unmask_payload(pS->response_header, (size_t)(pS->ws.payload_len), pS->ws.masking_key);
									// SPECIAL CASE: if the content is "ping"
									if(strnstr(pS->response_header, "ping",  pS->ws.payload_len))
									{
										// respond with "pong"
										WSSendStr(pS, NULL, "pong");
									}
									else
									{
										// tokenize arguments
										// URI=&arg0=&arg1=\r\n
										line_tok_saveptr = pS->response_header;
										line = strsepstr(&line_tok_saveptr, "\r\n");
										if(line)
										{
											tok_arg = strtok_r(line, "&", &arg_tok_saveptr);
											while(tok_arg)
											{
												DEBUG_LOG("Arg: %s\r\n", tok_arg);
												// save URI argument in a special variable
												if(strncmp(tok_arg, "URI", 3) == 0)
													strncpy(pS->URI, tok_arg + 4, MAX_LEN_URI); // copy content after =
												// save other argument in argv
												else
													pS->argv[pS->argc++] = tok_arg; // tok_arg: "arg=xxx\0"
												tok_arg = strtok_r(NULL, "&", &arg_tok_saveptr);
											}
										}
									}
								}
								break;
							case WS_OPCODE_PING:
								// send PONG frame
								pS->len_response_header = ws_make_pong_frame((uint8_t*)pS->response_header);
								pS->len_response_content_remain = 0;
								pS->response_stage = RESPONSE_PREPARED;
								break;
							case WS_OPCODE_CLOSE:
								// respond the  close frame
								pS->len_response_header =  ws_make_close_frame((uint8_t*)pS->response_header, WS_CLOSE_REASON_BY_PEER);
								pS->len_response_content_remain = 0;
								pS->response_stage = RESPONSE_PREPARED;
								pS->ws_handshaked = WS_TO_CLOSE; // mark close here, will be closed in main loop after responded
								break;
							}
							// put this socket into responding slot if the slot is empty
							if(pS->ready_for_making_response)
							{
								ch395.RX_received |= (1 << i);
								if (ch395.SOCK_responding < 0)
									ch395.SOCK_responding = i;
							}
						}
						/* CASE: plain TCP */
						else
						{
							// parse received content
							if (execute_command_string(&CommandParser, ch395.buffer,len) >= 0)
							{
								// if the command has response to the client, the send
								// hasResponse stores the length of the response content
								if (CommandParser.hasResponse > 0)
								{
									pS->ready_for_making_response = true;
									strncpy(pS->response_header, CommandParser.bufRet,
											CommandParser.hasResponse);
									pS->len_response_header = CommandParser.hasResponse;
									pS->len_response_content_remain = 0;
									pS->response_stage = RESPONSE_PREPARED;
									ch395.RX_received |= (1 << i);
									if (ch395.SOCK_responding < 0) // put this socket into responding slot if the slot is empty
										ch395.SOCK_responding = i;
									CommandParser.hasResponse = 0;
								}
							}
						}
					}
					/* CASE DEFAULT: plain HTTP */
					else
					{
						if (parse_http(pS, ch395.buffer))
						{
							ch395.RX_received |= (1 << i); // mark received flag
							if (ch395.SOCK_responding < 0) // put this socket into responding slot if the slot is empty
								ch395.SOCK_responding = i;
						}
						/* USER CODE BEGIN HTTP_PARSE_FAILED */
						else
						{
							// HTTP parsing failed, close the connection to prevent resource leak
							CH395TCPDisconnect(i);
							HTTPclose(i);
							resetHTTPParseState(pS);
						}
						/* USER CODE END HTTP_PARSE_FAILED */
					}
					break;
				case CH395_PROTOCOL_TCP:
					// parse as virtual UART
					if(pS->connection == CLOSED)
						resetHTTPParseState(pS);
					else // for long connections, keep some necessary information from previous requests
						resetHTTPParseState_for_long_connection(pS);
					pS->sock_index = i;
					// parse received content
					if (execute_command_string(&CommandParser, ch395.buffer,len) >= 0)
					{
						// if the command has response to the client, the send
						// hasResponse stores the length of the response content
						if (CommandParser.hasResponse > 0)
						{
							pS->ready_for_making_response = true;
							strncpy(pS->response_header, CommandParser.bufRet,
									CommandParser.hasResponse);
							pS->len_response_header = CommandParser.hasResponse;
							pS->len_response_content_remain = 0;
							pS->response_stage = RESPONSE_PREPARED;
							ch395.RX_received |= (1 << i);
							if (ch395.SOCK_responding < 0) // put this socket into responding slot if the slot is empty
								ch395.SOCK_responding = i;
							CommandParser.hasResponse = 0;
						}
					}
					break;
				/* UDP for virtual COM port detecting protocol */
				case CH395_PROTOCOL_UDP:
					resetHTTPParseState(pS);
					pS->sock_index = i;
					// parse as detection message over UDP
					// UDP data has first 8 bytes as misc information
					if(len > 8)
					{
						uint16_t len_UDP_data = 0;
						uint16_t port_dest_UDP;
						uint8_t IP_dst_UDP[4];
						len_UDP_data = (uint16_t)(ch395.buffer[1] << 8) | (uint16_t)ch395.buffer[0]; // little-endian
						port_dest_UDP = (uint16_t)(ch395.buffer[3] << 8) | (uint16_t)ch395.buffer[2];
						memcpy(IP_dst_UDP, ch395.buffer+4, 4);
						if((len_UDP_data - 8 >= LEN_USR_DETECTION_MSG) &&
								strncmp(ch395.buffer + 8, USR_DETECTION_MSG, LEN_USR_DETECTION_MSG) == 0)
						{
							pS->ready_for_making_response = true;
							USR_response_t USR = {
									.IPv4_gateway = IP_gateway,
									.IPv4_mask = IP_mask,
									.IPv4_self = IP,
									.IPv4_target = IP_gateway,
									.MAC = MAC,
									.baud = 115200,
									.mode = 3, // TCP server
									.port_self = cfg.portHTTP,
									.port_target = cfg.portHTTP,
									.stopbit_mode = 3,
							};
							len_UDP_data = (uint16_t)prepare_USR_response_msg(&USR, pS->response_header);
							pS->len_response_header = len_UDP_data;
							pS->len_response_content_remain = 0;
							pS->response_stage = RESPONSE_PREPARED;
							ch395.socket_connected |= (1<<i); // UDP has no connection state, so mark it as always connected
							ch395.TX_available |= (1 << i);
							ch395.RX_received |= (1 << i);
							if (ch395.SOCK_responding < 0) // put this socket into responding slot if the slot is empty
								ch395.SOCK_responding = i;
							CH395SetSocketDesIP(i, IP_dst_UDP);
							CH395SetSocketDesPort(i, port_dest_UDP);
						}
					}
					break;
				default:
					// protocol not assigned to the socket
					break;
				}
				CH395ClearRecvBuf(i);
			}
			// CASE 3: SOCK i connected
			if (sock_int_status & SINT_STAT_CONNECT)
			{
				ch395.socket_connected |= (1 << i);
				ch395.TX_available |= (1 << i);
			}
			// CASE 4: SOCK i disconnected
			if (sock_int_status & SINT_STAT_DISCONNECT) // SOCK i disconnected
			{
				ch395.socket_connected &= ~(1 << i);
				ch395.RX_received &= ~(1 << i);
				ch395.TX_available |= (1 << i);
				if (ch395.SOCK_responding == i)
					ch395.SOCK_responding = -1; // release the responding socket flag
				HTTPRequestParseState *pS = parseStates + i - 1;
				resetHTTPParseState(pS);
			}
		}
	}
END_INT_CH395:
	return;
}


static bool check_conflict(uint8_t *antnums, uint8_t n)
{
	bool conflict = false;
	uint32_t detector = 0;
	for(uint8_t i= 0; i < n; ++i)
	{
		uint8_t sel = antnums[i];
		// replace 0xff by current selected antnum,
		if(sel == 0xff)
			sel = Selector[i].sel;

		uint32_t mask = 1U << sel; // cannot exceed 31
		// already set to 1, means conflict
		if((detector & mask) != 0U)
		{
			conflict =true;
			break;
		}
		detector |= mask;
	}
	return conflict;
}


// @params:
// @antnums: array of selecte ant numbers. NULL: For display IP: When set to NULL, write output pins only and leave all state variables unchanged.
int8_t switch_Antenna(uint8_t *antnums, uint8_t n)
{
	int8_t r = 0;
	// when antnums is NULL, just keep the state of each selector and update output pins
	uint8_t i;

	// check conflict
	if(check_conflict(antnums, n))
	{
		r = -1; // conflict
		goto EXIT_SWITCH_ANTENNA;
	}

	uint8_t vNew;
	for (i = 0; i < MIN(n, N_SELECTORS); ++i)
	{
		// parse input
		if(antnums != NULL)
		{
			vNew = antnums[i];
;
		}
		// WARNING: IP address display function multiplex with selector GPIOs,
		// resume previous results before displaying IP
		else
		{
			vNew = Selector[i].sel;
		}


		if(vNew != 0xff) // 0xff means do not change
		{
			// write pins
			Selector[i].sel = vNew;
			uint8_t val = ~Selector[i].sel;
			for (uint8_t iBCD = 0; iBCD < N_BCD_PINS; ++iBCD)
			{
				PIN_typedef pin = Selector[i].PIN_BCDs[iBCD];
				HAL_GPIO_WritePin(pin.group, pin.pin, (val >> iBCD) & 0x01);
			}

			// store configurations
			if(antnums)
			{
				cfg.nRadioToAntNums[i] = Selector[i].sel;
				isModified = true;
				needUpdate = true;
			}
		}

	}
EXIT_SWITCH_ANTENNA:
	return r;
}


void get_Antenna_real_BCDs(uint8_t *antnums, uint8_t n) //3-0:SEL1[2:0] 7-4:SEL2[2:0] GPIOs are Low Effective
{
	for (uint8_t i = 0; i < MIN(n, N_SELECTORS); ++i)
	{
		uint8_t res = 0;
#ifdef BCDM_ON_CH395
		d = CH395ReadGPIOAddr(GPIO_IN_REG); // read CH395 GPIO
		res |= (d >> BCDM1_0) & 1;// bit 0: BCDM1_0
		res |= ((d >> BCDM1_1) & 1) << 1;// bit 1: BCDM1_1
		res |= ((d >> BCDM1_2) & 1) << 2;// bit 2: BCDM1_2
		res |= ((d >> BCDM2_0) & 1) << 4;// bit 0: BCDM2_0
		res |= ((d >> BCDM2_1) & 1) << 5;// bit 1: BCDM1_1
		res |= ((d >> BCDM2_2) & 1) << 6;// bit 2: BCDM1_1
#else
		for (uint8_t iBCD = 0; iBCD < N_BCD_PINS; ++iBCD)
		{
			res |= (((!HAL_GPIO_ReadPin(SelectorM[i].PIN_BCDs[iBCD].group,
					SelectorM[i].PIN_BCDs[iBCD].pin)) & 0x01) << iBCD); // BCDM1[0]
		}
#endif
		antnums[i] = res;
	}

}

/* Display IP functions BEGIN */

// USE BCD1_0, BCD1_1, BCD1_2, BCD2_0 for transferring "0~9" and "-" digits
void display_IP(bool start)
{
	if (start) // start == true, start the timer
	{
		idxDisplayIP = 0;

		//  HAL_GPIO_WritePin(XDISPLAY_GPIO_Port, XDISPLAY_Pin, 0);
		// turn off display
		uint8_t d = ~(0x0e);
		HAL_GPIO_WritePin(Selector[0].PIN_BCDs[0].group,
				Selector[0].PIN_BCDs[0].pin, d & 0x01);
		HAL_GPIO_WritePin(Selector[0].PIN_BCDs[1].group,
				Selector[0].PIN_BCDs[1].pin, (d >> 1) & 0x01);
		HAL_GPIO_WritePin(Selector[0].PIN_BCDs[2].group,
				Selector[0].PIN_BCDs[2].pin, (d >> 2) & 0x01);
		HAL_GPIO_WritePin(Selector[1].PIN_BCDs[0].group,
				Selector[1].PIN_BCDs[0].pin, (d >> 3) & 0x01);

		// transform IP to string, and get the length of the string
		lenDisplayIP = IPv4_to_s(sIP_dec ,IP);
		// start the timer
		HAL_TIM_Base_Start_IT(&htim6);
	}
	else // start == false, stop the timer
	{
		HAL_TIM_Base_Stop_IT(&htim6);
		idxDisplayIP = -1;
		// resume GPIO outputs
		switch_Antenna(NULL, N_SELECTORS);
	}
}

void HAL_TIM_PeriodElapsedCallback(TIM_HandleTypeDef *htim)
{
	/* display IP address */
	if (htim == &htim6)
	{
		uint8_t d;

		// termination conditon
		if(idxDisplayIP < 0)
		{
			HAL_TIM_Base_Stop_IT(htim);
			return;
		}

		// display
		if (idxDisplayIP < lenDisplayIP)
		{
			char s = sIP_dec[idxDisplayIP];
			if (s >= '0' && s <= '9')
			{
				d = (s - '0');
				d = ~d;

			}
			else if(s == '.') // display "-" instead of '.', activate all 4 pins
			{
				d = ~(0x0f);
			}
			else
			{
				d = ~(0x0e); // no display
			}
			HAL_GPIO_WritePin(Selector[0].PIN_BCDs[0].group,
					Selector[0].PIN_BCDs[0].pin, d & 0x01);
			HAL_GPIO_WritePin(Selector[0].PIN_BCDs[1].group,
					Selector[0].PIN_BCDs[1].pin, (d >> 1) & 0x01);
			HAL_GPIO_WritePin(Selector[0].PIN_BCDs[2].group,
					Selector[0].PIN_BCDs[2].pin, (d >> 2) & 0x01);
			HAL_GPIO_WritePin(Selector[1].PIN_BCDs[0].group,
					Selector[1].PIN_BCDs[0].pin, (d >> 3) & 0x01);
			++idxDisplayIP;
		}
		// at the end of transmission, pause for a while
		else if(idxDisplayIP < lenDisplayIP + 3)
		{
			d = ~(0x0e); // no display
			HAL_GPIO_WritePin(Selector[0].PIN_BCDs[0].group,
					Selector[0].PIN_BCDs[0].pin, d & 0x01);
			HAL_GPIO_WritePin(Selector[0].PIN_BCDs[1].group,
					Selector[0].PIN_BCDs[1].pin, (d >> 1) & 0x01);
			HAL_GPIO_WritePin(Selector[0].PIN_BCDs[2].group,
					Selector[0].PIN_BCDs[2].pin, (d >> 2) & 0x01);
			HAL_GPIO_WritePin(Selector[1].PIN_BCDs[0].group,
					Selector[1].PIN_BCDs[0].pin, (d >> 3) & 0x01);
			++idxDisplayIP;
		}
		else
		{
			idxDisplayIP = -1;
			HAL_TIM_Base_Stop_IT(htim);
		}
	}
}
/* Display IP functions END */
/* USER CODE END 4 */
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
