LuZening/6x2-Antenna-Switch/MCU2/Inc/main.h

#define N_BCD_PINS 3
#define CH395_INT_Pin GPIO_PIN_1
#define CH395_INT_GPIO_Port GPIOA
#define SPI1_CS_Pin GPIO_PIN_4
#define SPI1_CS_GPIO_Port GPIOA
#define XDISPLAY_Pin GPIO_PIN_10
#define XDISPLAY_GPIO_Port GPIOB
#define RW485_Pin GPIO_PIN_11
#define RW485_GPIO_Port GPIOB
#define BCDM2_2_Pin GPIO_PIN_12
#define BCDM2_2_GPIO_Port GPIOB
#define BCDM2_1_Pin GPIO_PIN_13
#define BCDM2_1_GPIO_Port GPIOB
#define BCDM2_0_Pin GPIO_PIN_14
#define BCDM2_0_GPIO_Port GPIOB
#define BCDM1_2_Pin GPIO_PIN_15
#define BCDM1_2_GPIO_Port GPIOB
#define BCDM1_1_Pin GPIO_PIN_8
#define BCDM1_1_GPIO_Port GPIOA
#define BCDM1_0_Pin GPIO_PIN_9
#define BCDM1_0_GPIO_Port GPIOA
#define BCD2_2_Pin GPIO_PIN_10
#define BCD2_2_GPIO_Port GPIOA
#define BCD2_1_Pin GPIO_PIN_11
#define BCD2_1_GPIO_Port GPIOA
#define BCD2_0_Pin GPIO_PIN_12
#define BCD2_0_GPIO_Port GPIOA
#define BCD1_2_Pin GPIO_PIN_15
#define BCD1_2_GPIO_Port GPIOA
#define BCD1_1_Pin GPIO_PIN_3
#define BCD1_1_GPIO_Port GPIOB
#define BCD1_0_Pin GPIO_PIN_4
#define BCD1_0_GPIO_Port GPIOB
#define NUM_ANTENNA 6
#define NUM_TRANCEIVERS 2
#define MAX_LEN_ANT_LABEL 12
#define MAX_LEN_ANT_LABELS ((MAX_LEN_ANT_LABEL + 1) * NUM_ANTENNA)
#define N_SELECTORS NUM_TRANCEIVERS
#define SCHED_INTERVAL 2000 // 2us
