LuZening/6x2-Antenna-Switch/MCU/Src/main.c

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

/* Includes ------------------------------------------------------------------*/
#include "main.h"

/* USER CODE BEGIN Includes */
#include <string.h>
#include <stdbool.h>
#include <CH395.h>
#include "Delay.h"
#include "Flash_EEPROM.h"
//#include "Lib485.h
/* USER CODE END Includes */

SPI_HandleTypeDef hspi1;

UART_HandleTypeDef huart1;

/* USER CODE BEGIN PV */
// PINS
const PIN_typedef BCD1_0 = {GPIOF, GPIO_PIN_0};
const PIN_typedef BCD1_1 = {GPIOA, GPIO_PIN_10};
const PIN_typedef BCD1_2 = {GPIOA, GPIO_PIN_9};
const PIN_typedef BCD2_0 = {GPIOA, GPIO_PIN_1};
const PIN_typedef BCD2_1 = {GPIOA, GPIO_PIN_0};
const PIN_typedef BCD2_2 = {GPIOF, GPIO_PIN_1};
const PIN_typedef RW485 = {GPIOF, GPIO_PIN_15}; // Placeholder, actually on extended CH395 GPIO7
AntennaSelector_typedef Selector[N_SELECTORS];
// Saved data on EEPROM
SavedData_typedef SavedData;
// TODO: antenna labels non-volatile on FLASH
uint8_t IP[4] = {192, 168, 4, 1};
uint16_t port = 80;
// flags
volatile BOOL flag_PHY_change;
volatile BOOL flag_IP_conflict;
volatile BOOL flag_CH395_ready = FALSE;
const char HTTP_STR_HELLO[] = "Hello\r\n";
// web config
char ant_labels[MAX_LEN_ANT_LABELS] = {0}; // antenna labels
//extern const uint8_t FS_test_buffer[];
/* USER CODE END PV */

void SystemClock_Config(void);
static void MX_GPIO_Init(void);
static void MX_SPI1_Init(void);
static void MX_USART1_UART_Init(void);
static void MX_NVIC_Init(void);
/**
  * @brief  The application entry point.
  * @retval int
  */
int main(void)
{
	uint8_t i;
  /* USER CODE BEGIN 1 */
	Selector[0].PIN_BCD0 = BCD1_0;
	Selector[0].PIN_BCD1 = BCD1_1;
	Selector[0].PIN_BCD2 = BCD1_2;
	Selector[0].sel = 0;
	Selector[1].PIN_BCD0 = BCD2_0;
	Selector[1].PIN_BCD1 = BCD2_1;
	Selector[1].PIN_BCD2 = BCD2_2;
	Selector[0].sel = 0;

  /* USER CODE END 1 */
  

  /* MCU Configuration--------------------------------------------------------*/

  /* Reset of all peripherals, Initializes the Flash interface and the Systick. */
  HAL_Init();

  /* Configure the system clock */
  SystemClock_Config();

  /* Initialize all configured peripherals */
  MX_GPIO_Init();
  MX_SPI1_Init();
  MX_USART1_UART_Init();

  /* Initialize interrupts */
  MX_NVIC_Init();
  /* USER CODE BEGIN 2 */
// Load EEPROM data
  EEPROM.base_addr = EEPROM_BASE_ADDR;
  EEPROM.size = 400;
  EEPROM_ReadBytes(&EEPROM, (uint8_t*)&SavedData, sizeof(SavedData_typedef));
  if(SavedData.EEPROM_valid_ID != EEPROM_VALID_BYTE)
  {
	  // create a new EEPROM image
	  for(i=0; i<NUM_ANTENNA; ++i)
	  {
		  strcpy(SavedData.ant_labels[i], "Ant");
		  SavedData.ant_labels[i][4] = '1' + i;
		  SavedData.ant_labels[i][5] = 0;
	  }
	  SavedData.EEPROM_valid_ID = EEPROM_VALID_BYTE;
	  EEPROM_WriteBytes(&EEPROM, (uint8_t*)&SavedData, sizeof(SavedData_typedef));
	  EEPROM_ReadBytes(&EEPROM, (uint8_t*)&SavedData, sizeof(SavedData_typedef));
  }
  DEBUG_LOG("Self checking...\n");
//   Check FS
  // USART
//  begin_serial485(p485, &huart1, RW485, SCHED_INTERVAL / 1000);
//  HAL_UART_Receive_IT(&huart1, p485->rx_buffer, 1);
  // don't forget to override the callback function of USART1
//   Check ch395
	Delay_ms(500); // wait for CH395 being ready from power on`	q1was
RESET_CH395:
	CH395CMDReset();
	Delay_ms(500); // wait for CH395 being ready from power on`	q1was
	// initialize CH395 GPIO settings to INPUT/PULL DOWN
	CH395WriteGPIOAddr(GPIO_DIR_REG, 0);
	CH395WriteGPIOAddr(GPIO_PU_REG, 0);
	CH395WriteGPIOAddr(GPIO_PD_REG, 0xff);
  // initialize TCP server
  flag_CH395_ready = CH395TCPServerStart(*(uint32_t*)IP, port);
  //CH395SetBuffer();
  flag_PHY_change = FALSE;
  flag_IP_conflict = FALSE;
  /* USER CODE END 2 */

  /* Infinite loop */
  /* USER CODE BEGIN WHILE */
  while (1)
  {
	  // handle CH395 interrupt flags
	  if(flag_PHY_change || flag_IP_conflict) goto RESET_CH395;
	  if(flag_CH395_ready && ch395.RX_received)
	  {
		  HTTPHandle(&ch395);
	  }
	  // execute 485 command
//	  if(p485->is_command_ready)
//	  {
//		  if(execute_command(p485))
//		  {
//			  send_serial485(p485, "\r");
//		  }
//		  else
//			  send_serial485(p485, "?>\r");
//	  }
    /* USER CODE END WHILE */

    /* USER CODE BEGIN 3 */
  }
  /* USER CODE END 3 */
}

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
/* USER CODE BEGIN 4 */
//void HAL_UART_RxCpltCallback(UART_HandleTypeDef *huart)
//{
//	onReceived_serial485(p485);
//}

void interrupt_CH395()
{
	uint8_t glob_int_status, sock_int_status, i;
	BEGIN_INT_CH395:
	// read global int status
	glob_int_status = CH395CMDGetGlobIntStatus();
//	if(glob_int_status & GINT_STAT_UNREACH)
//	{
//	}
//	if(glob_int_status & GINT_STAT_IP_CONFLI)
//	{
//		flag_IP_conflict = TRUE;
//	}
	if(glob_int_status & GINT_STAT_PHY_CHANGE)
	{
		flag_PHY_change = TRUE;
	}
	glob_int_status >>= 4; // get socket interrupt status
	if(!glob_int_status) goto END_INT_CH395;
	// handle SOCKET interrupts
	for(i=1; i<=NUM_SOCKETS; ++i)
	{
		glob_int_status >>= 1;
		if(glob_int_status & 1) // the LSB of glob_int_status indicates SOCK#i interrupt status
		{
			sock_int_status = CH395GetSocketInt(i);
			if(sock_int_status & SINT_STAT_SENBUF_FREE) // Send buffer free
			{
				ch395.TX_available |= (1 << i);
//				if(ch395.SOCK_responding == i)
//				{
//					HTTPRequestParseState* pS = parseStates +i -1;
//					if(pS->response_stage == RESPONSE_CONTENT_REMAIN) // continue the sending process
//					{
//						uint16_t len = pS->len_response_content_remain;
//						CH395SendData(i, pS->response_content, ((len<MAX_SIZE_PACK)?(len):(len=MAX_SIZE_PACK)));
//						// sent
//						pS->len_response_content_remain -= len;
//						pS->response_content += len; // move the cursor
//						if(pS->len_response_content_remain == 0)
//							resetHTTPParseState(pS);
//						// TODO: multiple packages
//					}
//					else if(pS->response_stage == RESPONSE_PREPARED) // start the sending process
//					{
//						uint16_t max_len_content = MAX_SIZE_PACK - pS->len_response_header;
//						uint16_t len_content_this_time = ((pS->len_response_content_remain < max_len_content)
//								? (pS->len_response_content_remain)
//										: (max_len_content));
//						CH395StartSendingData(i, pS->len_response_header + len_content_this_time);
//						CH395ContinueSendingData(pS->response_header, pS->len_response_header);
//						CH395ContinueSendingData(pS->response_content, len_content_this_time);
//						CH395Complete();
//						pS->len_response_content_remain -= len_content_this_time;
//						pS->response_content += len_content_this_time;
//						if(pS->len_response_content_remain == 0) // all content completely sent this time
//						{
//							ch395.SOCK_responding = -1;
//							// TODO: enque next sock to respond
//							pS->response_stage = RESPONSE_NOT_PREPARED;
//						}
//						else // content remained to be sent next time
//						{
//							pS->response_stage = RESPONSE_CONTENT_REMAIN;
//						}
//					}
//				}
			}

			if(sock_int_status & SINT_STAT_RECV) // data received on SOCK i
			{
				HTTPRequestParseState* pS = parseStates + i - 1;
				uint16_t len = CH395GetRecvLength(i);
				CH395GetRecvData(i, (len < CH395_SIZE_BUFFER)?(len):(len = CH395_SIZE_BUFFER-1), ch395.buffer);
				ch395.buffer[len] = 0; // terminate the recved text stream
				resetHTTPParseState(pS);
				pS->sock_index = i;
				if(parse_http(pS, ch395.buffer))
				{
					ch395.RX_received |= (1 << i);
					if(ch395.SOCK_responding < 0) // no socket currently responding to
						ch395.SOCK_responding = i;
				}
				CH395ClearRecvBuf(i);
			}
			if(sock_int_status & SINT_STAT_CONNECT) // SOCK i connected
			{
				ch395.socket_connected |= (1 << i);
			}
			if(sock_int_status & SINT_STAT_DISCONNECT) // SOCK i disconnected
			{
				ch395.socket_connected &= ~(1<<i);
				ch395.RX_received &= ~(1<<i);
				if(ch395.SOCK_responding == i) ch395.SOCK_responding = -1; // release the responding socket flag
			}
//			if(sock_int_status & SINT_STAT_TIM_OUT)
//			{
//			}
		}
	}
	END_INT_CH395:
	return;
//	if(HAL_GPIO_ReadPin(CH395_INT_GPIO_Port, CH395_INT_Pin) == GPIO_PIN_RESET) goto BEGIN_INT_CH395;
}

void switch_Antenna(uint8_t A, uint8_t B)
{
	uint8_t i;
	Selector[0].sel = A;
	Selector[1].sel = B;
	if(A==B && A>0) return;
	for(i=0; i<N_SELECTORS; ++i)
	{
		PIN_typedef pin0 = Selector[i].PIN_BCD0;
		PIN_typedef pin1 = Selector[i].PIN_BCD1;
		PIN_typedef pin2 = Selector[i].PIN_BCD2;
		uint8_t val = Selector[i].sel;
		HAL_GPIO_WritePin(pin0.group, pin0.pin, val & 1);
		HAL_GPIO_WritePin(pin1.group, pin1.pin, (val >> 1) & 1);
		HAL_GPIO_WritePin(pin2.group, pin2.pin, (val >> 2) & 2);
	}
}

uint8_t get_Antenna() //0-3:SEL1 4-7:SEL2
{
	uint8_t d = CH395ReadGPIOAddr(GPIO_IN_REG); // read CH395 GPIO
	uint8_t res = 0;
	res |= (d >> BCDM1_0) & 1;// bit 0: BCDM1_0
	res |= ((d >> BCDM1_1) & 1) << 1;// bit 1: BCDM1_1
	res |= ((d >> BCDM1_2) & 1) << 2;// bit 2: BCDM1_2
	res |= ((d >> BCDM2_0) & 1) << 4;// bit 0: BCDM2_0
	res |= ((d >> BCDM2_1) & 1) << 5;// bit 1: BCDM1_1
	res |= ((d >> BCDM2_2) & 1) << 6;// bit 1: BCDM1_1
	return res;
}
/* USER CODE END 4 */
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
