LuZening/6x2-Antenna-Switch/MCU2/Src/HTTPResponders.c

/*
 * HTTPResponders.c
 *
 *  Created on: 2019年9月22日
 *      Author: Zening
 */
#include <string.h>
#include "main.h"
#include "HTTPServer.h"
#include "FS.h"
#include "Flash_EEPROM/Flash_EEPROM.h"
#include "Config/Config.h"


/* URI: /
 * METHOD: GET
 * Usage: Homepage*/
void onHome(HTTPRequestParseState *pS)
{
	/* Websocket */
	if(pS->connection == UPGRADED_WS)
	{
		return;
	}
	/* plain HTTP */
	else
	{
		strcat(pS->URI, "index.html");
		HTTPonNotFound(pS);
	}
}

/* URI: /switch
 * METHOD: POST
 * Args: sel1=[0-6|255]&sel2=[0-6|255]
 * Usage: switch antenna */
void onSwitch(HTTPRequestParseState* pS)
{
	// arguments my not be fully filled
//	const char *A = getHTTPArg(pS, "sel1");
//	const char *B = getHTTPArg(pS, "sel2");
	uint8_t antnums[N_SELECTORS];
	char argname[8] = "sel";
	for(uint8_t i = 0; i < N_SELECTORS; ++i)
	{
		argname[3] = '1' + i;
		argname[4] = 0;
		const char* sV = getHTTPArg(pS, argname);
		uint8_t v = 255; // 255 means no change
		if(sV) v = atou8(sV); // if seli does not exist, treat it as 255
		antnums[i] = v;
	}

	int8_t r = switch_Antenna(antnums, N_SELECTORS);

	/* Websocket */
	if(pS->connection == UPGRADED_WS)
	{
		if(r == 0) // OK
		{
			WSSendStr(pS, "/switch", "response=OK\r\n");
		}
		else
		{
			WSSendStr(pS, "/switch", "response=Invalid\r\n");
		}
	}
	/* plain HTTP */
	else
	{
		if(r == 0) // OK
		{
			HTTPSendStr(pS, 200, "response=OK\r\n");
//			HTTPredirect(pS, "/");
		}
		else
		{
			HTTPSendStr(pS, 300, "response=Invalid\r\n");
		}
	}
}

/* URI: /getalloc
 * METHOD: GET
 * Responds: sel1=%d&sel2=%d
 * Usage: get current antenna allocation
 * */
int make_ant_alloc_str(char* buf)
{
	char* p = buf;
	uint8_t antnums[N_SELECTORS];
	get_Antenna_real_BCDs(antnums, N_SELECTORS);
	strcpy(p, "sel1=");
	p+=5;
	*p = (antnums[0]) + '0'; // "sel1=%d"
	p++;
	strcpy(p, "&sel2="); // "sel1=%d&sel2="
	p+=6;
	*p = antnums[1] + '0'; // "sel1=%d&sel2=%d"
	p++;
	strcpy(p, "\r\n");
	p+=2;
	*p = 0;
	return p - buf;
}

void onGetAlloc(HTTPRequestParseState* pS)
{
	static char s_tmp[24];
	int n = make_ant_alloc_str(s_tmp);

	/* Websocket */
	if(pS->connection == UPGRADED_WS)
	{
		WSSendStr(pS, "/getalloc", s_tmp);
	}
	/* plain HTTP */
	else
	{
		HTTPSendStr(pS, 200, s_tmp);
	}
}

/* URI: /status
 * METHOD: GET
 * */
void onStatus(HTTPRequestParseState* pS)
{
	/* Websocket */
	if(pS->connection == UPGRADED_WS)
	{
		WSSendStr(pS, "/status", "Status");
	}
	/* plain HTTP */
	else
	{
		HTTPSendStr(pS, 200, "Status");
	}
}

void onReset(HTTPRequestParseState* pS)
{
	/* Websocket */
	if(pS->connection == UPGRADED_WS)
	{
		WSSendStr(pS, "/reset", "Reset");
	}
	/* plain HTTP */
	else
	{
		HTTPSendStr(pS, 200, "Reset");
	}
//	DEBUG_LOG("Restart\n");
}

/* URI: /setlabel
 * METHOD: POST
 * Args: ant1=name&ant2=name&ant3=name&ant4=name&ant5=name&ant6=name
 * Usage: set antenna label*/
void onSetLabel(HTTPRequestParseState* pS)
{
	uint8_t i;
	char s_tmp[5] = "ant";

	if(pS->argc == 0)
	{
		/* Websocket */
		if(pS->connection == UPGRADED_WS)
		{
			WSSendStr(pS,"/setlabel", "Bad args");
		}
		/* plain HTTP */
		else
		{
			HTTPSendStr(pS, 300, "Bad args");
		}
		return;
	}
	for(i=1; i<=NUM_ANTENNA; ++i)
	{
		u16toa(i, s_tmp+3); //s_tmp = ant[i]
		const char* s_label;
		if((s_label = getHTTPArg(pS, s_tmp)) != NULL)
		{
			// Multibyte encoding is stored in Big-Endian, first byte at the start of the buffer
			// i.e. 金 -> 0xE9 0x87 0x91 (UTF8)
			strlcpy(cfg.sAntNames[i-1], s_label, MAX_LEN_ANT_LABEL);
			isModified = true;
		}
	}

//	EEPROM_WriteBytes(&EEPROM, (uint8_t*)&SavedData, sizeof(SavedData_typedef));
	//HTTPSendStr(pS, 200, "OK");
	/* Websocket */
	if(pS->connection == UPGRADED_WS)
	{

		/* nothing to do */
		WSSendStr(pS, "/setlabel", "response=OK\r\n");
	}
	/* plain HTTP */
	else
	{
//		HTTPredirect(pS, "/");
		HTTPSendStr(pS, 200, "response=OK\r\n");
	}
}

void onGetLabel(HTTPRequestParseState* pS)
{
	static char s_tmp[(MAX_LEN_ANT_LABEL+5) * NUM_ANTENNA];
	uint8_t i;
	char* s = s_tmp;
	for(i=0; i<NUM_ANTENNA; ++i)
	{
		s = strcpy_f(s, "ant");
		*s = i + '1';
		s++;
		*s = '=';
		s++;
		s = strncpy_f(s, cfg.sAntNames[i], MAX_LEN_ANT_LABEL);
		isModified = true;
		if(i != NUM_ANTENNA-1)
		{
			*s = '&';
			s++;
		}
	}
	/* Websocket */
	if(pS->connection == UPGRADED_WS)
	{
		/* nothing to do */
		WSSendStr(pS, "/getlabel", s_tmp);
	}
	/* plain HTTP */
	else
	{
		HTTPSendStr(pS, 200, s_tmp);
	}
}

/* URI: /setport
 * METHOD: POST
 * Args: portHTTP=80
 * Usage: switch antenna */
void onSetPort(HTTPRequestParseState *pS)
{
	const uint8_t MAXLEN = 5;
	if(pS->argc < 1)
	{
		/* Websocket */
		if(pS->connection == UPGRADED_WS)
			/* nothing to do */
			WSSendStr(pS, "/setport", "Bad args" );
		/* plain HTTP */
		else
			HTTPSendStr(pS, 300, "Bad args");
		return;
	}

	const char* s;
	uint16_t v = 0;
	s = getHTTPArg(pS, "portHTTP");
	if (s)
	{
		uint16_t len = strnlen(s, MAXLEN);
		if(len <= MAXLEN && len > 0)
		{
			v = atou16(s);
		}
	}
	if(v)
	{
		cfg.portHTTP = (uint16_t)v;
		isModified = true;
//		HTTPredirect(pS, "/");
	}
	else
	{
		/* Websocket */
		if(pS->connection == UPGRADED_WS)
			WSSendStr(pS, "/setport", "Bad HTTP port number");
		/* plain HTTP */
		else
			HTTPSendStr(pS, 300, "Bad HTTP port number");
		return;
	}

#if 0
	v = 0;
	s = getHTTPArg(pS, "portTCP");
	if (s)
	{
		uint16_t len = strnlen(s, MAXLEN);
		if(len <= MAXLEN && len > 0)
		{
			v = atou16(s);
		}
	}
	if(v)
	{
		cfg.portTCP = (uint16_t)v;
		isModified = true;
//		HTTPredirect(pS, "/");
	}
	else
	{
		/* Websocket */
		if(pS->connection == UPGRADED_WS)
			WSSendStr(pS, "/setport","Bad HTTP port number");
		/* plain HTTP */
		else
			HTTPSendStr(pS, 300, "Bad HTTP port number");
		return;
	}
#endif
	/* Websocket */
	if(pS->connection == UPGRADED_WS)
		/*nothing*/
		return;
	/* plain HTTP */
	else
//		HTTPredirect(pS, "/");
		HTTPSendStr(pS, 200, "response=OK\r\n");

//	EEPROM_WriteBytes(&EEPROM, (uint8_t*)&SavedData, sizeof(SavedData_typedef));
	//HTTPSendStr(pS, 200, "OK");

}


void onGetPort(HTTPRequestParseState* pS)
{
	static char s_tmp[9+5+9+5+1]; // portHTTP=65535&portTCP=65535
	char* s = s_tmp;
	uint16_t port;

	// MAXLEN = 9 + 5
	strcpy(s, "portHTTP=");
	s += 9;
	port = cfg.portHTTP;
	s += u16toa(port, s);

#if 0
	// MAXLEN = 9 + 5
	strcpy(s, "&portTCP=");
	s += 9;
	port = cfg.portTCP;
	s += u16toa(port, s);
#endif

	*s = '\0';
	/* Websocket */
	if(pS->connection == UPGRADED_WS)
		WSSendStr(pS, "/getport", s_tmp);
	/* plain HTTP */
	else
		HTTPSendStr(pS, 200, s_tmp);
}

/* Create socket status string for broadcast
 * Returns: length of the string (without null terminator)
 * New compact format: s0=H&s1=W&s2=-&s7=U\r\n
 * H=HTTP, W=WebSocket, T=TCP, U=UDP, -=DISCONNECTED, I=IDLE
 * */
int make_socket_status_str(char* buf)
{
	char* s = buf;
	uint8_t i;
	uint8_t first = 1;

	// Build response string for sockets 1-6 only (skip sock0=listener, sock7=UDP)
	for(i = 1; i < CH395_SOCKS_AVAIL - 1; ++i)
	{
		// Add separator if not first socket
		if(!first)
		{
			*s = '&';
			s++;
		}
		first = 0;

		// Socket name: s1, s2, etc.
		*s = 's';
		s++;
		*s = i + '0';
		s++;
		*s = '=';
		s++;

		// Check if socket is connected
		if(ch395.socket_connected & (1U << i))
		{
			// Socket is connected - show protocol
			uint8_t protocol = ch395.cfg.protocols[i];

			switch(protocol)
			{
			case CH395_PROTOCOL_HTTP:
				// Check if this is actually WebSocket (upgraded from HTTP)
				if(i > 0 && i < NUM_SOCKETS)
				{
					HTTPRequestParseState *pSockState = &parseStates[i-1];
					if(pSockState->connection == UPGRADED_WS)
					{
						*s = 'W'; // WebSocket
						s++;
					}
					else
					{
						*s = 'H'; // HTTP
						s++;
					}
				}
				else
				{
					*s = 'H'; // HTTP
					s++;
				}
				break;
			case CH395_PROTOCOL_TCP:
				*s = 'T'; // TCP
				s++;
				break;
			case CH395_PROTOCOL_UDP:
				*s = 'U'; // UDP
				s++;
				break;
			case CH395_PROTOCOL_NOT_USED:
			default:
				*s = 'I'; // IDLE
				s++;
				break;
			}
		}
		else
		{
			// Socket is not connected
			*s = '-'; // DISCONNECTED
			s++;
		}
	}

	// Terminate the string
	*s = '\r';
	s++;
	*s = '\n';
	s++;
	*s = 0;

	return s - buf;
}

/* URI: /socket
 * METHOD: GET
 * Responds: sock0=HTTP:80&sock1=WS:80&sock2=DISCONNECTED&...
 * Usage: get CH395 socket status and protocols
 * */
void onGetSocket(HTTPRequestParseState* pS)
{
	static char s_tmp[128]; // Buffer for response
	int n = make_socket_status_str(s_tmp);

	/* Send response */
	/* Websocket */
	if(pS->connection == UPGRADED_WS)
	{
		WSSendStr(pS, "/socket", s_tmp);
	}
	/* plain HTTP */
	else
	{
		HTTPSendStr(pS, 200, s_tmp);
	}
}


HTTPWSResponder_typedef HTTPWSResponders[] ={
		{.uri="/", .func=onHome},
		{.uri = "/switch", .func=onSwitch},
		{.uri = "/getalloc", .func=onGetAlloc},
		{.uri = "/status", .func=onStatus},
		{.uri = "/reset", .func=onReset},
		{.uri = "/setlabel", .func=onSetLabel},
		{.uri = "/getlabel", .func=onGetLabel},
		{.uri = "/setport", .func=onSetPort},
		{.uri = "/getport", .func=onGetPort},
		{.uri = "/socket", .func=onGetSocket},
};
