LuZening/6x2-Antenna-Switch/MCU2/Inc/Lib485_user_define.h

/*
 * Lib485_user_define.h
 *
 *  Created on: 2023年9月13日
 *      Author: cpholzn
 */

#ifndef LIB485_USER_DEFINE_H_
#define LIB485_USER_DEFINE_H_

#define LIB485_CRC_POLY 0xA001

#define LIB485_DMA_BUFFER_SIZE 256
#define LIB485_COMM_BUFFER_SIZE 256
#define LIB485_TIMEOUT_RX 1000
#define LIB485_DELIM "\r"


#endif /* LIB485_USER_DEFINE_H_ */
