LuZening/6x2-Antenna-Switch/MCU/Src/CH395.c

/*
 * CH395.C
 *
 *  Created on: Sep 14, 2019
 *      Author: Zening
 */

#include <CH395.h>
#include <CH395CMD.h>
#include "Delay.h"
void CH395SetBuffer()
{
	uint8_t i;
	uint8_t blk = 0;
	for(i=0; i < 6; ++i)
	{
		CH395SetSocketRecvBuf(i, blk, 4);
		blk += 4;
		CH395SetSocketSendBuf(i, blk, 4);
		blk += 4;
	}
}

BOOL CH395TCPServerStart(uint32_t ip, uint16_t port)
{
	uint8_t i;
	// Initialize Stack
	CH395CMDInitCH395();
	ch395.RX_received = 0;
	ch395.TX_available= 0;
	ch395.SOCK_responding = -1;
	// Check PHY
	i=0;
	do
	{
		Delay_ms(100);
		uint8_t phy = CH395CMDGetPHYStatus();
		if(phy != (uint8_t)1) break; // PHY connected
		++i;
	}while(i<5);
	if(i >= 5) return FALSE;
	Delay_ms(200);
	// DHCP
	if(CH395DHCPEnable(TRUE) != 0)
	{
		// DHCP not enabled
		CH395CMDSetIPAddr((uint8_t*)(&ip)); // set IP address;
		CH395CMDSetGWIPAddr((uint8_t*)(&ip)); // set gateway IP
	}
	//enable multi connections
	CH395SetStartPara(FUN_PARA_FLAG_TCP_SERVER);
	// set sockets
	for(i=0; i<CH395_SOCKS_AVAIL; ++i)
	{
		CH395SetSocketProtType(i, PROTO_TYPE_TCP); // set SOCKET 0 to be TCP server
		CH395SetSocketSourPort(i, port);
	}

	CH395OpenSocket(0); // open socket 0
	uint8_t s = CH395TCPListen(0); // start lisening
	return s;
}
