LuZening/6x2-Antenna-Switch/(commit log)

2019-04-14 SCH and PCB
    [AntennaSwitch_6x2 - Copy.kicad_pcb, AntennaSwitch_6x2.kicad_pcb, AntennaSwitch_6x2.sch, AntennaSwitch_6x2_back.kicad_pcb, Interlock.sch, Power.sch, Remote.sch]
2019-05-01 Relay Board SCH
    [AntennaSwitch_6x2.kicad_pcb, AntennaSwitch_6x2_RelayBoard.kicad_pcb, AntennaSwitch_6x2_RelayBoard.sch, Power.sch]
2019-05-01 Relay Board PCB first draft
    [AntennaSwitch_6x2.kicad_pcb, AntennaSwitch_6x2_RelayBoard.kicad_pcb]
2019-06-08 manufacturing files
    [AntennaSwitch_6x2 - Copy.kicad_pcb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]
2019-09-17 FS Tools
    [AntennaSwitch_6x2-Bottom_Cu.gbr, AntennaSwitch_6x2-Bottom_Mask.gbr, AntennaSwitch_6x2-Bottom_Paste.gbr, AntennaSwitch_6x2-Bottom_Silk.gbr, AntennaSwitch_6x2-EdgeCuts.gbr, AntennaSwitch_6x2-NPTH.drl, AntennaSwitch_6x2-PTH.drl, AntennaSwitch_6x2-Top_Cu.gbr]
2019-11-01 New control board design
    [AntennaSwitch_6x2 - Copy.kicad_pcb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]
2019-11-01 Control Board 2 routed
    [AntennaSwitch_6x2 - Copy.kicad_pcb, AntennaSwitch_6x2.dsn, AntennaSwitch_6x2.kicad_pcb, Interlock.sch]
2024-03-04 2024 ver
    [AntennaSwitch_6x2 - Copy (2).kicad_pcb, AntennaSwitch_6x2 - Copy.kicad_pcb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]
2025-07-21 Start to add support for WebSocket
    [AntennaSwitch_6x2_RelayBoard.kicad_pcb, AntennaSwitch_6x2_RelayBoard.sch]
2025-10-19 Add support for RS485
    [Antenna Switch 6x2 New.elf.cfg]
2026-03-30 Add support to socket status display
    [AntennaSwitch_6x2 - Copy (2).kicad_pcb, AntennaSwitch_6x2 - Copy.kicad_pcb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]
